WHH3844/CAR_DASHBOARD/Docs/Analysis/05_仪表盘定版测试计划.md

# CAR_DASHBOARD 仪表盘 CAN / UDS / 回归定版测试计划

版本：v1.0  
日期：2026-07-29

## 1. 目标与环境

目标：验证 v1.0 CAN、UDS、Dem、NvM 和控制域接口与代码、矩阵一致。

建议环境：

- Keil MDK ARMCC 5.06 update 7
- GD32F470ZGT6 目标板
- PCAN-USB 或等效 CAN 工具，500 kbit/s
- UDS 测试脚本或 PCAN 手工发送
- 串口日志和 LCD 同时观察
- 可选：S32K144 控制域板

所有数值除特别说明外均以十六进制填写。标准 CAN 信号按矩阵 LE；UDS 多字节数值按 BE。

## 2. 构建回归

| ID | 步骤 | 预期 |
|---|---|---|
| BUILD-01 | 执行 `D:\Keil5\UV4\UV4.exe -b D:\MCU\Project\car\CAR_DASHBOARD\Project\CAR_DASHBOARD.uvprojx -j0 -o D:\MCU\Project\car\CAR_DASHBOARD\Project\Objects\interface_v1_build.log` | 退出码 0，0 error |
| BUILD-02 | 检查 `Project/Objects/CAR_DASHBOARD.hex` | 文件存在且时间戳更新 |
| BUILD-03 | 搜索 interface_v1_build.log 的 warning/error | 不新增接口相关 warning；已有 warning 单独记录 |

## 3. PCAN 接收测试

### 0x321 Powertrain

| 用例 | 发送帧 | 预期 |
|---|---|---|
| CAN-RX-321-01 | `0x321: E8 03 20 03 32 64 28 7D` | 车速 raw=1000 -> 100.0 km/h；转速 800 rpm；其余有效 |
| CAN-RX-321-02 | `0x321: FF 1F FF FF FF FF FF FF` | 六个信号均无效；UI 不出现异常大值 |
| CAN-RX-321-03 | 停止发送超过 100 ms | Powertrain freshness 失效并触发接收超时监控 |

### 0x322 Body

| 用例 | 发送帧 | 预期 |
|---|---|---|
| CAN-RX-322-01 | `0x322: 2D 1F 17 0F 01 80 00 00` | 点火/挡位、四门、安全带、灯光/转向/驻车、四故障灯、洗涤液和环境光均按位显示 |
| CAN-RX-322-02 | `B5=FF` | 环境光无效，其余车身状态仍有效 |
| CAN-RX-322-03 | 停止发送超过 500 ms | 车身报文失效，离散警告回到安全显示状态 |

### 0x323 TPMS

| 用例 | 发送帧 | 预期 |
|---|---|---|
| CAN-RX-323-01 | `0x323: 64 64 64 64 50 50 50 50` | 四轮压力/温度均有效 |
| CAN-RX-323-02 | `0x323: FF 64 FF 64 FF 50 FF 50` | FL/RL 压力和温度无效，FR/RR 保持有效 |
| CAN-RX-323-03 | 停止发送超过 3000 ms | 整帧 freshness 失效 |

### 0x324 Config

| 用例 | 步骤 | 预期 |
|---|---|---|
| CAN-RX-324-01 | 上电读取本地 NvM 后发送合法远端配置 | 本次运行期使用远端合法值 |
| CAN-RX-324-02 | 发送非法亮度/主题/语言 | 非法字段不覆盖当前合法值 |
| CAN-RX-324-03 | 远端覆盖后重启且不再发送 0x324 | 重新使用本地 NvM 基线 |

### 0x329 Control Domain Status

CRC8/J1850 覆盖字节：`29 03 B0 B1 B2 B3 B4 B5 B6`。可直接使用的正常样例：

```text
0x329  DLC=8  10 09 00 53 FF FF 01 67
```

该帧表示 v1.0、ADC、RUN、Health=OK、CAN1/CAN2/ADC/SelfTest 正常、无远端故障、Alive=1，末字节 `0x67` 为 CRC8/J1850。

| 用例 | 步骤 | 预期 |
|---|---|---|
| CAN-RX-329-01 | 发送 `10 09 00 53 FF FF 01 67`，并周期发送 0x441 | UI 显示 CDM Online/OK/ADC/RUN |
| CAN-RX-329-02 | CRC 改错 1 bit | 丢弃帧，不更新时间戳 |
| CAN-RX-329-03 | AliveCounter 固定，连续发送 | 判定发送任务疑似冻结并降级 |
| CAN-RX-329-04 | Version 非 10 | 标记接口版本不兼容 |
| CAN-RX-329-05 | 停止发送超过 1500 ms | 应用状态 stale，本机仪表继续工作 |

### 0x441 NM

| 用例 | 步骤 | 预期 |
|---|---|---|
| CAN-RX-441-01 | 周期发送合法 NM | CDM NM online |
| CAN-RX-441-02 | 停止发送超过 3000 ms | CDM NM offline，不影响 0x329 独立状态机 |

## 4. PCAN 发送测试

| 用例 | 触发 | 预期 |
|---|---|---|
| CAN-TX-325-01 | 正常运行 | 每 100 ms 一帧，字段严格匹配矩阵；无里程源时 B3..4=`FF FF` |
| CAN-TX-326-01 | 无 DTC 正常运行 | DTC count=0，SelfTestPassed 和会话位正确 |
| CAN-TX-326-02 | 注入一个确认 DTC | DTC count/LastFaultId/NvMDirty 与 Dem 一致 |
| CAN-TX-327-01 | 单击按键 | 发送一次事件，Counter +1 |
| CAN-TX-327-02 | 临时阻断发送后恢复 | 事件不丢失，恢复后发送；不重复消费 |
| CAN-TX-440-01 | 正常运行 | NodeAddress=`40`，NMState=NormalOperation |
| CAN-TX-328-01 | 未接 FatFs | 明确显示未挂载/Stub，文件号为 0 |

## 5. UDS 手工测试表

请求 ID：物理 `0x700`，功能 `0x7DF`；响应 `0x708`。下列负载为 UDS payload，使用 PCAN 时需在前面加 ISO-TP SF 长度字节。

| ID | 寻址 | UDS 请求 | 预期 |
|---|---|---|---|
| UDS-10-01 | 物理 | `10 01` | `50 01 ...` |
| UDS-10-02 | 物理 | `10 03` | `50 03 ...` |
| UDS-10-03 | 功能 | `10 03` | NRC，且会话不改变 |
| UDS-22-01 | 物理 | `22 F1 91` | `62 F1 91` + HW ASCII |
| UDS-22-02 | 物理 | `22 F1 93` | `62 F1 93` + SW ASCII |
| UDS-22-03 | 物理 | `22 F2 00` | BootCounter，uint32 BE |
| UDS-22-04 | 物理 | `22 F2 01` | VehicleSpeed，uint16 BE |
| UDS-22-05 | 物理 | `22 F2 02` | EngineSpeed，uint16 BE |
| UDS-22-06 | 物理 | `22 F2 03` | BatteryVoltage mV，uint16 BE |
| UDS-22-07 | 物理 | `22 F2 04` | RTC，年份 uint16 BE |
| UDS-22-08 | 功能 | `22 F2 01` | 允许只读响应 |
| UDS-22-09 | 物理 | `22 FF FF` | NRC RequestOutOfRange |
| UDS-19-01 | 物理 | `19 01 FF` | DTC 数量 |
| UDS-19-02 | 物理 | `19 02 FF` | 当前单帧能力内返回第一项并与矩阵声明一致 |
| UDS-14-01 | 功能 | `14 FF FF FF` | NRC，DTC 不清除 |
| UDS-14-02 | 物理 | `14 FF FF FF` | DTC 清除 |
| UDS-3E-01 | 物理 | `3E 00` | `7E 00` |
| UDS-3E-02 | 功能 | `3E 00` | 允许 keep-alive，不改变配置 |
| UDS-11-01 | 物理 | `11 01` | NRC ServiceNotSupported |

## 6. Dem / NvM 测试

| 用例 | 步骤 | 预期 |
|---|---|---|
| DEM-01 | 注入少于失败阈值的抖动 | 不产生 Confirmed DTC |
| DEM-02 | 连续失败达到阈值 | TestFailed+Confirmed，occurrence +1，LastFaultId 更新 |
| DEM-03 | 失败状态持续多个周期 | occurrence 不按周期持续增加 |
| DEM-04 | 连续通过达到恢复阈值 | TestFailed 清除，Confirmed 保留 |
| DEM-05 | 物理 0x14 清除 | Confirmed、occurrence 和计数清除 |
| NVM-01 | 写入 DTC 后正常重启 | DTC 状态恢复 |
| NVM-02 | 人为破坏块 CRC | 采用默认值，不使用损坏 payload，并产生存储相关诊断 |
| NVM-03 | 系统配置合法写入并重启 | 从 0x720 块恢复 |

## 7. 显示与降级回归

1. 正常动力/车身/TPMS 帧下 UI 数值和图标正确。
2. 任一单信号无效时只影响对应显示，不把整车状态全部清空。
3. 控制域离线时，LCD、按键、RTC、SHT30、本地 UDS 继续工作。
4. 本地故障和远端故障分开展示。
5. 无 FatFs 时不显示“文件日志正常”。
6. 低电压、显示初始化失败、SDRAM 失败等既有故障路径回归。

## 8. 验收记录

| 项目 | 结果 | 证据 |
|---|---|---|
| 工作簿公式错误扫描 | PASS：0 个公式错误 | 两份 v1.0 工作簿全表扫描 |
| 工作簿视觉检查 | PASS：26 个工作表 | CAN 7 张、诊断 19 张逐表渲染检查 |
| Keil 全量构建 | PASS：0 Error(s), 0 Warning(s) | `Project/Objects/interface_v1_build.log` |
| PCAN 手工测试 | 需实板执行 | 本文第 3、4 节 |
| UDS 手工测试 | 需实板执行 | 本文第 5 节 |
| Dem/NvM 断电测试 | 需实板执行 | 本文第 6 节 |

软件侧可自动完成构建和静态一致性检查；需要 PCAN、实板或断电操作的项目由台架测试人员按本表执行并签字。
