WHH3844/CAR_DASHBOARD/Docs/汽车仪表盘_CAN报文矩阵.xlsx

Sheet: ReadMe
汽车仪表盘 CAN 报文矩阵说明
项目定位 | 基于 GD32F470/GD32F450 + SIT1043QT CAN 收发器的汽车仪表盘学习板，采用 Mini AUTOSAR / AUTOSAR-like 软件架构。
设计目标 | 用于 USB-CAN / 仿真节点发送车辆数据，ICM 仪表接收后显示车速、转速、报警灯、胎压、配置、诊断状态等。
帧格式 | 本版默认使用 Standard CAN 11-bit ID，DLC=8。虽然硬件 CAN 收发器支持 CAN FD 物理层，但 MCU 外设与教学实现优先按 Classic CAN 设计。
字节序 | 默认 Intel LSB，小端格式，方便 GD32/STM32 C 代码打包解析。若后续接真实整车 DBC，需要按对方 DBC 调整。
物理值换算 | Physical = Raw × Resolution + Offset；Raw = (Physical - Offset) / Resolution。Convert 表已给出示例公式。
节点定义 | ICM 为本仪表节点；EMS/BCM/TPMS/IHU/CGW 可由 USB-CAN 上位机或另一块 MCU 模拟。
重要说明 | 这是一版教学与调试用 CAN 矩阵，不是整车厂正式 DBC。先用它把仪表 Demo、RTE/Com、诊断雏形跑通，别又把工程做成大型玄学祭坛。

Sheet: History
版本 | 日期 | 修改人 | 修改内容 | 备注
V0.1 | 2026-05-30 | ChatGPT | 首次建立汽车仪表盘 CAN 报文矩阵 | 参考 Loxi Micro 表格风格，结合当前 ICM 学习板硬件与 Mini AUTOSAR-like 软件架构

Sheet: MsgSummary
Msg ID | Frame Format | BRS | Direction | Tx Node | Rx Node | Msg Name | Msg Type | DLC | Send Type | Cycle(ms) | Delay(ms) | Signal Count | Purpose/Description
0x440 | StandardCAN | 0 | Tx | ICM | All | NM_Autosar_ICM | NM | 8 | Cyclic/Event | 1000 | 0 | 5 | ICM 节点网络管理报文，Mini AUTOSAR-like 学习用
0x441 | StandardCAN | 0 | Rx | SIM/OtherECU | ICM | NM_Autosar_Sim | NM | 8 | Cyclic/Event | 1000 | 0 | 6 | 仿真节点网络管理报文，USB-CAN 或其他节点发送
0x7DF | StandardCAN | 0 | Rx | Tester | ICM/All | Diag_FuncReq | DIAG | 8 | Event | 0 | 0 | 1 | UDS 功能寻址请求，教学级 ISO-TP
0x700 | StandardCAN | 0 | Rx | Tester | ICM | Diag_ICM_PhysReq | DIAG | 8 | Event | 0 | 0 | 1 | UDS 物理寻址请求
0x708 | StandardCAN | 0 | Tx | ICM | Tester | Diag_ICM_Resp | DIAG | 8 | Event | 0 | 0 | 1 | UDS 物理响应
0x321 | StandardCAN | 0 | Rx | EMS/Simulator | ICM | EMS_Powertrain_20ms | DIAG/SIGNAL | 8 | Cyclic | 20 | 0 | 6 | 动力总成与基础车辆数据，用于仪表主界面显示
0x322 | StandardCAN | 0 | Rx | BCM/Simulator | ICM | BCM_BodyStatus_100ms | SIGNAL | 8 | Cyclic/Event | 100 | 0 | 17 | 车身状态与报警灯状态
0x323 | StandardCAN | 0 | Rx | TPMS/Simulator | ICM | TPMS_Status_1000ms | SIGNAL | 8 | Cyclic | 1000 | 0 | 8 | 胎压与胎温状态
0x324 | StandardCAN | 0 | Rx | IHU/CGW/Simulator | ICM | IHU_CGW_Config_500ms | SIGNAL | 8 | Cyclic/Event | 500 | 0 | 9 | 中控/网关发送的仪表配置与主题信息
0x325 | StandardCAN | 0 | Tx | ICM | CGW/Tester | ICM_Status_100ms | SIGNAL | 8 | Cyclic/Event | 100 | 0 | 8 | 仪表运行状态与用户显示状态
0x326 | StandardCAN | 0 | Tx | ICM | CGW/Tester | ICM_DiagStatus_1000ms | DIAG/SIGNAL | 8 | Cyclic/Event | 1000 | 0 | 10 | 仪表自检与故障管理状态
0x327 | StandardCAN | 0 | Tx | ICM | CGW/Tester | ICM_UserInput_Event | SIGNAL | 8 | Event | 0 | 0 | 6 | 按键事件报文，短按/长按/关机请求
0x328 | StandardCAN | 0 | Tx | ICM | CGW/Tester | ICM_LogStatus_1000ms | SIGNAL | 8 | Cyclic/Event | 1000 | 0 | 5 | 日志与 TF 卡状态

Sheet: Matrix
Msg ID 报文标识符 | Frame Format 帧格式 | BRS 波特率切换 | Direction 方向 | Tx Node 发送节点 | Rx Node 接收节点 | Msg Name 报文名称 | Msg Type 报文类型 | Msg Length 报文长度(Byte) | Msg Send Type 报文发送类型 | Msg Cycle Time 周期(ms) | Msg Delay Time 延时(ms) | Signal Name 信号名称 | Multiplexor Type 信号复用类型 | Multiplexed Value 复用值 | Start Byte 起始字节 | Start Bit 起始位 | Bit Length 位长度 | Byte Order 字节序 | Data Type 数据类型 | Resolution 精度 | Offset 偏移 | Signal Min 物理最小值 | Signal Max 物理最大值 | Initial Value(hex) 初始值 | Invalid Value(hex) 无效值 | Unit 单位 | Signal Value Description 信号值描述 | Signal Description 信号描述 | Signal Send Type 信号发送类型 | Remark 备注
0x440 | StandardCAN | 0 | Tx | ICM | All | NM_Autosar_ICM | NM | 8 | Cyclic/Event | 1000 | 0 | ICM_NodeAddress | Normal Signal |  | 0 | 0 | 8 | Intel LSB | Unsigned | 1 | 0 | 0 | 255 | 0x40 | 0xFF |  | 0x40: ICM Node | ICM 节点地址 | OnWrite
0x440 | StandardCAN | 0 | Tx | ICM | All | NM_Autosar_ICM | NM | 8 | Cyclic/Event | 1000 | 0 | ICM_RepeatMessageRequestBit | Normal Signal |  | 1 | 0 | 1 | Intel LSB | Unsigned | 1 | 0 | 0 | 1 | 0x0 | 0x0 |  | 0x0: No Request; 0x1: Request | 重复报文请求位 | OnWrite
0x440 | StandardCAN | 0 | Tx | ICM | All | NM_Autosar_ICM | NM | 8 | Cyclic/Event | 1000 | 0 | ICM_ActiveWakeupBit | Normal Signal |  | 1 | 1 | 1 | Intel LSB | Unsigned | 1 | 0 | 0 | 1 | 0x0 | 0x0 |  | 0x0: Passive Wakeup; 0x1: Active Wakeup | 主动唤醒标志 | OnWrite
0x440 | StandardCAN | 0 | Tx | ICM | All | NM_Autosar_ICM | NM | 8 | Cyclic/Event | 1000 | 0 | ICM_RepeatSts | Normal Signal |  | 2 | 0 | 1 | Intel LSB | Unsigned | 1 | 0 | 0 | 1 | 0x0 | 0x0 |  | 0x0: Not in RMS; 0x1: Stay in RMS | Repeat Message 状态 | OnWrite
0x440 | StandardCAN | 0 | Tx | ICM | All | NM_Autosar_ICM | NM | 8 | Cyclic/Event | 1000 | 0 | ICM_NMState | Normal Signal |  | 2 | 1 | 3 | Intel LSB | Unsigned | 1 | 0 | 0 | 7 | 0x0 | 0x7 |  | 0x0: BusSleep; 0x1: RepeatMessage; 0x2: NormalOperation; 0x3: ReadySleep | 网络管理状态 | OnWrite
0x441 | StandardCAN | 0 | Rx | SIM/OtherECU | ICM | NM_Autosar_Sim | NM | 8 | Cyclic/Event | 1000 | 0 | SIM_NodeAddress | Normal Signal |  | 0 | 0 | 8 | Intel LSB | Unsigned | 1 | 0 | 0 | 255 | 0x41 | 0xFF |  | 0x41: Simulator Node | 仿真节点地址 | OnWrite
0x441 | StandardCAN | 0 | Rx | SIM/OtherECU | ICM | NM_Autosar_Sim | NM | 8 | Cyclic/Event | 1000 | 0 | SIM_RepeatMessageRequestBit | Normal Signal |  | 1 | 0 | 1 | Intel LSB | Unsigned | 1 | 0 | 0 | 1 | 0x0 | 0x0 |  | 0x0: No Request; 0x1: Request | 重复报文请求位 | OnWrite
0x441 | StandardCAN | 0 | Rx | SIM/OtherECU | ICM | NM_Autosar_Sim | NM | 8 | Cyclic/Event | 1000 | 0 | SIM_ActiveWakeupBit | Normal Signal |  | 1 | 1 | 1 | Intel LSB | Unsigned | 1 | 0 | 0 | 1 | 0x0 | 0x0 |  | 0x0: Passive Wakeup; 0x1: Active Wakeup | 主动唤醒标志 | OnWrite
0x441 | StandardCAN | 0 | Rx | SIM/OtherECU | ICM | NM_Autosar_Sim | NM | 8 | Cyclic/Event | 1000 | 0 | SIM_RepeatSts | Normal Signal |  | 2 | 0 | 1 | Intel LSB | Unsigned | 1 | 0 | 0 | 1 | 0x0 | 0x0 |  | 0x0: Not in RMS; 0x1: Stay in RMS | Repeat Message 状态 | OnWrite
0x441 | StandardCAN | 0 | Rx | SIM/OtherECU | ICM | NM_Autosar_Sim | NM | 8 | Cyclic/Event | 1000 | 0 | SIM_NMReq_PowerOn | Normal Signal |  | 2 | 1 | 1 | Intel LSB | Unsigned | 1 | 0 | 0 | 1 | 0x0 | 0x0 |  | 0x0: Inactive; 0x1: Active | 仿真节点请求系统保持唤醒 | OnWrite
0x441 | StandardCAN | 0 | Rx | SIM/OtherECU | ICM | NM_Autosar_Sim | NM | 8 | Cyclic/Event | 1000 | 0 | SIM_NMReq_Diag | Normal Signal |  | 2 | 2 | 1 | Intel LSB | Unsigned | 1 | 0 | 0 | 1 | 0x0 | 0x0 |  | 0x0: Inactive; 0x1: Active | 诊断请求网络保持 | OnWrite
0x7DF | StandardCAN | 0 | Rx | Tester | ICM/All | Diag_FuncReq | DIAG | 8 | Event | 0 | 0 | Diag_FuncReq_Data | Normal Signal |  | 0 | 0 | 64 | Intel LSB | Unsigned | 1 | 0 | 0 | 0 | 0x00 | 0x00 |  |  | 诊断功能寻址请求原始 8 字节数据 | OnWrite | 第一阶段可只透传到 Dcm
0x700 | StandardCAN | 0 | Rx | Tester | ICM | Diag_ICM_PhysReq | DIAG | 8 | Event | 0 | 0 | Diag_ICM_PhyReq_Data | Normal Signal |  | 0 | 0 | 64 | Intel LSB | Unsigned | 1 | 0 | 0 | 0 | 0x00 | 0x00 |  |  | 诊断物理寻址请求原始 8 字节数据 | OnWrite | 支持 0x10/0x22/0x19/0x14/0x31 子集
0x708 | StandardCAN | 0 | Tx | ICM | Tester | Diag_ICM_Resp | DIAG | 8 | Event | 0 | 0 | Diag_ICM_Resp_Data | Normal Signal |  | 0 | 0 | 64 | Intel LSB | Unsigned | 1 | 0 | 0 | 0 | 0x00 | 0x00 |  |  | 诊断响应原始 8 字节数据 | OnWrite | 由 Dcm/CanTp 生成
0x321 | StandardCAN | 0 | Rx | EMS/Simulator | ICM | EMS_Powertrain_20ms | DIAG/SIGNAL | 8 | Cyclic | 20 | 0 | VehicleSpeed | Normal Signal |  | 0 | 0 | 13 | Intel LSB | Unsigned | 0.0625 | 0 | 0 | 511.875 | 0x0000 | 0x1FFF | km/h |  | 车速 | OnWrite | raw = speed / 0.0625
0x321 | StandardCAN | 0 | Rx | EMS/Simulator | ICM | EMS_Powertrain_20ms | DIAG/SIGNAL | 8 | Cyclic | 20 | 0 | EngineSpeed | Normal Signal |  | 2 | 0 | 16 | Intel LSB | Unsigned | 0.25 | 0 | 0 | 16000 | 0x0000 | 0xFFFF | rpm |  | 发动机转速 | OnWrite | raw = rpm / 0.25
0x321 | StandardCAN | 0 | Rx | EMS/Simulator | ICM | EMS_Powertrain_20ms | DIAG/SIGNAL | 8 | Cyclic | 20 | 0 | FuelPercent | Normal Signal |  | 4 | 0 | 8 | Intel LSB | Unsigned | 0.4 | 0 | 0 | 100 | 0x00 | 0xFF | % |  | 油量百分比 | OnWrite | raw 250 = 100%
0x321 | StandardCAN | 0 | Rx | EMS/Simulator | ICM | EMS_Powertrain_20ms | DIAG/SIGNAL | 8 | Cyclic | 20 | 0 | EngineCoolantTemperature | Normal Signal |  | 5 | 0 | 8 | Intel LSB | Signed/Offset | 1 | -40 | -40 | 215 | 0x28 | 0xFF | ℃ |  | 水温，物理值 = raw - 40 | OnWrite
0x321 | StandardCAN | 0 | Rx | EMS/Simulator | ICM | EMS_Powertrain_20ms | DIAG/SIGNAL | 8 | Cyclic | 20 | 0 | OutdoorTemperature | Normal Signal |  | 6 | 0 | 8 | Intel LSB | Signed/Offset | 1 | -40 | -40 | 85 | 0x28 | 0xFF | ℃ |  | 车外温度，物理值 = raw - 40 | OnWrite
0x321 | StandardCAN | 0 | Rx | EMS/Simulator | ICM | EMS_Powertrain_20ms | DIAG/SIGNAL | 8 | Cyclic | 20 | 0 | BatteryVoltage | Normal Signal |  | 7 | 0 | 8 | Intel LSB | Unsigned | 0.1 | 0 | 0 | 25.5 | 0x78 | 0xFF | V |  | 整车/板载供电电压，用于欠压提示 | OnWrite
0x322 | StandardCAN | 0 | Rx | BCM/Simulator | ICM | BCM_BodyStatus_100ms | SIGNAL | 8 | Cyclic/Event | 100 | 0 | IgnitionStatus | Normal Signal |  | 0 | 0 | 2 | Intel LSB | Unsigned | 1 | 0 | 0 | 3 | 0x0 | 0x3 |  | 0x0: OFF; 0x1: ACC; 0x2: ON; 0x3: START | 点火状态 | OnWrite
0x322 | StandardCAN | 0 | Rx | BCM/Simulator | ICM | BCM_BodyStatus_100ms | SIGNAL | 8 | Cyclic/Event | 100 | 0 | GearPosition | Normal Signal |  | 0 | 2 | 4 | Intel LSB | Unsigned | 1 | 0 | 0 | 15 | 0x0 | 0xF |  | 0x0: P; 0x1: R; 0x2: N; 0x3: D; 0x4: S; 0x5: M | 挡位 | OnWrite
0x322 | StandardCAN | 0 | Rx | BCM/Simulator | ICM | BCM_BodyStatus_100ms | SIGNAL | 8 | Cyclic/Event | 100 | 0 | Door_FL_Open | Normal Signal |  | 1 | 0 | 1 | Intel LSB | Unsigned | 1 | 0 | 0 | 1 | 0x0 | 0x0 |  | 0x0: Closed; 0x1: Open | 左前门状态 | OnWrite
0x322 | StandardCAN | 0 | Rx | BCM/Simulator | ICM | BCM_BodyStatus_100ms | SIGNAL | 8 | Cyclic/Event | 100 | 0 | Door_FR_Open | Normal Signal |  | 1 | 1 | 1 | Intel LSB | Unsigned | 1 | 0 | 0 | 1 | 0x0 | 0x0 |  | 0x0: Closed; 0x1: Open | 右前门状态 | OnWrite
0x322 | StandardCAN | 0 | Rx | BCM/Simulator | ICM | BCM_BodyStatus_100ms | SIGNAL | 8 | Cyclic/Event | 100 | 0 | Door_RL_Open | Normal Signal |  | 1 | 2 | 1 | Intel LSB | Unsigned | 1 | 0 | 0 | 1 | 0x0 | 0x0 |  | 0x0: Closed; 0x1: Open | 左后门状态 | OnWrite
0x322 | StandardCAN | 0 | Rx | BCM/Simulator | ICM | BCM_BodyStatus_100ms | SIGNAL | 8 | Cyclic/Event | 100 | 0 | Door_RR_Open | Normal Signal |  | 1 | 3 | 1 | Intel LSB | Unsigned | 1 | 0 | 0 | 1 | 0x0 | 0x0 |  | 0x0: Closed; 0x1: Open | 右后门状态 | OnWrite
0x322 | StandardCAN | 0 | Rx | BCM/Simulator | ICM | BCM_BodyStatus_100ms | SIGNAL | 8 | Cyclic/Event | 100 | 0 | SeatbeltDriver | Normal Signal |  | 1 | 4 | 1 | Intel LSB | Unsigned | 1 | 0 | 0 | 1 | 0x0 | 0x0 |  | 0x0: Buckled; 0x1: Unbuckled | 主驾安全带 | OnWrite
0x322 | StandardCAN | 0 | Rx | BCM/Simulator | ICM | BCM_BodyStatus_100ms | SIGNAL | 8 | Cyclic/Event | 100 | 0 | LowBeamStatus | Normal Signal |  | 2 | 0 | 1 | Intel LSB | Unsigned | 1 | 0 | 0 | 1 | 0x0 | 0x0 |  | 0x0: Off; 0x1: On | 近光灯 | OnWrite
0x322 | StandardCAN | 0 | Rx | BCM/Simulator | ICM | BCM_BodyStatus_100ms | SIGNAL | 8 | Cyclic/Event | 100 | 0 | HighBeamStatus | Normal Signal |  | 2 | 1 | 1 | Intel LSB | Unsigned | 1 | 0 | 0 | 1 | 0x0 | 0x0 |  | 0x0: Off; 0x1: On | 远光灯 | OnWrite
0x322 | StandardCAN | 0 | Rx | BCM/Simulator | ICM | BCM_BodyStatus_100ms | SIGNAL | 8 | Cyclic/Event | 100 | 0 | TurnLampStatus | Normal Signal |  | 2 | 2 | 2 | Intel LSB | Unsigned | 1 | 0 | 0 | 3 | 0x0 | 0x3 |  | 0x0: Off; 0x1: Left; 0x2: Right; 0x3: Hazard | 转向灯/双闪状态 | OnWrite
0x322 | StandardCAN | 0 | Rx | BCM/Simulator | ICM | BCM_BodyStatus_100ms | SIGNAL | 8 | Cyclic/Event | 100 | 0 | ParkingBrake | Normal Signal |  | 2 | 4 | 1 | Intel LSB | Unsigned | 1 | 0 | 0 | 1 | 0x0 | 0x0 |  | 0x0: Released; 0x1: Applied | 驻车制动 | OnWrite
0x322 | StandardCAN | 0 | Rx | BCM/Simulator | ICM | BCM_BodyStatus_100ms | SIGNAL | 8 | Cyclic/Event | 100 | 0 | MIL_Lamp | Normal Signal |  | 3 | 0 | 1 | Intel LSB | Unsigned | 1 | 0 | 0 | 1 | 0x0 | 0x0 |  | 0x0: Off; 0x1: On | 发动机故障灯 | OnWrite
0x322 | StandardCAN | 0 | Rx | BCM/Simulator | ICM | BCM_BodyStatus_100ms | SIGNAL | 8 | Cyclic/Event | 100 | 0 | ABS_Lamp | Normal Signal |  | 3 | 1 | 1 | Intel LSB | Unsigned | 1 | 0 | 0 | 1 | 0x0 | 0x0 |  | 0x0: Off; 0x1: On | ABS 故障灯 | OnWrite
0x322 | StandardCAN | 0 | Rx | BCM/Simulator | ICM | BCM_BodyStatus_100ms | SIGNAL | 8 | Cyclic/Event | 100 | 0 | Airbag_Lamp | Normal Signal |  | 3 | 2 | 1 | Intel LSB | Unsigned | 1 | 0 | 0 | 1 | 0x0 | 0x0 |  | 0x0: Off; 0x1: On | 安全气囊故障灯 | OnWrite
0x322 | StandardCAN | 0 | Rx | BCM/Simulator | ICM | BCM_BodyStatus_100ms | SIGNAL | 8 | Cyclic/Event | 100 | 0 | Brake_Lamp | Normal Signal |  | 3 | 3 | 1 | Intel LSB | Unsigned | 1 | 0 | 0 | 1 | 0x0 | 0x0 |  | 0x0: Off; 0x1: On | 制动系统故障灯 | OnWrite
0x322 | StandardCAN | 0 | Rx | BCM/Simulator | ICM | BCM_BodyStatus_100ms | SIGNAL | 8 | Cyclic/Event | 100 | 0 | WasherFluidLow | Normal Signal |  | 4 | 0 | 1 | Intel LSB | Unsigned | 1 | 0 | 0 | 1 | 0x0 | 0x0 |  | 0x0: Normal; 0x1: Low | 玻璃水液位低 | OnWrite
0x322 | StandardCAN | 0 | Rx | BCM/Simulator | ICM | BCM_BodyStatus_100ms | SIGNAL | 8 | Cyclic/Event | 100 | 0 | AmbientLightLevel | Normal Signal |  | 5 | 0 | 8 | Intel LSB | Unsigned | 1 | 0 | 0 | 100 | 0x32 | 0xFF | % |  | 环境光强度百分比，可用于自动背光 | OnWrite
0x323 | StandardCAN | 0 | Rx | TPMS/Simulator | ICM | TPMS_Status_1000ms | SIGNAL | 8 | Cyclic | 1000 | 0 | LF_TirePressure | Normal Signal |  | 0 | 0 | 8 | Intel LSB | Unsigned | 0.0275 | 0 | 0 | 3.5 | 0x00 | 0xFF | Bar |  | 左前胎压 | OnWrite
0x323 | StandardCAN | 0 | Rx | TPMS/Simulator | ICM | TPMS_Status_1000ms | SIGNAL | 8 | Cyclic | 1000 | 0 | RF_TirePressure | Normal Signal |  | 1 | 0 | 8 | Intel LSB | Unsigned | 0.0275 | 0 | 0 | 3.5 | 0x00 | 0xFF | Bar |  | 右前胎压 | OnWrite
0x323 | StandardCAN | 0 | Rx | TPMS/Simulator | ICM | TPMS_Status_1000ms | SIGNAL | 8 | Cyclic | 1000 | 0 | LR_TirePressure | Normal Signal |  | 2 | 0 | 8 | Intel LSB | Unsigned | 0.0275 | 0 | 0 | 3.5 | 0x00 | 0xFF | Bar |  | 左后胎压 | OnWrite
0x323 | StandardCAN | 0 | Rx | TPMS/Simulator | ICM | TPMS_Status_1000ms | SIGNAL | 8 | Cyclic | 1000 | 0 | RR_TirePressure | Normal Signal |  | 3 | 0 | 8 | Intel LSB | Unsigned | 0.0275 | 0 | 0 | 3.5 | 0x00 | 0xFF | Bar |  | 右后胎压 | OnWrite
0x323 | StandardCAN | 0 | Rx | TPMS/Simulator | ICM | TPMS_Status_1000ms | SIGNAL | 8 | Cyclic | 1000 | 0 | LF_TireTemperature | Normal Signal |  | 4 | 0 | 8 | Intel LSB | Signed/Offset | 1 | -40 | -40 | 125 | 0x28 | 0xFF | ℃ |  | 左前胎温，物理值 = raw - 40 | OnWrite
0x323 | StandardCAN | 0 | Rx | TPMS/Simulator | ICM | TPMS_Status_1000ms | SIGNAL | 8 | Cyclic | 1000 | 0 | RF_TireTemperature | Normal Signal |  | 5 | 0 | 8 | Intel LSB | Signed/Offset | 1 | -40 | -40 | 125 | 0x28 | 0xFF | ℃ |  | 右前胎温，物理值 = raw - 40 | OnWrite
0x323 | StandardCAN | 0 | Rx | TPMS/Simulator | ICM | TPMS_Status_1000ms | SIGNAL | 8 | Cyclic | 1000 | 0 | LR_TireTemperature | Normal Signal |  | 6 | 0 | 8 | Intel LSB | Signed/Offset | 1 | -40 | -40 | 125 | 0x28 | 0xFF | ℃ |  | 左后胎温，物理值 = raw - 40 | OnWrite
0x323 | StandardCAN | 0 | Rx | TPMS/Simulator | ICM | TPMS_Status_1000ms | SIGNAL | 8 | Cyclic | 1000 | 0 | RR_TireTemperature | Normal Signal |  | 7 | 0 | 8 | Intel LSB | Signed/Offset | 1 | -40 | -40 | 125 | 0x28 | 0xFF | ℃ |  | 右后胎温，物理值 = raw - 40 | OnWrite
0x324 | StandardCAN | 0 | Rx | IHU/CGW/Simulator | ICM | IHU_CGW_Config_500ms | SIGNAL | 8 | Cyclic/Event | 500 | 0 | ThemeMode | Normal Signal |  | 0 | 0 | 3 | Intel LSB | Unsigned | 1 | 0 | 0 | 7 | 0x0 | 0x7 |  | 0x0: Auto; 0x1: Classic; 0x2: Sport; 0x3: Night | 仪表主题模式 | OnWrite
0x324 | StandardCAN | 0 | Rx | IHU/CGW/Simulator | ICM | IHU_CGW_Config_500ms | SIGNAL | 8 | Cyclic/Event | 500 | 0 | SetLanguage | Normal Signal |  | 0 | 3 | 3 | Intel LSB | Unsigned | 1 | 0 | 0 | 7 | 0x0 | 0x7 |  | 0x0: zh_CN; 0x1: en_US | 显示语言 | OnWrite
0x324 | StandardCAN | 0 | Rx | IHU/CGW/Simulator | ICM | IHU_CGW_Config_500ms | SIGNAL | 8 | Cyclic/Event | 500 | 0 | UnitMode | Normal Signal |  | 0 | 6 | 2 | Intel LSB | Unsigned | 1 | 0 | 0 | 3 | 0x0 | 0x3 |  | 0x0: Metric; 0x1: Imperial | 单位制 | OnWrite
0x324 | StandardCAN | 0 | Rx | IHU/CGW/Simulator | ICM | IHU_CGW_Config_500ms | SIGNAL | 8 | Cyclic/Event | 500 | 0 | BacklightLevelSet | Normal Signal |  | 1 | 0 | 8 | Intel LSB | Unsigned | 1 | 0 | 0 | 100 | 0x64 | 0xFF | % |  | 背光目标亮度 | OnWrite
0x324 | StandardCAN | 0 | Rx | IHU/CGW/Simulator | ICM | IHU_CGW_Config_500ms | SIGNAL | 8 | Cyclic/Event | 500 | 0 | WarningVolumeSet | Normal Signal |  | 2 | 0 | 8 | Intel LSB | Unsigned | 1 | 0 | 0 | 100 | 0x50 | 0xFF | % |  | 蜂鸣器报警音量目标值 | OnWrite
0x324 | StandardCAN | 0 | Rx | IHU/CGW/Simulator | ICM | IHU_CGW_Config_500ms | SIGNAL | 8 | Cyclic/Event | 500 | 0 | DrivingRange | Normal Signal |  | 3 | 0 | 16 | Intel LSB | Unsigned | 1 | 0 | 0 | 9999 | 0x0000 | 0xFFFF | km |  | 续航里程 | OnWrite
0x324 | StandardCAN | 0 | Rx | IHU/CGW/Simulator | ICM | IHU_CGW_Config_500ms | SIGNAL | 8 | Cyclic/Event | 500 | 0 | DateTimeValid | Normal Signal |  | 5 | 0 | 1 | Intel LSB | Unsigned | 1 | 0 | 0 | 1 | 0x0 | 0x0 |  | 0x0: Invalid; 0x1: Valid | 外部时间同步有效标志 | OnWrite
0x324 | StandardCAN | 0 | Rx | IHU/CGW/Simulator | ICM | IHU_CGW_Config_500ms | SIGNAL | 8 | Cyclic/Event | 500 | 0 | TimeHour | Normal Signal |  | 6 | 0 | 5 | Intel LSB | Unsigned | 1 | 0 | 0 | 23 | 0x00 | 0x1F | h |  | 小时 | OnWrite
0x324 | StandardCAN | 0 | Rx | IHU/CGW/Simulator | ICM | IHU_CGW_Config_500ms | SIGNAL | 8 | Cyclic/Event | 500 | 0 | TimeMinute | Normal Signal |  | 7 | 0 | 6 | Intel LSB | Unsigned | 1 | 0 | 0 | 59 | 0x00 | 0x3F | min |  | 分钟 | OnWrite
0x325 | StandardCAN | 0 | Tx | ICM | CGW/Tester | ICM_Status_100ms | SIGNAL | 8 | Cyclic/Event | 100 | 0 | ICM_Mode | Normal Signal |  | 0 | 0 | 3 | Intel LSB | Unsigned | 1 | 0 | 0 | 7 | 0x0 | 0x7 |  | 0x0: Boot; 0x1: SelfTest; 0x2: Run; 0x3: Diag; 0x4: Fault; 0x5: SleepPrepare | 仪表系统状态机 | OnWrite
0x325 | StandardCAN | 0 | Tx | ICM | CGW/Tester | ICM_Status_100ms | SIGNAL | 8 | Cyclic/Event | 100 | 0 | DisplayPage | Normal Signal |  | 0 | 3 | 3 | Intel LSB | Unsigned | 1 | 0 | 0 | 7 | 0x0 | 0x7 |  | 0x0: Boot; 0x1: Main; 0x2: Warning; 0x3: Setting | 当前显示页面 | OnWrite
0x325 | StandardCAN | 0 | Tx | ICM | CGW/Tester | ICM_Status_100ms | SIGNAL | 8 | Cyclic/Event | 100 | 0 | BuzzerStatus | Normal Signal |  | 1 | 0 | 2 | Intel LSB | Unsigned | 1 | 0 | 0 | 3 | 0x0 | 0x3 |  | 0x0: Off; 0x1: ShortBeep; 0x2: LongBeep; 0x3: Continuous | 蜂鸣器状态 | OnWrite
0x325 | StandardCAN | 0 | Tx | ICM | CGW/Tester | ICM_Status_100ms | SIGNAL | 8 | Cyclic/Event | 100 | 0 | BacklightActual | Normal Signal |  | 2 | 0 | 8 | Intel LSB | Unsigned | 1 | 0 | 0 | 100 | 0x64 | 0xFF | % |  | 实际背光亮度 | OnWrite
0x325 | StandardCAN | 0 | Tx | ICM | CGW/Tester | ICM_Status_100ms | SIGNAL | 8 | Cyclic/Event | 100 | 0 | TripDistance | Normal Signal |  | 3 | 0 | 16 | Intel LSB | Unsigned | 0.1 | 0 | 0 | 6553.5 | 0x0000 | 0xFFFF | km |  | 小计里程 | OnWrite | 由 APP 计算，可掉电保存到 NvM
0x325 | StandardCAN | 0 | Tx | ICM | CGW/Tester | ICM_Status_100ms | SIGNAL | 8 | Cyclic/Event | 100 | 0 | DriveTime | Normal Signal |  | 5 | 0 | 16 | Intel LSB | Unsigned | 1 | 0 | 0 | 65535 | 0x0000 | 0xFFFF | min |  | 本次行驶时间 | OnWrite
0x325 | StandardCAN | 0 | Tx | ICM | CGW/Tester | ICM_Status_100ms | SIGNAL | 8 | Cyclic/Event | 100 | 0 | ShutdownRequest | Normal Signal |  | 7 | 0 | 1 | Intel LSB | Unsigned | 1 | 0 | 0 | 1 | 0x0 | 0x0 |  | 0x0: No Request; 0x1: Request | 仪表请求关机 | OnWrite
0x325 | StandardCAN | 0 | Tx | ICM | CGW/Tester | ICM_Status_100ms | SIGNAL | 8 | Cyclic/Event | 100 | 0 | FaultLampRequest | Normal Signal |  | 7 | 1 | 1 | Intel LSB | Unsigned | 1 | 0 | 0 | 1 | 0x0 | 0x0 |  | 0x0: Off; 0x1: On | 仪表综合故障灯请求 | OnWrite
0x326 | StandardCAN | 0 | Tx | ICM | CGW/Tester | ICM_DiagStatus_1000ms | DIAG/SIGNAL | 8 | Cyclic/Event | 1000 | 0 | DtcCount | Normal Signal |  | 0 | 0 | 8 | Intel LSB | Unsigned | 1 | 0 | 0 | 255 | 0x00 | 0xFF |  |  | 当前已确认故障数量 | OnWrite
0x326 | StandardCAN | 0 | Tx | ICM | CGW/Tester | ICM_DiagStatus_1000ms | DIAG/SIGNAL | 8 | Cyclic/Event | 1000 | 0 | LastDtcCode | Normal Signal |  | 1 | 0 | 16 | Intel LSB | Unsigned | 1 | 0 | 0 | 65535 | 0x0000 | 0xFFFF |  |  | 最近一次故障码编号 | OnWrite
0x326 | StandardCAN | 0 | Tx | ICM | CGW/Tester | ICM_DiagStatus_1000ms | DIAG/SIGNAL | 8 | Cyclic/Event | 1000 | 0 | PowerOnCount | Normal Signal |  | 3 | 0 | 16 | Intel LSB | Unsigned | 1 | 0 | 0 | 65535 | 0x0000 | 0xFFFF | count |  | 上电次数，来自 NvM | OnWrite
0x326 | StandardCAN | 0 | Tx | ICM | CGW/Tester | ICM_DiagStatus_1000ms | DIAG/SIGNAL | 8 | Cyclic/Event | 1000 | 0 | SdramStatus | Normal Signal |  | 5 | 0 | 1 | Intel LSB | Unsigned | 1 | 0 | 0 | 1 | 0x0 | 0x0 |  | 0x0: Failed; 0x1: Passed | SDRAM 自检状态 | OnWrite
0x326 | StandardCAN | 0 | Tx | ICM | CGW/Tester | ICM_DiagStatus_1000ms | DIAG/SIGNAL | 8 | Cyclic/Event | 1000 | 0 | LcdStatus | Normal Signal |  | 5 | 1 | 1 | Intel LSB | Unsigned | 1 | 0 | 0 | 1 | 0x0 | 0x0 |  | 0x0: Failed; 0x1: Passed | LCD 初始化状态 | OnWrite
0x326 | StandardCAN | 0 | Tx | ICM | CGW/Tester | ICM_DiagStatus_1000ms | DIAG/SIGNAL | 8 | Cyclic/Event | 1000 | 0 | RtcStatus | Normal Signal |  | 5 | 2 | 1 | Intel LSB | Unsigned | 1 | 0 | 0 | 1 | 0x0 | 0x0 |  | 0x0: Failed; 0x1: Passed | RTC 通信状态 | OnWrite
0x326 | StandardCAN | 0 | Tx | ICM | CGW/Tester | ICM_DiagStatus_1000ms | DIAG/SIGNAL | 8 | Cyclic/Event | 1000 | 0 | EepromStatus | Normal Signal |  | 5 | 3 | 1 | Intel LSB | Unsigned | 1 | 0 | 0 | 1 | 0x0 | 0x0 |  | 0x0: Failed; 0x1: Passed | EEPROM/NvM 状态 | OnWrite
0x326 | StandardCAN | 0 | Tx | ICM | CGW/Tester | ICM_DiagStatus_1000ms | DIAG/SIGNAL | 8 | Cyclic/Event | 1000 | 0 | TfCardStatus | Normal Signal |  | 5 | 4 | 1 | Intel LSB | Unsigned | 1 | 0 | 0 | 1 | 0x0 | 0x0 |  | 0x0: Failed; 0x1: Passed | TF/FATFS 状态 | OnWrite
0x326 | StandardCAN | 0 | Tx | ICM | CGW/Tester | ICM_DiagStatus_1000ms | DIAG/SIGNAL | 8 | Cyclic/Event | 1000 | 0 | CanBusOffCounter | Normal Signal |  | 6 | 0 | 8 | Intel LSB | Unsigned | 1 | 0 | 0 | 255 | 0x00 | 0xFF | count |  | CAN Bus-Off 计数 | OnWrite
0x326 | StandardCAN | 0 | Tx | ICM | CGW/Tester | ICM_DiagStatus_1000ms | DIAG/SIGNAL | 8 | Cyclic/Event | 1000 | 0 | ResetReason | Normal Signal |  | 7 | 0 | 4 | Intel LSB | Unsigned | 1 | 0 | 0 | 15 | 0x0 | 0xF |  | 0x0: POR; 0x1: NRST; 0x2: IWDG; 0x3: Software; 0x4: BrownOut | 最近一次复位原因 | OnWrite
0x327 | StandardCAN | 0 | Tx | ICM | CGW/Tester | ICM_UserInput_Event | SIGNAL | 8 | Event | 0 | 0 | KeyCode | Normal Signal |  | 0 | 0 | 8 | Intel LSB | Unsigned | 1 | 0 | 0 | 255 | 0x00 | 0xFF |  | 0x0: None; 0x1: KEY1; 0x2: KEY2; 0x3: KEY3; 0x4: KEY_POWER | 按键编号 | OnChange
0x327 | StandardCAN | 0 | Tx | ICM | CGW/Tester | ICM_UserInput_Event | SIGNAL | 8 | Event | 0 | 0 | KeyAction | Normal Signal |  | 1 | 0 | 4 | Intel LSB | Unsigned | 1 | 0 | 0 | 15 | 0x0 | 0xF |  | 0x0: None; 0x1: ShortPress; 0x2: LongPress; 0x3: DoubleClick | 按键动作 | OnChange
0x327 | StandardCAN | 0 | Tx | ICM | CGW/Tester | ICM_UserInput_Event | SIGNAL | 8 | Event | 0 | 0 | EventCounter | Normal Signal |  | 2 | 0 | 8 | Intel LSB | Unsigned | 1 | 0 | 0 | 255 | 0x00 | 0xFF | count |  | 事件计数器，防止接收端漏事件 | OnChange
0x327 | StandardCAN | 0 | Tx | ICM | CGW/Tester | ICM_UserInput_Event | SIGNAL | 8 | Event | 0 | 0 | PowerKeyLongPress | Normal Signal |  | 3 | 0 | 1 | Intel LSB | Unsigned | 1 | 0 | 0 | 1 | 0x0 | 0x0 |  | 0x0: No; 0x1: Yes | 电源键长按标志 | OnChange
0x327 | StandardCAN | 0 | Tx | ICM | CGW/Tester | ICM_UserInput_Event | SIGNAL | 8 | Event | 0 | 0 | ShutdownConfirm | Normal Signal |  | 3 | 1 | 1 | Intel LSB | Unsigned | 1 | 0 | 0 | 1 | 0x0 | 0x0 |  | 0x0: No; 0x1: Yes | 用户确认关机 | OnChange
0x327 | StandardCAN | 0 | Tx | ICM | CGW/Tester | ICM_UserInput_Event | SIGNAL | 8 | Event | 0 | 0 | KeyEventReserved | Normal Signal |  | 4 | 0 | 32 | Intel LSB | Unsigned | 1 | 0 | 0 | 0 | 0x00000000 | 0xFFFFFFFF |  |  | 预留 | OnChange
0x328 | StandardCAN | 0 | Tx | ICM | CGW/Tester | ICM_LogStatus_1000ms | SIGNAL | 8 | Cyclic/Event | 1000 | 0 | SdCardStatus | Normal Signal |  | 0 | 0 | 2 | Intel LSB | Unsigned | 1 | 0 | 0 | 3 | 0x0 | 0x3 |  | 0x0: NotMounted; 0x1: Mounted; 0x2: Error; 0x3: Reserved | TF 卡挂载状态 | OnWrite
0x328 | StandardCAN | 0 | Tx | ICM | CGW/Tester | ICM_LogStatus_1000ms | SIGNAL | 8 | Cyclic/Event | 1000 | 0 | LogEnable | Normal Signal |  | 0 | 2 | 1 | Intel LSB | Unsigned | 1 | 0 | 0 | 1 | 0x0 | 0x0 |  | 0x0: Disable; 0x1: Enable | 日志记录使能 | OnWrite
0x328 | StandardCAN | 0 | Tx | ICM | CGW/Tester | ICM_LogStatus_1000ms | SIGNAL | 8 | Cyclic/Event | 1000 | 0 | CurrentLogFileIndex | Normal Signal |  | 1 | 0 | 16 | Intel LSB | Unsigned | 1 | 0 | 0 | 65535 | 0x0000 | 0xFFFF |  |  | 当前日志文件编号 | OnWrite
0x328 | StandardCAN | 0 | Tx | ICM | CGW/Tester | ICM_LogStatus_1000ms | SIGNAL | 8 | Cyclic/Event | 1000 | 0 | LogWriteErrorCounter | Normal Signal |  | 3 | 0 | 8 | Intel LSB | Unsigned | 1 | 0 | 0 | 255 | 0x00 | 0xFF | count |  | 日志写入错误计数 | OnWrite
0x328 | StandardCAN | 0 | Tx | ICM | CGW/Tester | ICM_LogStatus_1000ms | SIGNAL | 8 | Cyclic/Event | 1000 | 0 | RuntimeSeconds | Normal Signal |  | 4 | 0 | 32 | Intel LSB | Unsigned | 1 | 0 | 0 | 4294967295 | 0x00000000 | 0xFFFFFFFF | s |  | 系统运行秒数 | OnWrite

Sheet: Convert
CAN 信号物理值换算示例
Signal Name | Raw(hex/dec) | Raw(dec) | Resolution | Offset | Physical Formula | Physical Value | Unit | Remark
VehicleSpeed | 0x0640 | 1600 | 0.0625 | 0 | 100 | 100.000 | km/h | 1600 × 0.0625 = 100 km/h
EngineSpeed | 0x2EE0 | 12000 | 0.25 | 0 | 3000 | 3000.000 | rpm | 12000 × 0.25 = 3000 rpm
FuelPercent | 0xC8 | 200 | 0.4 | 0 | 80 | 80.000 | % | 200 × 0.4 = 80%
EngineCoolantTemperature | 0x5A | 90 | 1 | -40 | 50 | 50.000 | ℃ | 90 - 40 = 50℃
LF_TirePressure | 0x64 | 100 | 0.0275 | 0 | 2.75 | 2.750 | Bar | 100 × 0.0275 = 2.75 bar
TripDistance | 0x04D2 | 1234 | 0.1 | 0 | 123.4 | 123.400 | km | 123.4 km

Sheet: CheckResult
检查项 | 结果 | 说明 | 责任模块 | 优先级
所有报文 Msg ID 是否唯一 | PASS | 当前 13 个报文 ID 未重复 | Com/CanIf | P0
所有报文 DLC 是否为 8 | PASS | 当前按 Classic CAN 8 字节设计 | CanIf | P0
信号是否越过 8 字节边界 | 待代码生成时复核 | 64bit 诊断数据占满 8 字节；其他信号按字节分配 | Com | P0
RX 报文是否可由 USB-CAN 模拟 | PASS | 0x321~0x324、0x441、0x700、0x7DF 可外部发送 | 测试 | P0
TX 报文是否有软件触发源 | PASS | 0x325~0x328、0x440、0x708 由 ICM APP/BSW/Diag 生成 | APP/RTE/BSW | P1
诊断是否完整符合 UDS | NO | 本版只做教学级 UDS 子集，不声明 AUTOSAR/UDS 正式合规 | Dcm/CanTp | P2
是否需要 DBC 导出 | TODO | 后续可根据 Matrix 生成 .dbc，用于 CANoe/CANalyzer/USB-CAN 上位机 | 工具链 | P2
