WHH3844/CAR_DASHBOARD/Docs/汽车仪表盘_诊断需求矩阵.xlsx

Sheet: 00.Overview
汽车仪表盘诊断需求矩阵 - 总览 |  |  |  | KPI / 统计
本文件用于你们的 Mini AUTOSAR / UDS 仪表盘项目。它不是量产级车厂诊断规范，而是足够完整、能指导代码开发的学习项目版本。 |  |  |  | 项 | 公式/值 | 说明 | 状态
 |  |  |  | UDS 服务行数 | 22 | 02.AppServices 数据行 | Draft
 |  |  |  | System DID 数量 | 27 | 03.SystemDID 数据行 | Draft
模块 | 内容 | 当前状态 | 第一版目标 | ECU DID 数量 | 12 | 04.ECU_DID 数据行 | Draft
项目定义 | 基于 AUTOSAR Classic 思想的轻量化仪表盘 ECU 诊断需求矩阵 | 已定义 v0.1 | 指导 Dcm / Dem / NvM / CanTp / RTE 开发 | Coding DID 数量 | 10 | 05.CodingDID 数据行 | Draft
诊断寻址 | Functional 0x7DF, Physical Req 0x700, Resp 0x708 | 已定义 | USB-CAN 可直接测试 | DTC 数量 | 20 | 08.DTCList 数据行 | Draft
核心 UDS 服务 | 0x10, 0x22, 0x19, 0x14, 0x3E | 第一阶段必须实现 | 完成基础诊断闭环 | 测试用例数量 | 15 | 14.TestCases 数据行 | Draft
扩展 UDS 服务 | 0x11, 0x27, 0x2E, 0x2F, 0x31, 0x28 | 占位/后续实现 | 形成完整学习架构
刷写服务 | 0x34, 0x36, 0x37 | 暂不支持 | 后续 Bootloader 版本再做
DID | 运行状态、版本、计数器、传感器、配置参数 | 已定义 | 0x22 可读，部分 0x2E 可写
DTC | 电源、SDRAM、LCD、CAN、EEPROM、RTC、SHT30、TF、软开关等故障 | 已定义 | Dem 记录，Dcm 读取
Snapshot | 故障发生时的车速、转速、电压、时间、状态等 | 已定义 | 用于 0x19 读取故障上下文
ExtendedData | 发生次数、首次/最近时间、老化计数等 | 已定义 | 用于 Dem 扩展数据记录
测试用例 | 诊断服务、DID、DTC、清故障、会话保持等 | 已定义 | 用于后续 USB-CAN 测试

Sheet: RevisionRecords
Revision Records / 版本记录
记录诊断需求矩阵变更历史。板子回来后应根据实际硬件测试结果更新。
Version | Date | Author | Change Description | Review Status | Remark
v0.1 | 2026-05-30 | ChatGPT / 项目组 | 首次建立诊断需求矩阵，覆盖 UDS 服务、DID、DTC、Snapshot、ExtendedData、NvM、CAN 诊断映射和测试用例。 | Draft | 板子未回，先作为软件架构和接口设计基线。

Sheet: Legend
Legend / 术语说明
本页解释诊断需求矩阵中的缩写和字段含义。
Term | English / Full Name | 中文说明 | Used In | Remark
UDS | Unified Diagnostic Services | 统一诊断服务，常见标准为 ISO 14229 | Dcm | 本项目实现教学级子集
DID | Data Identifier | 数据标识符，通过 0x22 读取，通过 0x2E 可选写入 | Dcm / RTE / NvM | 如 0xF181 当前车速
DTC | Diagnostic Trouble Code | 诊断故障码 | Dem / Dcm | 如 SDRAM 初始化失败
NRC | Negative Response Code | 负响应码 | Dcm | 如 0x13 报文长度错误
Dcm | Diagnostic Communication Manager | 诊断通信管理模块 | BSW | 解析 UDS 服务
Dem | Diagnostic Event Manager | 故障事件管理模块 | BSW | 记录故障、状态、快照、扩展数据
NvM | NVRAM Manager | 非易失性数据管理 | BSW | 保存配置、故障、计数器
CanTp | CAN Transport Protocol | CAN 传输层，处理 ISO-TP 多帧 | BSW | 后续支持多帧 DID / DTC
P2/P2* | Diagnostic timing | 诊断响应时间参数 | Dcm | 本项目先用简化超时
Y/N | Yes / No | 是否支持 | All sheets | Y 表示当前计划支持，N 表示不支持或后续扩展
M/U/O | Mandatory / User / Optional | 必选 / 用户选择 / 可选 | Service Table | 用于标注服务实现优先级

Sheet: 01.General
01.General / 诊断总体配置
定义本 ECU 诊断通信的基本参数。后续 Dcm / CanTp / USB-CAN 测试脚本都按本页配置。
Item | Value | Description / 说明 | Owner / Related Module | Remark
ECU Name | ICM_GD32_Dashboard | 仪表盘学习板 ECU 名称 | EcuM / Dcm | 可在 DID 0xF191 读取
Project Type | Mini AUTOSAR-like | 参考 AUTOSAR Classic 分层思想的轻量化项目 | All | 非完整量产 AUTOSAR
MCU | GD32F470ZGT6 / GD32F450ZGT6 | 主控芯片 | MCAL | 以实际焊接为准
CAN Transceiver | SIT1043QT | CAN FD 收发器 | CanTrcv | 先按 Classical CAN 调试
CAN ID Type | Standard 11-bit | 诊断和业务报文均先使用标准帧 | CanIf / CanTp | 后续可扩展扩展帧
Diagnostic Functional Request ID | 0x7DF | 功能寻址请求 ID | CanTp / Dcm | 用于广播诊断请求
Diagnostic Physical Request ID | 0x700 | 物理寻址请求 ID | CanTp / Dcm | Tester -> ICM
Diagnostic Response ID | 0x708 | 物理响应 ID | CanTp / Dcm | ICM -> Tester
Normal Addressing | Yes | ISO-TP 普通寻址 | CanTp | DLC=8
Supported Sessions | 0x01 / 0x02 / 0x03 | 默认会话 / 编程会话 / 扩展会话 | Dcm | 编程会话先占位
Security Level | Level0 / Level1 / LevelFBL | Level0 无锁，Level1 后续写配置用，LevelFBL 刷写用 | Dcm | v0.1 只实现 Level0
P2 Server Max | 50 ms | 普通诊断响应时间目标 | Dcm | 学习项目建议值
P2* Server Max | 5000 ms | 长任务响应时间目标 | Dcm | RoutineControl 可用 ResponsePending
DTC Status Availability Mask | 0xFF | DTC 状态掩码 | Dem / Dcm | 可简化实现
Snapshot Record Number | 0x01 | 默认快照记录号 | Dem | 每个 DTC 先保存一组快照
Extended Data Record Number | 0x01 | 默认扩展数据记录号 | Dem | 每个 DTC 先保存一组扩展数据
Bootloader Support | N for v0.1 | 第一版不支持刷写 | Boot | 后续再扩展 0x34/0x36/0x37
Tool | USB-CAN + PC Script | 测试工具 | Test | 建议后续写 Python/CANoe/CANalyst 测试脚本

Sheet: 02.AppServices
02.ApplicationServices / UDS 应用诊断服务支持表
本页定义应用层诊断服务支持范围。v0.1 的核心是 0x10、0x22、0x19、0x14、0x3E，其他服务先占位。
Service ID | Service Name | 中文名称 | Subfunction | Subfunction Name | CVT | NRC Supported | SPRMIB | Physical | Functional | Session 0x01 Default | Session 0x02 Programming | Session 0x03 Extended | Security Level0 | Security Level1 | v0.1 Support | Priority | Implementation Stage | Comments
0x10 | DiagnosticSessionControl | 诊断会话控制 | 0x01 | defaultSession 默认会话 | M | 0x12/0x13/0x22 | Y | Y | Y | Y | Y | Y | Y | Y | Y | P0 | Phase 1 | 进入默认会话
0x10 | DiagnosticSessionControl | 诊断会话控制 | 0x02 | programmingSession 编程会话 | U | 0x12/0x13/0x22 | Y | Y | N | N | Y | N | N | Y | N | P2 | TBD | 暂不做刷写，仅保留表项
0x10 | DiagnosticSessionControl | 诊断会话控制 | 0x03 | extendedSession 扩展会话 | M | 0x12/0x13/0x22 | Y | Y | Y | N | Y | Y | Y | Y | Y | P0 | Phase 1 | 读 DTC、清 DTC 可使用
0x11 | ECUReset | ECU 复位 | 0x01 | hardReset 硬复位 | U | 0x12/0x13/0x22 | Y | Y | N | Y | N | Y | Y | Y | N | P1 | Phase 2 | 后续调用 NVIC_SystemReset
0x11 | ECUReset | ECU 复位 | 0x03 | softReset 软复位 | U | 0x12/0x13/0x22 | Y | Y | N | Y | N | Y | Y | Y | N | P2 | TBD | 可选
0x22 | ReadDataByIdentifier | 读取 DID | / | / | M | 0x13/0x14/0x22/0x31/0x33 | N | Y | N | Y | Y | Y | Y | Y | Y | P0 | Phase 1 | 核心服务，读取 SystemDID / ECU_DID
0x2E | WriteDataByIdentifier | 写入 DID | / | / | U | 0x13/0x22/0x31/0x33/0x72 | N | Y | N | N | Y | N | N | Y | N | P2 | Phase 3 | 用于配置类 Coding DID，需安全访问
0x19 | ReadDTCInformation | 读取故障码 | 0x01 | reportNumberOfDTCByStatusMask | M | 0x12/0x13/0x31 | N | Y | N | Y | N | Y | Y | Y | Y | P0 | Phase 1 | 读取 DTC 数量
0x19 | ReadDTCInformation | 读取故障码 | 0x02 | reportDTCByStatusMask | M | 0x12/0x13/0x31 | N | Y | N | Y | N | Y | Y | Y | Y | P0 | Phase 1 | 读取 DTC 列表
0x19 | ReadDTCInformation | 读取故障码 | 0x04 | reportDTCSnapshotRecordByDTCNumber | U | 0x12/0x13/0x31 | N | Y | N | N | N | Y | Y | Y | Y | P1 | Phase 2 | 读取快照数据
0x19 | ReadDTCInformation | 读取故障码 | 0x06 | reportDTCExtDataRecordByDTCNumber | U | 0x12/0x13/0x31 | N | Y | N | N | N | Y | Y | Y | Y | P1 | Phase 2 | 读取扩展数据
0x14 | ClearDiagnosticInformation | 清除诊断信息 | / | / | M | 0x13/0x22/0x31/0x72 | N | Y | N | N | N | Y | Y | Y | Y | P1 | Phase 1 | 清除 DTC 和相关快照/扩展数据
0x3E | TesterPresent | 诊断仪在线保持 | 0x00 | zeroSubFunction | M | 0x12/0x13 | Y | Y | Y | Y | Y | Y | Y | Y | Y | P0 | Phase 1 | 保持扩展会话不超时
0x27 | SecurityAccess | 安全访问 | 0x01 | requestSeed 请求种子 | U | 0x12/0x13/0x24/0x35/0x36/0x37 | N | Y | N | N | N | Y | Y | N | N | P2 | TBD | 第一版不实现算法，仅占位
0x27 | SecurityAccess | 安全访问 | 0x02 | sendKey 发送密钥 | U | 0x12/0x13/0x24/0x35/0x36/0x37 | N | Y | N | N | N | Y | Y | N | N | P2 | TBD | 后续配合 0x2E / Boot 使用
0x28 | CommunicationControl | 通信控制 | 0x00 | enableRxAndTx 使能收发 | O | 0x12/0x13/0x22 | Y | Y | N | N | N | Y | Y | Y | N | P3 | Optional | 可选
0x85 | ControlDTCSetting | 控制 DTC 设置 | 0x01 | on 打开 DTC | O | 0x12/0x13/0x22 | Y | Y | N | N | N | Y | Y | Y | N | P3 | Optional | 可选
0x85 | ControlDTCSetting | 控制 DTC 设置 | 0x02 | off 关闭 DTC | O | 0x12/0x13/0x22 | Y | Y | N | N | N | Y | Y | Y | N | P3 | Optional | 可选
0x2F | InputOutputControlByIdentifier | 输入输出控制 | / | / | U | 0x13/0x22/0x31/0x33 | N | Y | N | N | N | Y | Y | Y | N | P2 | Phase 3 | 控制背光、蜂鸣器、测试图等
0x31 | RoutineControl | 例程控制 | 0x01 | startRoutine 启动例程 | U | 0x12/0x13/0x22/0x24/0x31 | N | Y | N | N | N | Y | Y | Y | N | P1 | Phase 2 | SDRAM/LCD/EEPROM 自检
0x31 | RoutineControl | 例程控制 | 0x02 | stopRoutine 停止例程 | O | 0x12/0x13/0x22/0x24/0x31 | N | Y | N | N | N | N | Y | Y | N | P3 | Optional | 可选
0x31 | RoutineControl | 例程控制 | 0x03 | requestRoutineResults 查询例程结果 | U | 0x12/0x13/0x22/0x24/0x31 | N | Y | N | N | N | Y | Y | Y | N | P1 | Phase 2 | 读取例程结果

Sheet: 02.BootServices
02.BootServices / Bootloader 诊断服务规划
本项目 v0.1 不实现 Bootloader。这里提前保留刷写服务定义，避免后期加功能时重新推翻诊断规范。
Service ID | Service Name | 中文名称 | Subfunction | Current Support | Planned Version | Session Required | Security Required | NRC Supported | Description / 说明 | Implementation Remark
0x10 | DiagnosticSessionControl | 切换编程会话 | 0x02 | N | Boot v0.2 | Programming | LevelFBL | 0x12/0x13/0x22 | 进入刷写流程前切换到编程会话。 | 当前板子未回，先不做。
0x27 | SecurityAccess | 刷写安全访问 | 0x11/0x12 | N | Boot v0.2 | Programming | LevelFBL | 0x12/0x13/0x24/0x35/0x36/0x37 | 刷写前通过 Seed/Key 解锁。 | 第一版只保留接口。
0x31 | RoutineControl | 擦除 Flash | Routine 0xFF00 | N | Boot v0.2 | Programming | LevelFBL | 0x12/0x13/0x22/0x24/0x31 | 擦除应用程序区。 | 后续需要 Flash 分区规划。
0x34 | RequestDownload | 请求下载 | / | N | Boot v0.2 | Programming | LevelFBL | 0x13/0x22/0x31/0x70 | 请求建立下载会话。 | 暂不支持。
0x36 | TransferData | 传输数据 | / | N | Boot v0.2 | Programming | LevelFBL | 0x13/0x24/0x31/0x71/0x72/0x73 | 传输程序数据块。 | 暂不支持。
0x37 | RequestTransferExit | 请求传输退出 | / | N | Boot v0.2 | Programming | LevelFBL | 0x13/0x24/0x31/0x72 | 结束下载并校验。 | 暂不支持。
0x11 | ECUReset | 刷写后复位 | 0x01 | N | Boot v0.2 | Programming | LevelFBL | 0x12/0x13/0x22 | 刷写完成后复位。 | 可在应用层 Phase 2 先做复位。

Sheet: 03.SystemDID
03.System DID / 运行数据 DID 表
本页定义 0x22 可读取的运行状态类 DID，直接指导 Dcm_ReadDataByIdentifier 与 RTE 接口设计。
No. | DID | DID Name English | DID 名称中文 | Method / 计算方式 | Data Type | Length(Byte) | Unit | Resolution | Default | Storage | Source Module | Service 0x22 Read | Service 0x2E Write | Session | Security | v0.1 Support | Remark
1 | 0xF180 | BootCounter | 启动次数 | NvM counter + 1 on boot | uint32 | 4 | count | 1 | 0 | EEPROM/NvM | EcuM/NvM | Y | N | 0x01/0x03 | Level0 | Y | 每次上电后自增
2 | 0xF181 | VehicleSpeed | 当前车速 | raw * 0.0625 | uint16 | 2 | km/h | 0.0625 | 0 | RAM | Com/RTE | Y | N | 0x01/0x03 | Level0 | Y | 来自 CAN 0x321
3 | 0xF182 | EngineSpeed | 当前转速 | raw * 4 | uint16 | 2 | rpm | 4 | 0 | RAM | Com/RTE | Y | N | 0x01/0x03 | Level0 | Y | 来自 CAN 0x321
4 | 0xF183 | SupplyVoltage | 供电电压 | raw * 0.001 | uint16 | 2 | V | 0.001 | 12 | RAM | PowerIf/ADC | Y | N | 0x01/0x03 | Level0 | Y | 若无 ADC，第一版可用估算/占位
5 | 0xF184 | RtcTime | RTC 时间 | BCD/Unix time | struct | 7 | time | / | 2026-01-01 | RTC | RtcIf | Y | N | 0x01/0x03 | Level0 | Y | DS3231 读取
6 | 0xF185 | SdramTestResult | SDRAM 测试结果 | 0 pass / !=0 fail code | uint8 | 1 | / | 1 | 0 | RAM/NvM | SdramMgr | Y | N | 0x01/0x03 | Level0 | Y | 上电自检结果
7 | 0xF186 | LcdStatus | LCD 状态 | bitfield | uint8 | 1 | / | 1 | 0 | RAM | LcdIf | Y | N | 0x01/0x03 | Level0 | Y | bit0 initOK, bit1 backlightOK
8 | 0xF187 | HardwareVersion | 硬件版本 | ASCII | ascii | 8 | / | / | HW_V1.0 | Flash/EEPROM | Dcm | Y | N | 0x01/0x03 | Level0 | Y | 可由宏定义或 EEPROM 保存
9 | 0xF188 | SoftwareVersion | 软件版本 | ASCII | ascii | 8 | / | / | SW_V0.1 | Flash | Dcm | Y | N | 0x01/0x03 | Level0 | Y | 编译时定义
10 | 0xF189 | CanRxCounter | CAN 接收计数 | counter | uint32 | 4 | count | 1 | 0 | RAM | CanIf | Y | N | 0x01/0x03 | Level0 | Y | 用于调试 CAN 是否正常
11 | 0xF18A | CanTxCounter | CAN 发送计数 | counter | uint32 | 4 | count | 1 | 0 | RAM | CanIf | Y | N | 0x01/0x03 | Level0 | Y | 用于调试
12 | 0xF18B | LastResetReason | 最近复位原因 | MCU reset flag | uint8 | 1 | / | 1 | 0 | NvM | Mcu/EcuM | Y | N | 0x01/0x03 | Level0 | Y | 上电读取并保存
13 | 0xF18C | BoardTemperature | 板载温度 | raw * 0.01 | int16 | 2 | ℃ | 0.01 | 25 | RAM | SHT30 | Y | N | 0x01/0x03 | Level0 | Y | SHT30 温度
14 | 0xF18D | BoardHumidity | 板载湿度 | raw * 0.01 | uint16 | 2 | %RH | 0.01 | 50 | RAM | SHT30 | Y | N | 0x01/0x03 | Level0 | Y | SHT30 湿度
15 | 0xF18E | BacklightLevel | 背光亮度 | 0-100 | uint8 | 1 | % | 1 | 80 | NvM/RAM | BacklightIf | Y | Y | 0x03 | Level1 | Y | 可写配置项
16 | 0xF18F | PowerState | 电源状态 | EcuM_StateType | uint8 | 1 | / | 1 | 0 | RAM | EcuM | Y | N | 0x01/0x03 | Level0 | Y | Boot/Run/Sleep/Fault
17 | 0xF190 | VIN | 车辆识别码 | 17 ASCII | ascii | 17 | / | / | DEMOICM000000001 | EEPROM/NvM | NvM | Y | Y | 0x03 | Level1 | N | 学习项目可占位
18 | 0xF191 | SystemName | 系统名称 | ASCII | ascii | 20 | / | / | GD32_DASHBOARD | Flash | Dcm | Y | N | 0x01/0x03 | Level0 | Y | 系统名称
19 | 0xF192 | BuildDate | 编译日期 | __DATE__/__TIME__ | ascii | 20 | / | / | / | Flash | Dcm | Y | N | 0x01/0x03 | Level0 | Y | 便于版本追踪
20 | 0xF193 | CanBusState | CAN 总线状态 | enum | uint8 | 1 | / | 1 | 0 | RAM | CanSM | Y | N | 0x01/0x03 | Level0 | Y | 0 init,1 full,2 busoff
21 | 0xF194 | DTCCount | 当前故障数量 | Dem_GetDTCCount() | uint16 | 2 | count | 1 | 0 | RAM/NvM | Dem | Y | N | 0x01/0x03 | Level0 | Y | 0x19 之外也可读
22 | 0xF195 | TotalMileage | 总里程 | raw * 0.1 | uint32 | 4 | km | 0.1 | 0 | EEPROM/NvM | App_Dashboard | Y | Y | 0x03 | Level1 | N | 后续可选
23 | 0xF196 | TripMileage | 小计里程 | raw * 0.1 | uint32 | 4 | km | 0.1 | 0 | EEPROM/NvM | App_Dashboard | Y | Y | 0x03 | Level1 | N | 后续可选
24 | 0xF197 | FuelPercent | 油量百分比 | raw * 1 | uint8 | 1 | % | 1 | 0 | RAM | Com/RTE | Y | N | 0x01/0x03 | Level0 | Y | 来自 CAN 0x321
25 | 0xF198 | EngineCoolantTemp | 发动机水温 | raw - 40 | int16 | 2 | ℃ | 1 | 0 | RAM | Com/RTE | Y | N | 0x01/0x03 | Level0 | Y | 来自 CAN 0x321
26 | 0xF199 | OutdoorTemp | 车外温度 | raw - 40 | int16 | 2 | ℃ | 1 | 0 | RAM | Com/RTE | Y | N | 0x01/0x03 | Level0 | Y | 来自 CAN 0x322
27 | 0xF19A | TPMSStatus | 胎压状态 | bitfield | uint8[8] | 8 | / | / | 0 | RAM | Com/RTE | Y | N | 0x01/0x03 | Level0 | Y | 来自 CAN 0x323

Sheet: 04.ECU_DID
04.ECU DID / ECU 标识 DID 表
本页用于 ECU 标识、售后和版本追踪 DID。部分 DID 与 SystemDID 有重叠，实际代码中可合并实现。
No. | DID | DID Description English | DID 描述中文 | Data Type | Length(Byte) | Default Value | Storage | Read 0x22 | Write 0x2E | Application Software Session | Boot Software Session | Security | Product | After-sales | Remark
1 | 0xF180 | BootSoftwareIdentificationDataIdentifier | Bootloader 软件版本号 | ASCII | 16 | BOOT_NONE | Flash | Y | N | Y | Y | Level0 | Y | Y | 当前无 Bootloader，返回占位
2 | 0xF181 | ApplicationSoftwareIdentificationDataIdentifier | 应用软件版本号 | ASCII | 16 | APP_V0.1.0 | Flash | Y | N | Y | N | Level0 | Y | Y | 可与 0xF188 保持一致或后续合并
3 | 0xF187 | VehicleManufacturerSparePartNumberDataIdentifier | 零件号 | ASCII | 16 | ICM-GD32-V1 | EEPROM | Y | Y | Y | N | Level1 | Y | Y | 学习项目自定义
4 | 0xF189 | VehicleManufacturerECUSoftwareNumberDataIdentifier | ECU 软件号 | ASCII | 16 | SW-ICM-001 | Flash | Y | N | Y | N | Level0 | Y | Y | 可由编译宏生成
5 | 0xF18A | SystemSupplierIdentifierDataIdentifier | 系统供应商 ID | ASCII | 16 | LAB_DEMO | EEPROM | Y | Y | Y | N | Level1 | Y | Y | 项目组/实验室代号
6 | 0xF18B | ECUManufacturingDate | ECU 生产日期 | BCD | 3 | 260101 | EEPROM | Y | Y | Y | N | Level1 | Y | Y | YYMMDD
7 | 0xF18C | ECUSerialNumber | ECU 序列号 | ASCII | 16 | ICM000000001 | EEPROM | Y | Y | Y | N | Level1 | Y | Y | 可唯一标识板子
8 | 0xF190 | VINDataIdentifier | 车辆识别码 | ASCII | 17 | DEMOICM000000001 | EEPROM | Y | Y | Y | N | Level1 | Y | Y | 学习项目可填默认 VIN
9 | 0xF191 | ECUHardwareNumber | ECU 硬件号 | ASCII | 16 | HW-ICM-001 | EEPROM | Y | Y | Y | N | Level1 | Y | Y | 与 PCB 版本绑定
10 | 0xF192 | SystemSupplierECUHardwareVersionNumber | 供应商 ECU 硬件版本 | ASCII | 16 | HW_V1.0 | Flash | Y | N | Y | N | Level0 | Y | Y | 固定常量
11 | 0xF193 | SystemSupplierECUSoftwareVersionNumber | 供应商 ECU 软件版本 | ASCII | 16 | SW_V0.1 | Flash | Y | N | Y | N | Level0 | Y | Y | 固定常量
12 | 0xF1A0 | ProgrammingDate | 最近刷写日期 | BCD | 3 | 000000 | EEPROM | Y | N | Y | Y | Level0 | Y | Y | 无 Bootloader 时返回 000000

Sheet: 05.CodingDID
05.Coding DID / 可配置 DID 表
本页定义可通过 0x2E 写入的配置类 DID。v0.1 可先只读，后续实现安全访问后允许写入。
No. | DID | Coding Name | 中文名称 | Data Type | Length(Byte) | Default | Range / Enum | Storage | Read 0x22 | Write 0x2E | Session | Security | Affected Module | Validation Rule | Remark
1 | 0xF1A1 | LanguageSetting | 语言设置 | uint8 | 1 | 0 | 0:CN,1:EN | NvM | Y | Y | 0x03 | Level1 | App_Display | value <= 1 | 用于界面语言切换
2 | 0xF1A2 | ThemeMode | 主题模式 | uint8 | 1 | 0 | 0:Dark,1:Light,2:Auto | NvM | Y | Y | 0x03 | Level1 | App_Display | value <= 2 | 仪表主题
3 | 0xF1A3 | BacklightDefault | 默认背光亮度 | uint8 | 1 | 80 | 0-100 | NvM | Y | Y | 0x03 | Level1 | BacklightIf | 0 <= value <= 100 | 掉电保存
4 | 0xF1A4 | BuzzerEnable | 蜂鸣器使能 | uint8 | 1 | 1 | 0:Off,1:On | NvM | Y | Y | 0x03 | Level1 | BuzzerIf | value <= 1 | 用于报警声音开关
5 | 0xF1A5 | CANBaudrate | CAN 波特率配置 | uint8 | 1 | 0 | 0:500k,1:250k,2:1M | NvM | Y | Y | 0x03 | Level1 | CanIf/CanSM | value <= 2 | 修改后需重启或重新初始化 CAN
6 | 0xF1A6 | DisplayUnit | 显示单位 | uint8 | 1 | 0 | 0:Metric,1:Imperial | NvM | Y | Y | 0x03 | Level1 | App_Dashboard | value <= 1 | km/h 与 mph 切换预留
7 | 0xF1A7 | OverspeedThreshold | 超速报警阈值 | uint16 | 2 | 120 | 0-300 km/h | NvM | Y | Y | 0x03 | Level1 | App_Dashboard | value <= 300 | 用于蜂鸣器报警
8 | 0xF1A8 | MaintenanceMileage | 保养提醒里程 | uint32 | 4 | 5000 | 0-999999 km | NvM | Y | Y | 0x03 | Level1 | App_Dashboard | value <= 999999 | 后续可选
9 | 0xF1A9 | DemoModeEnable | 演示模式使能 | uint8 | 1 | 1 | 0:Off,1:On | NvM | Y | Y | 0x03 | Level1 | App_Demo | value <= 1 | 无 CAN 时可用假数据演示
10 | 0xF1AA | LogEnable | 日志记录使能 | uint8 | 1 | 0 | 0:Off,1:On | NvM | Y | Y | 0x03 | Level1 | LoggerApp | value <= 1 | TF 卡可用后再开启

Sheet: 06.IOControl
06.IOControl 0x2F / 输入输出控制表
0x2F 第一版不建议实现，先作为硬件产测/后期调试规划。
No. | Control DID | Control Name | 中文名称 | Control Option Record | Input Data | Output Data | Session | Security | v0.1 Support | Controlled Module | Fail Criteria | Expected Result | Remark
1 | 0x2F00 | BacklightControl | 背光控制 | 0x00:returnControlToECU; 0x03:shortTermAdjustment | uint8 level 0-100 | current level | 0x03 | Level1 | N | BacklightIf | level > 100 | 背光亮度变化 | 后期用于产测/调试
2 | 0x2F01 | BuzzerControl | 蜂鸣器控制 | 0x00:returnControlToECU; 0x03:shortTermAdjustment | uint16 freq, uint16 duration | status | 0x03 | Level1 | N | BuzzerIf | duration too long | 蜂鸣器按指定频率/时间响 | 有源蜂鸣器可忽略频率
3 | 0x2F02 | StatusLedControl | 状态 LED 控制 | 0x00/0x03 | uint8 ledId, uint8 state | status | 0x03 | Level1 | N | Dio/IoHwAb | ledId invalid | LED 状态变化 | 用于硬件验证
4 | 0x2F03 | CanTrcvModeControl | CAN 收发器模式控制 | 0x00/0x03 | uint8 mode | status | 0x03 | Level1 | N | CanTrcv | mode invalid | Normal/Standby 切换 | 调试 SIT1043QT EN/STBN
5 | 0x2F04 | LCDTestPatternControl | LCD 测试图控制 | 0x00/0x03 | uint8 patternId | status | 0x03 | Level1 | N | LcdIf/App_Display | pattern invalid | 显示纯色/色条 | 用于 LCD Bring-up
6 | 0x2F05 | PowerHoldControl | PWR_HOLD 控制 | 0x00/0x03 | uint8 hold | status | 0x03 | Level1 | N | PowerIf | dangerous command | 保持/释放软开关 | 谨慎使用，避免误关机

Sheet: 07.RoutineControl
07.RoutineControl 0x31 / 例程控制表
本页定义 0x31 例程控制。建议 Phase 2 开始做 SDRAM/LCD/EEPROM/RTC/SHT30 自检。
No. | Routine ID | Routine Name | 中文名称 | Subfunction | Input Parameter | Output Result | Session | Security | v0.1 Support | Timeout | Affected Module | Start Criteria | Stop Criteria | Fail Criteria | Remark
1 | 0x3101 | SdramFullTest | SDRAM 全容量测试 | 0x01/0x03 | testMode | pass/fail + fail address | 0x03 | Level0 | Y | 5s | SdramMgr | LCD 未高负载刷新 | 测试完成 | 读写校验失败 | Phase 2 建议实现
2 | 0x3102 | LCDColorBarTest | LCD 色条测试 | 0x01/0x03 | patternId | status | 0x03 | Level0 | Y | 1s | LcdIf | LCD 初始化成功 | 切回正常界面 | 无法刷新/超时 | 用于 LCD Bring-up
3 | 0x3103 | EEPROMCRCCheck | EEPROM CRC 检查 | 0x01/0x03 | blockId | crc status | 0x03 | Level0 | Y | 500ms | NvM/Eep | EEPROM 在线 | 检查完成 | CRC mismatch | 用于 NvM 校验
4 | 0x3104 | RTCReadSetTest | RTC 自检 | 0x01/0x03 | none | time + status | 0x03 | Level0 | Y | 500ms | RtcIf | I2C 正常 | 读写完成 | I2C NACK | 测试 DS3231
5 | 0x3105 | SHT30SelfTest | SHT30 自检 | 0x01/0x03 | none | temp/humi/status | 0x03 | Level0 | Y | 500ms | SensorIf | I2C 正常 | 读取完成 | CRC/NACK | 测试 SHT30
6 | 0x3106 | CANLoopbackTest | CAN 回环测试 | 0x01/0x03 | mode | tx/rx counter | 0x03 | Level0 | N | 1s | CanIf | CAN 空闲 | 测试完成 | bus-off / timeout | 后续实现
7 | 0x3107 | TFMountTest | TF 卡挂载测试 | 0x01/0x03 | none | mount result | 0x03 | Level0 | N | 3s | SdIf/FatFs | TF 卡已插入 | 挂载完成 | mount fail | 后续实现
8 | 0x3108 | ClearTripMileage | 清除小计里程 | 0x01 | none | status | 0x03 | Level1 | N | 200ms | App_Dashboard/NvM | 车辆静止 | 清除完成 | NvM write fail | 可选
9 | 0x3109 | NvMWriteAll | 强制保存 NvM | 0x01/0x03 | none | status | 0x03 | Level0 | Y | 1s | NvM | 系统正常 | 保存完成 | write timeout | 关机前也会调用
10 | 0x310A | DTCInjectTest | 故障注入测试 | 0x01/0x03 | DTC ID | status | 0x03 | Level1 | N | 100ms | Dem | Debug build | 注入完成 | ID invalid | 仅调试版本开启

Sheet: 08.DTCList
08.DTC List / 故障码列表
本页定义 Dem 需要管理的 DTC。第一版重点关注电源、SDRAM、LCD、CAN、EEPROM、RTC、SHT30、软开关。
No. | DTC Number | High | Middle | Low | DTC Name English | DTC 描述中文 | Failure Type English | Failure Type 中文 | Level | FaultNum | Lamp Flag | Monitor Enable Criteria / 检测使能条件 | Test Failed Criteria / 故障判定条件 | Test Passed Criteria / 恢复条件 | System Action / 系统动作 | Monitor Rate | Snapshot | Extended Data | Clear Condition | Related Module | Remark
1 | 0x010001 | 01 | 00 | 01 | Low supply voltage | 供电电压过低 | System Failure | 系统故障 | 3 | 0x0001 | Y | IGN ON 或系统上电后 3s；PowerIf 已初始化 | 供电电压 < 9V 持续 1s | 供电电压 > 10V 持续 1s | 限制背光亮度，记录故障，显示电源报警 | 100ms | 0x01 | 0x01 | 0x14 清除或连续通过 3 次 | PowerIf | 阈值可根据实际 12V 电源调整
2 | 0x010002 | 01 | 00 | 02 | High supply voltage | 供电电压过高 | System Failure | 系统故障 | 3 | 0x0002 | Y | 系统上电后 3s；PowerIf 已初始化 | 供电电压 > 16V 持续 1s | 供电电压 < 15V 持续 1s | 记录故障，必要时关闭背光/蜂鸣器 | 100ms | 0x01 | 0x01 | 0x14 清除或连续通过 3 次 | PowerIf | 保护 DCDC 和 LCD 背光
3 | 0x020001 | 02 | 00 | 01 | SDRAM init failed | SDRAM 初始化失败 | Component Failure | 部件故障 | 3 | 0x0003 | Y | EcuM SELF_TEST 阶段 | EXMC SDRAM 初始化失败 | 下一次上电初始化通过 | 禁止启动完整 UI，进入故障界面 | Boot only | 0x02 | 0x01 | 重新上电通过自检或 0x14 清除 | SdramMgr | 核心故障
4 | 0x020002 | 02 | 00 | 02 | SDRAM R/W test failed | SDRAM 读写测试失败 | Component Failure | 部件故障 | 3 | 0x0004 | Y | SDRAM 初始化成功后 | walking 1/0 或块测试失败 | 下一次测试通过 | 禁用 framebuffer 复杂功能，显示简化界面 | Boot/OnRoutine | 0x02 | 0x01 | 例程通过或 0x14 清除 | SdramMgr | 记录失败地址
5 | 0x030001 | 03 | 00 | 01 | LCD init failed | LCD 初始化失败 | Component Failure | 部件故障 | 3 | 0x0005 | Y | LCD 供电正常；背光控制可用 | LCD 初始化超时或 RST/PCLK 异常 | 重新初始化成功 | 关闭背光，蜂鸣器提示，串口输出故障 | Boot only | 0x03 | 0x01 | 重启通过或 0x14 清除 | LcdIf | 显示核心故障
6 | 0x030002 | 03 | 00 | 02 | Framebuffer abnormal | 显存异常 | Component Failure | 部件故障 | 2 | 0x0006 | Y | SDRAM 和 LCD 初始化通过 | framebuffer CRC/刷新检测异常 | 连续 3 次刷新正常 | 降级为静态界面，记录故障 | 1s | 0x03 | 0x01 | 连续通过或 0x14 清除 | LcdIf/SdramMgr | 后续可选检测
7 | 0x040001 | 04 | 00 | 01 | CAN bus off | CAN Bus-Off | Communication Failure | 通信故障 | 3 | 0x0007 | Y | CAN 初始化完成；CanSM FULL_COMM | CAN 控制器进入 Bus-Off | Bus-Off 恢复并连续正常 1s | 尝试恢复 CAN，显示通信故障 | 10ms | 0x04 | 0x02 | 恢复或 0x14 清除 | CanIf/CanSM | 重点故障
8 | 0x040002 | 04 | 00 | 02 | CAN RX timeout | CAN 接收超时 | Communication Failure | 通信故障 | 2 | 0x0008 | Y | CanSM FULL_COMM；期望周期报文存在 | 关键报文 0x321 超时 > 500ms | 连续收到 5 帧 0x321 | 冻结车速/转速或置无效，显示通信报警 | 100ms | 0x04 | 0x02 | 恢复或 0x14 清除 | Com/CanIf | 仪表功能关键
9 | 0x040003 | 04 | 00 | 03 | CAN transceiver error | CAN 收发器错误 | Component Failure | 部件故障 | 2 | 0x0009 | Y | SIT1043QT 供电正常；EN/STBN 已配置 | ERR_N 拉低持续 100ms | ERR_N 高电平持续 1s | 尝试切换收发器状态，记录故障 | 100ms | 0x04 | 0x02 | 恢复或 0x14 清除 | CanTrcv | 需要硬件 ERR_N 引脚可读
10 | 0x050001 | 05 | 00 | 01 | EEPROM communication failed | EEPROM 通信失败 | Communication Failure | 通信故障 | 2 | 0x000A | N | I2C0 初始化完成 | FT24C16A 读写 NACK 连续 3 次 | 连续读写成功 3 次 | 使用默认配置，禁止保存参数 | 1s | 0x05 | 0x03 | 恢复或 0x14 清除 | Eep/NvM | 影响配置保存
11 | 0x050002 | 05 | 00 | 02 | EEPROM CRC failed | EEPROM CRC 错误 | Data Failure | 数据故障 | 2 | 0x000B | N | EEPROM 可通信 | NvM block CRC mismatch | 重写默认值并校验通过 | 恢复默认配置，记录故障 | OnRead | 0x05 | 0x03 | 重新初始化配置或 0x14 清除 | NvM/Crc | NvM 重点故障
12 | 0x060001 | 06 | 00 | 01 | RTC communication failed | RTC 通信失败 | Communication Failure | 通信故障 | 1 | 0x000C | N | I2C0 初始化完成 | DS3231 NACK 连续 3 次 | 连续读取成功 3 次 | 使用系统 tick 临时时间 | 1s | 0x06 | 0x03 | 恢复或 0x14 清除 | RtcIf | 不影响核心显示
13 | 0x060002 | 06 | 00 | 02 | RTC time invalid | RTC 时间无效 | Data Failure | 数据故障 | 1 | 0x000D | N | RTC 可通信 | 时间字段非法或掉电标志异常 | 重新设置时间后读取有效 | 显示时间无效提示 | OnRead | 0x06 | 0x03 | 设置有效时间或 0x14 清除 | RtcIf | 可通过 DID 设置后恢复
14 | 0x070001 | 07 | 00 | 01 | SHT30 communication failed | SHT30 通信失败 | Communication Failure | 通信故障 | 1 | 0x000E | N | I2C0 初始化完成 | SHT30 NACK/CRC 失败连续 3 次 | 连续读取成功 3 次 | 隐藏温湿度显示或显示 -- | 1s | 0x07 | 0x03 | 恢复或 0x14 清除 | SensorIf | 学习板环境信息
15 | 0x080001 | 08 | 00 | 01 | TF card mount failed | TF 卡挂载失败 | Component Failure | 部件故障 | 1 | 0x000F | N | SDIO 初始化完成；检测到 TF 卡 | FATFS mount 失败 | 重新挂载成功 | 关闭日志记录功能 | OnMount | 0x08 | 0x03 | 重新挂载或 0x14 清除 | SdIf/FatFs | 不影响核心仪表
16 | 0x090001 | 09 | 00 | 01 | Power hold failed | 软开关保持异常 | System Failure | 系统故障 | 3 | 0x0010 | Y | 软开关模式 SW1 OFF；PWR_HOLD 已拉高 | 12V_SYS 掉电趋势或 PWR_HOLD 控制异常 | PWR_HOLD 和 12V_SYS 稳定 | 立即保存 NvM，记录故障 | 100ms | 0x09 | 0x01 | 重启稳定或 0x14 清除 | PowerIf/EcuM | 非常重要
17 | 0x0A0001 | 0A | 00 | 01 | Key stuck | 按键卡滞 | Component Failure | 部件故障 | 1 | 0x0011 | N | 按键扫描开启 | 同一按键按下持续 > 30s | 按键释放持续 1s | 忽略该按键输入，记录故障 | 10ms | 0x0A | 0x03 | 释放或 0x14 清除 | KeyApp/IoHwAb | 用于 KEY_POWER/KEY1 等
18 | 0x0B0001 | 0B | 00 | 01 | Buzzer control failed | 蜂鸣器控制异常 | Component Failure | 部件故障 | 1 | 0x0012 | N | 蜂鸣器驱动初始化完成 | 控制命令执行失败或电流检测异常 | 下一次控制成功 | 禁用蜂鸣器报警 | OnCommand | 0x0B | 0x03 | 恢复或 0x14 清除 | BuzzerIf | 若无反馈检测，可只做软件故障
19 | 0x0C0001 | 0C | 00 | 01 | Display task overload | 显示任务超时 | System Failure | 系统故障 | 2 | 0x0013 | N | RTOS/LVGL 阶段启用 | 显示任务周期超时 > 3 次 | 连续 10 次周期正常 | 降低刷新率，记录故障 | 20ms | 0x0C | 0x04 | 恢复或 0x14 清除 | App_Display | 上 RTOS 后再实现
20 | 0x0D0001 | 0D | 00 | 01 | Watchdog reset detected | 看门狗复位记录 | System Failure | 系统故障 | 2 | 0x0014 | Y | 上电读取复位原因 | 复位原因包含 IWDG/WWDG | 下一次正常启动 | 记录故障，读取上次运行状态 | Boot only | 0x0D | 0x04 | 0x14 清除 | Mcu/EcuM | 用于定位死机

Sheet: 09.Snapshot
09.Snapshot Data / DTC 快照数据定义
DTC 发生时保存系统上下文，避免只知道“坏了”但不知道坏在什么状态下。
Snapshot ID | Snapshot Name | 中文名称 | Data Source | Data Type | Length(Byte) | Unit | Resolution | Stored For DTC | Trigger | NvM Storage | Remark
0x01 | PowerSnapshot | 电源快照 | SupplyVoltage, PowerState | struct | 8 | V/state | / | 0x010001/0x010002/0x090001 | DTC confirmed | Y | 电源类故障保存
0x02 | MemorySnapshot | 存储快照 | SDRAM fail address/result | struct | 12 | / | / | 0x020001/0x020002 | DTC confirmed | Y | SDRAM 故障定位
0x03 | DisplaySnapshot | 显示快照 | LcdStatus, backlight, framebuffer | struct | 8 | / | / | 0x030001/0x030002 | DTC confirmed | Y | LCD 故障定位
0x04 | CanSnapshot | CAN 快照 | CanState, rx/tx counter, last msg age | struct | 16 | / | / | 0x040001/0x040002/0x040003 | DTC confirmed | Y | CAN 通信类故障
0x05 | NvMSnapshot | NvM 快照 | blockId, crc, eep status | struct | 12 | / | / | 0x050001/0x050002 | DTC confirmed | Y | EEPROM/NvM 故障
0x06 | RtcSnapshot | RTC 快照 | RtcTime, rtc status | struct | 8 | time | / | 0x060001/0x060002 | DTC confirmed | Y | RTC 故障
0x07 | SensorSnapshot | 传感器快照 | temperature, humidity, sensor status | struct | 8 | ℃/%RH | / | 0x070001 | DTC confirmed | Y | SHT30 故障
0x08 | SdSnapshot | TF 卡快照 | sd status, fatfs result | struct | 8 | / | / | 0x080001 | DTC confirmed | Y | 日志存储故障
0x09 | KeySnapshot | 按键快照 | key id, pressed time | struct | 4 | ms | 1 | 0x0A0001 | DTC confirmed | Y | 按键卡滞
0x0A | VehicleRuntimeSnapshot | 车辆运行快照 | speed, rpm, fuel, temp | struct | 12 | km/h/rpm/%/℃ | / | 0x040002/others | DTC confirmed | Y | 关键故障通用快照
0x0B | ResetSnapshot | 复位快照 | reset reason, boot counter | struct | 8 | / | / | 0x0D0001 | Boot | Y | 死机/复位定位
0x0C | SystemStateSnapshot | 系统状态快照 | EcuM state, task load, free heap | struct | 12 | / | / | 0x0C0001/others | DTC confirmed | Y | RTOS 阶段使用

Sheet: 10.ExtendedData
10.Extended Data / DTC 扩展数据定义
扩展数据用于记录故障次数、首次/最近发生时间、老化计数等。
Record ID | Extended Data Name | 中文名称 | Data Type | Length(Byte) | Stored For | Update Trigger | NvM Storage | Read By 0x19 Subfunction | Remark
0x01 | OccurrenceCounter | 故障发生次数 | uint16 | 2 | All DTC | DTC failed edge | Y | 0x06 | 每次从 passed -> failed 加 1
0x02 | FirstDetectedTime | 首次发生时间 | RtcTime | 7 | All DTC | First fail | Y | 0x06 | 无 RTC 时可用 boot counter
0x03 | LastDetectedTime | 最近发生时间 | RtcTime | 7 | All DTC | Every fail | Y | 0x06 | 便于售后分析
0x04 | AgingCounter | 老化计数 | uint8 | 1 | All DTC | Pass cycle | Y | 0x06 | 连续通过若干次后可老化
0x05 | ConfirmedCounter | 确认计数 | uint8 | 1 | All DTC | Confirmed fail | Y | 0x06 | 到达阈值后置 confirmed
0x06 | LastFailedReason | 最近失败原因 | uint16 | 2 | All DTC | Every fail | Y | 0x06 | 存内部错误码
0x07 | LastRecoverReason | 最近恢复原因 | uint16 | 2 | All DTC | Recovery | Y | 0x06 | 记录恢复方式
0x08 | LastEcuState | 最近 ECU 状态 | uint8 | 1 | All DTC | Every fail | Y | 0x06 | Boot/Run/Sleep/Fault
0x09 | LastResetReason | 最近复位原因 | uint8 | 1 | Reset/Power DTC | Boot | Y | 0x06 | 看门狗/外部复位/软件复位

Sheet: 11.NRC
11.Negative Response Codes / 负响应码表
本页定义 Dcm 需要返回的 NRC。v0.1 至少要实现 0x11、0x12、0x13、0x22、0x31、0x78。
NRC | Name | 中文名称 | When To Return / 触发条件 | Used Services | v0.1 Support | Remark
0x10 | GeneralReject | 一般拒绝 | 无法归类的拒绝条件 | All | Y | 尽量少用
0x11 | ServiceNotSupported | 服务不支持 | 请求了未实现服务 | All | Y | 如 0x34 v0.1 不支持
0x12 | SubFunctionNotSupported | 子功能不支持 | 子功能不在表内 | 0x10/0x11/0x19/0x31 | Y | 常用
0x13 | IncorrectMessageLengthOrInvalidFormat | 长度或格式错误 | 请求长度不符合 | All | Y | 必须实现
0x14 | ResponseTooLong | 响应过长 | 响应超过单帧/多帧限制 | 0x22/0x19 | Y | DID 太多时使用
0x21 | BusyRepeatRequest | 忙，请重试 | 任务忙但可重试 | 0x31 | N | 可选
0x22 | ConditionsNotCorrect | 条件不满足 | 会话/状态/电源条件不满足 | 0x10/0x11/0x14/0x31 | Y | 常用
0x24 | RequestSequenceError | 请求顺序错误 | 未解锁直接发送 key 或传输顺序错误 | 0x27/0x36/0x37 | N | 安全访问/刷写后续使用
0x31 | RequestOutOfRange | 请求超范围 | DID/DTC/Routine ID 不存在 | 0x22/0x2E/0x19/0x31/0x2F | Y | 必须实现
0x33 | SecurityAccessDenied | 安全访问拒绝 | 需要安全访问但未解锁 | 0x2E/0x2F/0x31 | N | 安全访问实现后使用
0x35 | InvalidKey | 密钥错误 | SecurityAccess key 不正确 | 0x27 | N | 后续
0x36 | ExceededNumberOfAttempts | 尝试次数超限 | 安全访问错误次数超限 | 0x27 | N | 后续
0x37 | RequiredTimeDelayNotExpired | 延时未到 | 安全访问锁定延时未到 | 0x27 | N | 后续
0x70 | UploadDownloadNotAccepted | 上传下载不接受 | 刷写条件不满足 | 0x34 | N | Bootloader 后续
0x71 | TransferDataSuspended | 传输暂停 | 刷写传输暂停 | 0x36 | N | Bootloader 后续
0x72 | GeneralProgrammingFailure | 编程失败 | Flash 写入/EEPROM 写入失败 | 0x2E/0x31/0x34/0x36/0x37 | N | 后续
0x73 | WrongBlockSequenceCounter | 块序号错误 | 刷写传输块序号错误 | 0x36 | N | Bootloader 后续
0x78 | ResponsePending | 响应挂起 | 例程耗时，需要等待 | 0x31 | Y | SDRAM 全测试可使用

Sheet: 12.NvMMapping
12.NvM Mapping / 非易失性存储映射
本页定义 NvM block，后续可以直接转成 NvM_Cfg.h。
Block ID | Block Name | 中文名称 | Data Items | Size Estimate | Storage | CRC | Redundant | Default Value Strategy | Write Trigger | Related DID / DTC | v0.1 Support | Remark
0x0001 | NVM_BLOCK_SYSTEM_CONFIG | 系统配置块 | Language, Theme, Backlight, Buzzer, CANBaudrate | 32B | EEPROM | CRC16 | N | Use compile-time defaults | 0x2E write / shutdown | 0xF1A1-0xF1A6 | Y | 第一版建议实现
0x0002 | NVM_BLOCK_DASHBOARD_DATA | 仪表数据块 | TotalMileage, TripMileage, OverspeedThreshold | 32B | EEPROM | CRC16 | N | 0 | periodic / shutdown | 0xF195/0xF196/0xF1A7 | N | 后续可做
0x0003 | NVM_BLOCK_DTC_STATUS | DTC 状态块 | DTC status, occurrence counter | 256B | EEPROM | CRC16 | Y | No DTC | DTC status change / shutdown | 0x19 / 08.DTCList | Y | Dem 使用
0x0004 | NVM_BLOCK_DTC_SNAPSHOT | DTC 快照块 | snapshot records | 512B | EEPROM | CRC16 | N | empty | DTC confirmed | 09.Snapshot | Y | 保存故障上下文
0x0005 | NVM_BLOCK_DTC_EXTENDED | DTC 扩展数据块 | extended data records | 256B | EEPROM | CRC16 | N | empty | DTC failed/recovered | 10.ExtendedData | Y | 保存故障次数和时间
0x0006 | NVM_BLOCK_ECU_ID | ECU 标识块 | VIN, serial, HW/SW IDs | 128B | EEPROM | CRC16 | N | demo values | 0x2E write | 04.ECU_DID | Y | 售后标识
0x0007 | NVM_BLOCK_BOOT_INFO | 启动信息块 | BootCounter, LastResetReason | 16B | EEPROM | CRC16 | N | 0 | boot / shutdown | 0xF180/0xF18B | Y | EcuM 使用
0x0008 | NVM_BLOCK_LOG_CONFIG | 日志配置块 | LogEnable, log level | 16B | EEPROM | CRC16 | N | disabled | 0x2E write | 0xF1AA | N | TF 卡阶段再做

Sheet: 13.CAN_Diag
13.CAN Diagnostic Mapping / CAN 诊断映射
本页把诊断服务和 CAN ID 绑定起来。开发 CanTp / Dcm 时按这里配置。
Item | CAN ID | Frame Type | Direction | DLC | Addressing | Transport | Used By | Description / 说明 | Remark
Functional Request | 0x7DF | Standard CAN | Tester -> All ECU | 8 | Normal | ISO-TP | Dcm | 功能寻址请求 | 所有 ECU 可接收；本项目只响应支持服务
Physical Request | 0x700 | Standard CAN | Tester -> ICM | 8 | Normal | ISO-TP | Dcm | 物理寻址请求 | USB-CAN 测试主入口
Physical Response | 0x708 | Standard CAN | ICM -> Tester | 8 | Normal | ISO-TP | Dcm | 诊断响应 | 正响应/负响应都走该 ID
Periodic CAN 0x321 | 0x321 | Standard CAN | EMS -> ICM | 8 | / | Com | Dashboard | 车速、转速、油量、水温 | 与 CAN 报文矩阵保持一致
Periodic CAN 0x322 | 0x322 | Standard CAN | BCM -> ICM | 8 | / | Com | Dashboard | 车门、灯光、外温、电压 | 与 CAN 报文矩阵保持一致
Periodic CAN 0x323 | 0x323 | Standard CAN | TPMS -> ICM | 8 | / | Com | Dashboard | 胎压数据 | 与 CAN 报文矩阵保持一致
ICM Status | 0x325 | Standard CAN | ICM -> Others | 8 | / | Com | ICM | 仪表状态、亮度、故障状态 | 后续上报
ICM DiagStatus | 0x326 | Standard CAN | ICM -> Tester/Others | 8 | / | Com | ICM/Diag | DTC 数量、诊断会话状态 | 可选

Sheet: 14.TestCases
14.TestCases / 诊断测试用例
本页用于后续 USB-CAN / Python 脚本 / CANoe 测试。不要等代码写烂了再补测试，那叫考古。
Test ID | Test Name | 中文名称 | Precondition | Request Example | Expected Response | Expected NRC | Related Service / DID / DTC | Priority | Status | Remark
TC_DCM_001 | Enter default session | 进入默认会话 | ECU 上电，CAN 正常 | 0x10 0x01 | 0x50 0x01 + timing | / | 0x10 | P0 | Draft | 第一阶段必测
TC_DCM_002 | Enter extended session | 进入扩展会话 | 默认会话 | 0x10 0x03 | 0x50 0x03 + timing | / | 0x10 | P0 | Draft | 清故障/读扩展信息前使用
TC_DCM_003 | Tester present | 在线保持 | 扩展会话 | 0x3E 0x00 | 0x7E 0x00 | / | 0x3E | P0 | Draft | 会话不超时
TC_DCM_004 | Read software version | 读取软件版本 | 任意会话 | 0x22 0xF1 0x88 | 0x62 0xF1 0x88 + data | / | 0xF188 | P0 | Draft | DID 读取验证
TC_DCM_005 | Read vehicle speed | 读取当前车速 | CAN 0x321 正常输入 | 0x22 0xF1 0x81 | 0x62 0xF1 0x81 + speed | / | 0xF181 | P0 | Draft | 验证 Com -> RTE -> Dcm
TC_DCM_006 | Read invalid DID | 读取不存在 DID | 任意会话 | 0x22 0x12 0x34 | 0x7F 0x22 0x31 | 0x31 | 0x22 | P0 | Draft | 负响应测试
TC_DCM_007 | Read DTC count | 读取 DTC 数量 | Dem 初始化 | 0x19 0x01 0xFF | 0x59 0x01 + count | / | 0x19 | P0 | Draft | 无故障也要能返回 0
TC_DCM_008 | Read DTC by status mask | 按状态读取 DTC | 至少注入一个 DTC | 0x19 0x02 0xFF | 0x59 0x02 + DTC list | / | 0x19 / DTCList | P0 | Draft | Dem/Dcm 联调
TC_DCM_009 | Clear DTC | 清除故障码 | 扩展会话，有 DTC | 0x14 0xFF 0xFF 0xFF | 0x54 | / | 0x14 | P0 | Draft | 清除所有 DTC
TC_DCM_010 | Read DTC snapshot | 读取 DTC 快照 | 存在 confirmed DTC | 0x19 0x04 + DTC + record | 0x59 0x04 + snapshot | / | 0x19 / Snapshot | P1 | Draft | Phase 2
TC_DCM_011 | Routine SDRAM test | 执行 SDRAM 测试 | 扩展会话 | 0x31 0x01 0x31 0x01 | 0x71 0x01 0x31 0x01 + result 或 0x78 | / | 0x31/0x3101 | P1 | Draft | 耗时可能返回 ResponsePending
TC_DCM_012 | Routine LCD color bar | 执行 LCD 色条测试 | LCD 初始化成功 | 0x31 0x01 0x31 0x02 | 0x71 0x01 0x31 0x02 + result | / | 0x31/0x3102 | P1 | Draft | 板子回来后很有用
TC_DCM_013 | Write backlight coding denied | 未解锁写背光配置被拒绝 | 扩展会话，未解锁 | 0x2E 0xF1 0xA3 0x50 | 0x7F 0x2E 0x33 | 0x33 | 0x2E/0xF1A3 | P2 | Draft | 安全访问实现后测
TC_DCM_014 | Unsupported service | 不支持服务测试 | 任意会话 | 0x99 | 0x7F 0x99 0x11 | 0x11 | All | P0 | Draft | Dcm 基础鲁棒性
TC_DCM_015 | Incorrect length | 错误长度测试 | 任意会话 | 0x22 0xF1 | 0x7F 0x22 0x13 | 0x13 | 0x22 | P0 | Draft | 格式校验
