WHH3844/CAR_DASHBOARD/Docs/Interface/汽车仪表盘_CAN报文矩阵_v1.0.xlsx

Sheet: ReadMe
汽车仪表盘 CAN 报文矩阵 v1.0
Released 2026-07-29。标准 CAN 信号使用 Intel/Little-Endian；UDS 多字节数值使用 Big-Endian。原始工作簿未被覆盖。
项目定位 | 基于 GD32F470/GD32F450 + SIT1043QT CAN 收发器的汽车仪表盘学习板，采用 Mini AUTOSAR / AUTOSAR-like 软件架构。
设计目标 | 用于 USB-CAN / 仿真节点发送车辆数据，ICM 仪表接收后显示车速、转速、报警灯、胎压、配置、诊断状态等。
帧格式 | 本版默认使用 Standard CAN 11-bit ID，DLC=8。虽然硬件 CAN 收发器支持 CAN FD 物理层，但 MCU 外设与教学实现优先按 Classic CAN 设计。
字节序 | 默认 Intel LSB，小端格式，方便 GD32/STM32 C 代码打包解析。若后续接真实整车 DBC，需要按对方 DBC 调整。
物理值换算 | Physical = Raw × Resolution + Offset；Raw = (Physical - Offset) / Resolution。Convert 表已给出示例公式。
节点定义 | ICM 为本仪表节点；EMS/BCM/TPMS/IHU/CGW 可由 USB-CAN 上位机或另一块 MCU 模拟。
重要说明 | 这是一版教学与调试用 CAN 矩阵，不是整车厂正式 DBC。先用它把仪表 Demo、RTE/Com、诊断雏形跑通，别又把工程做成大型玄学祭坛。

Sheet: History
版本 | 日期 | 修改人 | 修改内容 | 备注
V0.1 | 2026-05-30 | ChatGPT | 首次建立汽车仪表盘 CAN 报文矩阵 | 参考 Loxi Micro 表格风格，结合当前 ICM 学习板硬件与 Mini AUTOSAR-like 软件架构

Sheet: MsgSummary
Msg ID | Frame Format | BRS | Direction | Tx Node | Rx Node | Msg Name | Msg Type | DLC | Send Type | Cycle(ms) | Delay(ms) | Signal Count | Purpose/Description | Timeout(ms) | Implementation Status | SourceModule | ValidationRule | InterfaceVersion | As-Built / Target Difference
0x440 | StandardCAN | 0 | Tx | ICM | All | NM_Autosar_ICM | NM | 8 | Cyclic/Event | 1000 | 0 | 5 | ICM 节点网络管理报文，Mini AUTOSAR-like 学习用 | 3000 | v1.0 Supported | Bsw/Com/Com.c | NodeAddress=0x40；NormalOperation；1000ms | v1.0 | 节点 0x28/状态错误 -> 0x40/NormalOperation
0x441 | StandardCAN | 0 | Rx | SIM/OtherECU | ICM | NM_Autosar_Sim | NM | 8 | Cyclic/Event | 1000 | 0 | 6 | 仿真节点网络管理报文，USB-CAN 或其他节点发送 | 3000 | v1.0 Supported | Bsw/Com/Com.c + Rte/Rte_Signal.* | 独立 NM online；3000ms timeout | v1.0 | As-Built 未处理 -> NM 在线监督
0x7DF | StandardCAN | 0 | Rx | Tester | ICM/All | Diag_FuncReq | DIAG | 8 | Event | 0 | 0 | 1 | UDS 功能寻址请求，教学级 ISO-TP | N/A | v1.0 Supported | Bsw/CanTp + Bsw/Dcm | 仅 0x22/0x19/0x3E；禁止 0x10/0x14 和写操作 | v1.0 | 原代码与物理同权限 -> 只读白名单
0x700 | StandardCAN | 0 | Rx | Tester | ICM | Diag_ICM_PhysReq | DIAG | 8 | Event | 0 | 0 | 1 | UDS 物理寻址请求 | N/A | v1.0 Supported | Bsw/CanTp + Bsw/Dcm | 物理寻址允许支持的状态改变服务；Single Frame | v1.0 | 补齐与功能寻址权限隔离
0x708 | StandardCAN | 0 | Tx | ICM | Tester | Diag_ICM_Resp | DIAG | 8 | Event | 0 | 0 | 1 | UDS 物理响应 | N/A | v1.0 Supported | Bsw/CanTp + Bsw/Dcm | UDS 正响应/NRC；数值 Big-Endian | v1.0 | 多字节 LE -> UDS BE
0x321 | StandardCAN | 0 | Rx | EMS/Simulator | ICM | EMS_Powertrain_20ms | DIAG/SIGNAL | 8 | Cyclic | 20 | 0 | 6 | 动力总成与基础车辆数据，用于仪表主界面显示 | 100 | v1.0 Supported | Bsw/Com/Com.c + Rte/Rte_Signal.* | 先判断 0x1FFF/0xFFFF/0xFF，再换算；车速 raw&0x1FFF；100ms freshness | v1.0 | 整帧有效且车速未掩码 -> 逐信号有效和安全换算
0x322 | StandardCAN | 0 | Rx | BCM/Simulator | ICM | BCM_BodyStatus_100ms | SIGNAL | 8 | Cyclic/Event | 100 | 0 | 17 | 车身状态与报警灯状态 | 500 | v1.0 Supported | Bsw/Com/Com.c + Rte/Rte_Signal.* | 17 个信号逐位核对；环境光 0xFF 无效；500ms freshness | v1.0 | 仅实现 6/17 -> 完整 17/17
0x323 | StandardCAN | 0 | Rx | TPMS/Simulator | ICM | TPMS_Status_1000ms | SIGNAL | 8 | Cyclic | 1000 | 0 | 8 | 胎压与胎温状态 | 3000 | v1.0 Supported | Bsw/Com/Com.c + Rte/Rte_Signal.* | 四轮压力/温度分别判断 0xFF；3000ms freshness | v1.0 | 无独立有效性 -> 每轮独立有效/报警
0x324 | StandardCAN | 0 | Rx | IHU/CGW/Simulator | ICM | IHU_CGW_Config_500ms | SIGNAL | 8 | Cyclic/Event | 500 | 0 | 9 | 中控/网关发送的仪表配置与主题信息 | 3000 | v1.0 Supported | Bsw/Com/Com.c + Rte/Rte_Signal.* | 范围校验；NvM 为上电基线，合法远端值仅运行期覆盖 | v1.0 | 远端无条件覆盖 -> 有效值和优先级受控
0x325 | StandardCAN | 0 | Tx | ICM | CGW/Tester | ICM_Status_100ms | SIGNAL | 8 | Cyclic/Event | 100 | 0 | 8 | 仪表运行状态与用户显示状态 | 500 | v1.0 Supported | Bsw/Com/Com.c | 100ms；逐字节核对；无里程源时 TripDistance=0xFFFF | v1.0 | 原代码发送车速/转速 -> 按 ICM 状态矩阵重构
0x326 | StandardCAN | 0 | Tx | ICM | CGW/Tester | ICM_DiagStatus_1000ms | DIAG/SIGNAL | 8 | Cyclic/Event | 1000 | 0 | 14 | 仪表自检与故障管理状态 | 3000 | v1.0 Supported | Bsw/Com/Com.c + Bsw/Dem + Bsw/NvM | 1000ms；DTC/LastFaultId/自检/会话/NvM 状态一致 | v1.0 | 原代码仅 4 类摘要 -> 完整 14 信号
0x327 | StandardCAN | 0 | Tx | ICM | CGW/Tester | ICM_UserInput_Event | SIGNAL | 8 | Event | 0 | 0 | 6 | 按键事件报文，短按/长按/关机请求 | 1000 | v1.0 Supported | Bsw/Com/Com.c + Rte/Rte_Event.* | 成功交付 CanIf 后清事件；失败保留重试；Counter 自然回卷 | v1.0 | 发送前消费事件 -> 成功后消费
0x328 | StandardCAN | 0 | Tx | ICM | CGW/Tester | ICM_LogStatus_1000ms | SIGNAL | 8 | Cyclic/Event | 1000 | 0 | 5 | 日志与 TF 卡状态 | 3000 | Stub/Declared | Bsw/Com/Com.c + App/App_Logger | 未接 FatFs 时必须发送未挂载/Stub，文件号 0 | v1.0 | 教学桩保留，但状态显式化；真实文件日志 Planned
0x329 | StandardCAN | 0 | Rx | S32K144/CDM | ICM | CDM_Status_500ms | SIGNAL | 8 | Cyclic | 500 | 0 | 10 | 控制域聚合健康、输入/电源模式、远端故障、总线状态和 E2E 校验 | 1500 | v1.0 Supported | Bsw/Com/Com.c + Rte/Rte_Signal.* | Version=0x10；AliveCounter；CRC8/J1850(ID+B0..B6)；1500ms timeout | v1.0 | As-Built 不存在 -> 新增控制域聚合状态

Sheet: Matrix
Msg ID 报文标识符 | Frame Format 帧格式 | BRS 波特率切换 | Direction 方向 | Tx Node 发送节点 | Rx Node 接收节点 | Msg Name 报文名称 | Msg Type 报文类型 | Msg Length 报文长度(Byte) | Msg Send Type 报文发送类型 | Msg Cycle Time 周期(ms) | Msg Delay Time 延时(ms) | Signal Name 信号名称 | Multiplexor Type 信号复用类型 | Multiplexed Value 复用值 | Start Byte 起始字节 | Start Bit 起始位 | Bit Length 位长度 | Byte Order 字节序 | Data Type 数据类型 | Resolution 精度 | Offset 偏移 | Signal Min 物理最小值 | Signal Max 物理最大值 | Initial Value(hex) 初始值 | Invalid Value(hex) 无效值 | Unit 单位 | Signal Value Description 信号值描述 | Signal Description 信号描述 | Signal Send Type 信号发送类型 | Remark 备注 | Implementation Status 实现状态 | SourceModule 源码模块 | ValidationRule 验证规则 | InterfaceVersion 接口版本 | As-Built / Target Difference 实现与目标差异
0x440 | StandardCAN | 0 | Tx | ICM | All | NM_Autosar_ICM | NM | 8 | Cyclic/Event | 1000 | 0 | ICM_NodeAddress | Normal Signal | 130 | 0 | 0 | 8 | Intel LSB | Unsigned | 1 | 0 | 0 | 255 | 0x40 | 0xFF | 130 | 0x40: ICM Node | ICM 节点地址 | OnWrite | 130 | v1.0 Supported | Bsw/Com/Com.c | NodeAddress=0x40；NormalOperation；1000ms | v1.0 | 节点 0x28/状态错误 -> 0x40/NormalOperation
0x440 | StandardCAN | 0 | Tx | ICM | All | NM_Autosar_ICM | NM | 8 | Cyclic/Event | 1000 | 0 | ICM_RepeatMessageRequestBit | Normal Signal | 130 | 1 | 0 | 1 | Intel LSB | Unsigned | 1 | 0 | 0 | 1 | 0x0 | 0x0 | 130 | 0x0: No Request; 0x1: Request | 重复报文请求位 | OnWrite | 130 | v1.0 Supported | Bsw/Com/Com.c | NodeAddress=0x40；NormalOperation；1000ms | v1.0 | 节点 0x28/状态错误 -> 0x40/NormalOperation
0x440 | StandardCAN | 0 | Tx | ICM | All | NM_Autosar_ICM | NM | 8 | Cyclic/Event | 1000 | 0 | ICM_ActiveWakeupBit | Normal Signal | 130 | 1 | 1 | 1 | Intel LSB | Unsigned | 1 | 0 | 0 | 1 | 0x0 | 0x0 | 130 | 0x0: Passive Wakeup; 0x1: Active Wakeup | 主动唤醒标志 | OnWrite | 130 | v1.0 Supported | Bsw/Com/Com.c | NodeAddress=0x40；NormalOperation；1000ms | v1.0 | 节点 0x28/状态错误 -> 0x40/NormalOperation
0x440 | StandardCAN | 0 | Tx | ICM | All | NM_Autosar_ICM | NM | 8 | Cyclic/Event | 1000 | 0 | ICM_RepeatSts | Normal Signal | 130 | 2 | 0 | 1 | Intel LSB | Unsigned | 1 | 0 | 0 | 1 | 0x0 | 0x0 | 130 | 0x0: Not in RMS; 0x1: Stay in RMS | Repeat Message 状态 | OnWrite | 130 | v1.0 Supported | Bsw/Com/Com.c | NodeAddress=0x40；NormalOperation；1000ms | v1.0 | 节点 0x28/状态错误 -> 0x40/NormalOperation
0x440 | StandardCAN | 0 | Tx | ICM | All | NM_Autosar_ICM | NM | 8 | Cyclic/Event | 1000 | 0 | ICM_NMState | Normal Signal | 130 | 2 | 1 | 3 | Intel LSB | Unsigned | 1 | 0 | 0 | 7 | 0x0 | 0x7 | 130 | 0x0: BusSleep; 0x1: RepeatMessage; 0x2: NormalOperation; 0x3: ReadySleep | 网络管理状态 | OnWrite | 130 | v1.0 Supported | Bsw/Com/Com.c | NodeAddress=0x40；NormalOperation；1000ms | v1.0 | 节点 0x28/状态错误 -> 0x40/NormalOperation
0x441 | StandardCAN | 0 | Rx | SIM/OtherECU | ICM | NM_Autosar_Sim | NM | 8 | Cyclic/Event | 1000 | 0 | SIM_NodeAddress | Normal Signal | 130 | 0 | 0 | 8 | Intel LSB | Unsigned | 1 | 0 | 0 | 255 | 0x41 | 0xFF | 130 | 0x41: Simulator Node | 仿真节点地址 | OnWrite | 130 | v1.0 Supported | Bsw/Com/Com.c + Rte/Rte_Signal.* | 独立 NM online；3000ms timeout | v1.0 | As-Built 未处理 -> NM 在线监督
0x441 | StandardCAN | 0 | Rx | SIM/OtherECU | ICM | NM_Autosar_Sim | NM | 8 | Cyclic/Event | 1000 | 0 | SIM_RepeatMessageRequestBit | Normal Signal | 130 | 1 | 0 | 1 | Intel LSB | Unsigned | 1 | 0 | 0 | 1 | 0x0 | 0x0 | 130 | 0x0: No Request; 0x1: Request | 重复报文请求位 | OnWrite | 130 | v1.0 Supported | Bsw/Com/Com.c + Rte/Rte_Signal.* | 独立 NM online；3000ms timeout | v1.0 | As-Built 未处理 -> NM 在线监督
0x441 | StandardCAN | 0 | Rx | SIM/OtherECU | ICM | NM_Autosar_Sim | NM | 8 | Cyclic/Event | 1000 | 0 | SIM_ActiveWakeupBit | Normal Signal | 130 | 1 | 1 | 1 | Intel LSB | Unsigned | 1 | 0 | 0 | 1 | 0x0 | 0x0 | 130 | 0x0: Passive Wakeup; 0x1: Active Wakeup | 主动唤醒标志 | OnWrite | 130 | v1.0 Supported | Bsw/Com/Com.c + Rte/Rte_Signal.* | 独立 NM online；3000ms timeout | v1.0 | As-Built 未处理 -> NM 在线监督
0x441 | StandardCAN | 0 | Rx | SIM/OtherECU | ICM | NM_Autosar_Sim | NM | 8 | Cyclic/Event | 1000 | 0 | SIM_RepeatSts | Normal Signal | 130 | 2 | 0 | 1 | Intel LSB | Unsigned | 1 | 0 | 0 | 1 | 0x0 | 0x0 | 130 | 0x0: Not in RMS; 0x1: Stay in RMS | Repeat Message 状态 | OnWrite | 130 | v1.0 Supported | Bsw/Com/Com.c + Rte/Rte_Signal.* | 独立 NM online；3000ms timeout | v1.0 | As-Built 未处理 -> NM 在线监督
0x441 | StandardCAN | 0 | Rx | SIM/OtherECU | ICM | NM_Autosar_Sim | NM | 8 | Cyclic/Event | 1000 | 0 | SIM_NMReq_PowerOn | Normal Signal | 130 | 2 | 1 | 1 | Intel LSB | Unsigned | 1 | 0 | 0 | 1 | 0x0 | 0x0 | 130 | 0x0: Inactive; 0x1: Active | 仿真节点请求系统保持唤醒 | OnWrite | 130 | v1.0 Supported | Bsw/Com/Com.c + Rte/Rte_Signal.* | 独立 NM online；3000ms timeout | v1.0 | As-Built 未处理 -> NM 在线监督
0x441 | StandardCAN | 0 | Rx | SIM/OtherECU | ICM | NM_Autosar_Sim | NM | 8 | Cyclic/Event | 1000 | 0 | SIM_NMReq_Diag | Normal Signal | 130 | 2 | 2 | 1 | Intel LSB | Unsigned | 1 | 0 | 0 | 1 | 0x0 | 0x0 | 130 | 0x0: Inactive; 0x1: Active | 诊断请求网络保持 | OnWrite | 130 | v1.0 Supported | Bsw/Com/Com.c + Rte/Rte_Signal.* | 独立 NM online；3000ms timeout | v1.0 | As-Built 未处理 -> NM 在线监督
0x7DF | StandardCAN | 0 | Rx | Tester | ICM/All | Diag_FuncReq | DIAG | 8 | Event | 0 | 0 | Diag_FuncReq_Data | Normal Signal | 130 | 0 | 0 | 64 | Intel LSB | Unsigned | 1 | 0 | 0 | 0 | 0x00 | 0x00 | 130 | 130 | 诊断功能寻址请求原始 8 字节数据 | OnWrite | 第一阶段可只透传到 Dcm | v1.0 Supported | Bsw/CanTp + Bsw/Dcm | 仅 0x22/0x19/0x3E；禁止 0x10/0x14 和写操作 | v1.0 | 原代码与物理同权限 -> 只读白名单
0x700 | StandardCAN | 0 | Rx | Tester | ICM | Diag_ICM_PhysReq | DIAG | 8 | Event | 0 | 0 | Diag_ICM_PhyReq_Data | Normal Signal | 130 | 0 | 0 | 64 | Intel LSB | Unsigned | 1 | 0 | 0 | 0 | 0x00 | 0x00 | 130 | 130 | 诊断物理寻址请求原始 8 字节数据 | OnWrite | 支持 0x10/0x22/0x19/0x14/0x31 子集 | v1.0 Supported | Bsw/CanTp + Bsw/Dcm | 物理寻址允许支持的状态改变服务；Single Frame | v1.0 | 补齐与功能寻址权限隔离
0x708 | StandardCAN | 0 | Tx | ICM | Tester | Diag_ICM_Resp | DIAG | 8 | Event | 0 | 0 | Diag_ICM_Resp_Data | Normal Signal | 130 | 0 | 0 | 64 | Intel LSB | Unsigned | 1 | 0 | 0 | 0 | 0x00 | 0x00 | 130 | 130 | 诊断响应原始 8 字节数据 | OnWrite | 由 Dcm/CanTp 生成 | v1.0 Supported | Bsw/CanTp + Bsw/Dcm | UDS 正响应/NRC；数值 Big-Endian | v1.0 | 多字节 LE -> UDS BE
0x321 | StandardCAN | 0 | Rx | EMS/Simulator | ICM | EMS_Powertrain_20ms | DIAG/SIGNAL | 8 | Cyclic | 20 | 0 | VehicleSpeed | Normal Signal | 130 | 0 | 0 | 13 | Intel LSB | Unsigned | 0.0625 | 0 | 0 | 511.875 | 0x0000 | 0x1FFF | km/h | 130 | 车速 | OnWrite | raw = speed / 0.0625 | v1.0 Supported | Bsw/Com/Com.c + Rte/Rte_Signal.* | 先判断 0x1FFF/0xFFFF/0xFF，再换算；车速 raw&0x1FFF；100ms freshness | v1.0 | 整帧有效且车速未掩码 -> 逐信号有效和安全换算
0x321 | StandardCAN | 0 | Rx | EMS/Simulator | ICM | EMS_Powertrain_20ms | DIAG/SIGNAL | 8 | Cyclic | 20 | 0 | EngineSpeed | Normal Signal | 130 | 2 | 0 | 16 | Intel LSB | Unsigned | 0.25 | 0 | 0 | 16000 | 0x0000 | 0xFFFF | rpm | 130 | 发动机转速 | OnWrite | raw = rpm / 0.25 | v1.0 Supported | Bsw/Com/Com.c + Rte/Rte_Signal.* | 先判断 0x1FFF/0xFFFF/0xFF，再换算；车速 raw&0x1FFF；100ms freshness | v1.0 | 整帧有效且车速未掩码 -> 逐信号有效和安全换算
0x321 | StandardCAN | 0 | Rx | EMS/Simulator | ICM | EMS_Powertrain_20ms | DIAG/SIGNAL | 8 | Cyclic | 20 | 0 | FuelPercent | Normal Signal | 130 | 4 | 0 | 8 | Intel LSB | Unsigned | 0.4 | 0 | 0 | 100 | 0x00 | 0xFF | % | 130 | 油量百分比 | OnWrite | raw 250 = 100% | v1.0 Supported | Bsw/Com/Com.c + Rte/Rte_Signal.* | 先判断 0x1FFF/0xFFFF/0xFF，再换算；车速 raw&0x1FFF；100ms freshness | v1.0 | 整帧有效且车速未掩码 -> 逐信号有效和安全换算
0x321 | StandardCAN | 0 | Rx | EMS/Simulator | ICM | EMS_Powertrain_20ms | DIAG/SIGNAL | 8 | Cyclic | 20 | 0 | EngineCoolantTemperature | Normal Signal | 130 | 5 | 0 | 8 | Intel LSB | Signed/Offset | 1 | -40 | -40 | 215 | 0x28 | 0xFF | ℃ | 130 | 水温，物理值 = raw - 40 | OnWrite | 130 | v1.0 Supported | Bsw/Com/Com.c + Rte/Rte_Signal.* | 先判断 0x1FFF/0xFFFF/0xFF，再换算；车速 raw&0x1FFF；100ms freshness | v1.0 | 整帧有效且车速未掩码 -> 逐信号有效和安全换算
0x321 | StandardCAN | 0 | Rx | EMS/Simulator | ICM | EMS_Powertrain_20ms | DIAG/SIGNAL | 8 | Cyclic | 20 | 0 | OutdoorTemperature | Normal Signal | 130 | 6 | 0 | 8 | Intel LSB | Signed/Offset | 1 | -40 | -40 | 85 | 0x28 | 0xFF | ℃ | 130 | 车外温度，物理值 = raw - 40 | OnWrite | 130 | v1.0 Supported | Bsw/Com/Com.c + Rte/Rte_Signal.* | 先判断 0x1FFF/0xFFFF/0xFF，再换算；车速 raw&0x1FFF；100ms freshness | v1.0 | 整帧有效且车速未掩码 -> 逐信号有效和安全换算
0x321 | StandardCAN | 0 | Rx | EMS/Simulator | ICM | EMS_Powertrain_20ms | DIAG/SIGNAL | 8 | Cyclic | 20 | 0 | BatteryVoltage | Normal Signal | 130 | 7 | 0 | 8 | Intel LSB | Unsigned | 0.1 | 0 | 0 | 25.5 | 0x78 | 0xFF | V | 130 | 整车/板载供电电压，用于欠压提示 | OnWrite | 130 | v1.0 Supported | Bsw/Com/Com.c + Rte/Rte_Signal.* | 先判断 0x1FFF/0xFFFF/0xFF，再换算；车速 raw&0x1FFF；100ms freshness | v1.0 | 整帧有效且车速未掩码 -> 逐信号有效和安全换算
0x322 | StandardCAN | 0 | Rx | BCM/Simulator | ICM | BCM_BodyStatus_100ms | SIGNAL | 8 | Cyclic/Event | 100 | 0 | IgnitionStatus | Normal Signal | 130 | 0 | 0 | 2 | Intel LSB | Unsigned | 1 | 0 | 0 | 3 | 0x0 | 0x3 | 130 | 0x0: OFF; 0x1: ACC; 0x2: ON; 0x3: START | 点火状态 | OnWrite | 130 | v1.0 Supported | Bsw/Com/Com.c + Rte/Rte_Signal.* | 17 个信号逐位核对；环境光 0xFF 无效；500ms freshness | v1.0 | 仅实现 6/17 -> 完整 17/17
0x322 | StandardCAN | 0 | Rx | BCM/Simulator | ICM | BCM_BodyStatus_100ms | SIGNAL | 8 | Cyclic/Event | 100 | 0 | GearPosition | Normal Signal | 130 | 0 | 2 | 4 | Intel LSB | Unsigned | 1 | 0 | 0 | 15 | 0x0 | 0xF | 130 | 0x0: P; 0x1: R; 0x2: N; 0x3: D; 0x4: S; 0x5: M | 挡位 | OnWrite | 130 | v1.0 Supported | Bsw/Com/Com.c + Rte/Rte_Signal.* | 17 个信号逐位核对；环境光 0xFF 无效；500ms freshness | v1.0 | 仅实现 6/17 -> 完整 17/17
0x322 | StandardCAN | 0 | Rx | BCM/Simulator | ICM | BCM_BodyStatus_100ms | SIGNAL | 8 | Cyclic/Event | 100 | 0 | Door_FL_Open | Normal Signal | 130 | 1 | 0 | 1 | Intel LSB | Unsigned | 1 | 0 | 0 | 1 | 0x0 | 0x0 | 130 | 0x0: Closed; 0x1: Open | 左前门状态 | OnWrite | 130 | v1.0 Supported | Bsw/Com/Com.c + Rte/Rte_Signal.* | 17 个信号逐位核对；环境光 0xFF 无效；500ms freshness | v1.0 | 仅实现 6/17 -> 完整 17/17
0x322 | StandardCAN | 0 | Rx | BCM/Simulator | ICM | BCM_BodyStatus_100ms | SIGNAL | 8 | Cyclic/Event | 100 | 0 | Door_FR_Open | Normal Signal | 130 | 1 | 1 | 1 | Intel LSB | Unsigned | 1 | 0 | 0 | 1 | 0x0 | 0x0 | 130 | 0x0: Closed; 0x1: Open | 右前门状态 | OnWrite | 130 | v1.0 Supported | Bsw/Com/Com.c + Rte/Rte_Signal.* | 17 个信号逐位核对；环境光 0xFF 无效；500ms freshness | v1.0 | 仅实现 6/17 -> 完整 17/17
0x322 | StandardCAN | 0 | Rx | BCM/Simulator | ICM | BCM_BodyStatus_100ms | SIGNAL | 8 | Cyclic/Event | 100 | 0 | Door_RL_Open | Normal Signal | 130 | 1 | 2 | 1 | Intel LSB | Unsigned | 1 | 0 | 0 | 1 | 0x0 | 0x0 | 130 | 0x0: Closed; 0x1: Open | 左后门状态 | OnWrite | 130 | v1.0 Supported | Bsw/Com/Com.c + Rte/Rte_Signal.* | 17 个信号逐位核对；环境光 0xFF 无效；500ms freshness | v1.0 | 仅实现 6/17 -> 完整 17/17
0x322 | StandardCAN | 0 | Rx | BCM/Simulator | ICM | BCM_BodyStatus_100ms | SIGNAL | 8 | Cyclic/Event | 100 | 0 | Door_RR_Open | Normal Signal | 130 | 1 | 3 | 1 | Intel LSB | Unsigned | 1 | 0 | 0 | 1 | 0x0 | 0x0 | 130 | 0x0: Closed; 0x1: Open | 右后门状态 | OnWrite | 130 | v1.0 Supported | Bsw/Com/Com.c + Rte/Rte_Signal.* | 17 个信号逐位核对；环境光 0xFF 无效；500ms freshness | v1.0 | 仅实现 6/17 -> 完整 17/17
0x322 | StandardCAN | 0 | Rx | BCM/Simulator | ICM | BCM_BodyStatus_100ms | SIGNAL | 8 | Cyclic/Event | 100 | 0 | SeatbeltDriver | Normal Signal | 130 | 1 | 4 | 1 | Intel LSB | Unsigned | 1 | 0 | 0 | 1 | 0x0 | 0x0 | 130 | 0x0: Buckled; 0x1: Unbuckled | 主驾安全带 | OnWrite | 130 | v1.0 Supported | Bsw/Com/Com.c + Rte/Rte_Signal.* | 17 个信号逐位核对；环境光 0xFF 无效；500ms freshness | v1.0 | 仅实现 6/17 -> 完整 17/17
0x322 | StandardCAN | 0 | Rx | BCM/Simulator | ICM | BCM_BodyStatus_100ms | SIGNAL | 8 | Cyclic/Event | 100 | 0 | LowBeamStatus | Normal Signal | 130 | 2 | 0 | 1 | Intel LSB | Unsigned | 1 | 0 | 0 | 1 | 0x0 | 0x0 | 130 | 0x0: Off; 0x1: On | 近光灯 | OnWrite | 130 | v1.0 Supported | Bsw/Com/Com.c + Rte/Rte_Signal.* | 17 个信号逐位核对；环境光 0xFF 无效；500ms freshness | v1.0 | 仅实现 6/17 -> 完整 17/17
0x322 | StandardCAN | 0 | Rx | BCM/Simulator | ICM | BCM_BodyStatus_100ms | SIGNAL | 8 | Cyclic/Event | 100 | 0 | HighBeamStatus | Normal Signal | 130 | 2 | 1 | 1 | Intel LSB | Unsigned | 1 | 0 | 0 | 1 | 0x0 | 0x0 | 130 | 0x0: Off; 0x1: On | 远光灯 | OnWrite | 130 | v1.0 Supported | Bsw/Com/Com.c + Rte/Rte_Signal.* | 17 个信号逐位核对；环境光 0xFF 无效；500ms freshness | v1.0 | 仅实现 6/17 -> 完整 17/17
0x322 | StandardCAN | 0 | Rx | BCM/Simulator | ICM | BCM_BodyStatus_100ms | SIGNAL | 8 | Cyclic/Event | 100 | 0 | TurnLampStatus | Normal Signal | 130 | 2 | 2 | 2 | Intel LSB | Unsigned | 1 | 0 | 0 | 3 | 0x0 | 0x3 | 130 | 0x0: Off; 0x1: Left; 0x2: Right; 0x3: Hazard | 转向灯/双闪状态 | OnWrite | 130 | v1.0 Supported | Bsw/Com/Com.c + Rte/Rte_Signal.* | 17 个信号逐位核对；环境光 0xFF 无效；500ms freshness | v1.0 | 仅实现 6/17 -> 完整 17/17
0x322 | StandardCAN | 0 | Rx | BCM/Simulator | ICM | BCM_BodyStatus_100ms | SIGNAL | 8 | Cyclic/Event | 100 | 0 | ParkingBrake | Normal Signal | 130 | 2 | 4 | 1 | Intel LSB | Unsigned | 1 | 0 | 0 | 1 | 0x0 | 0x0 | 130 | 0x0: Released; 0x1: Applied | 驻车制动 | OnWrite | 130 | v1.0 Supported | Bsw/Com/Com.c + Rte/Rte_Signal.* | 17 个信号逐位核对；环境光 0xFF 无效；500ms freshness | v1.0 | 仅实现 6/17 -> 完整 17/17
0x322 | StandardCAN | 0 | Rx | BCM/Simulator | ICM | BCM_BodyStatus_100ms | SIGNAL | 8 | Cyclic/Event | 100 | 0 | MIL_Lamp | Normal Signal | 130 | 3 | 0 | 1 | Intel LSB | Unsigned | 1 | 0 | 0 | 1 | 0x0 | 0x0 | 130 | 0x0: Off; 0x1: On | 发动机故障灯 | OnWrite | 130 | v1.0 Supported | Bsw/Com/Com.c + Rte/Rte_Signal.* | 17 个信号逐位核对；环境光 0xFF 无效；500ms freshness | v1.0 | 仅实现 6/17 -> 完整 17/17
0x322 | StandardCAN | 0 | Rx | BCM/Simulator | ICM | BCM_BodyStatus_100ms | SIGNAL | 8 | Cyclic/Event | 100 | 0 | ABS_Lamp | Normal Signal | 130 | 3 | 1 | 1 | Intel LSB | Unsigned | 1 | 0 | 0 | 1 | 0x0 | 0x0 | 130 | 0x0: Off; 0x1: On | ABS 故障灯 | OnWrite | 130 | v1.0 Supported | Bsw/Com/Com.c + Rte/Rte_Signal.* | 17 个信号逐位核对；环境光 0xFF 无效；500ms freshness | v1.0 | 仅实现 6/17 -> 完整 17/17
0x322 | StandardCAN | 0 | Rx | BCM/Simulator | ICM | BCM_BodyStatus_100ms | SIGNAL | 8 | Cyclic/Event | 100 | 0 | Airbag_Lamp | Normal Signal | 130 | 3 | 2 | 1 | Intel LSB | Unsigned | 1 | 0 | 0 | 1 | 0x0 | 0x0 | 130 | 0x0: Off; 0x1: On | 安全气囊故障灯 | OnWrite | 130 | v1.0 Supported | Bsw/Com/Com.c + Rte/Rte_Signal.* | 17 个信号逐位核对；环境光 0xFF 无效；500ms freshness | v1.0 | 仅实现 6/17 -> 完整 17/17
0x322 | StandardCAN | 0 | Rx | BCM/Simulator | ICM | BCM_BodyStatus_100ms | SIGNAL | 8 | Cyclic/Event | 100 | 0 | Brake_Lamp | Normal Signal | 130 | 3 | 3 | 1 | Intel LSB | Unsigned | 1 | 0 | 0 | 1 | 0x0 | 0x0 | 130 | 0x0: Off; 0x1: On | 制动系统故障灯 | OnWrite | 130 | v1.0 Supported | Bsw/Com/Com.c + Rte/Rte_Signal.* | 17 个信号逐位核对；环境光 0xFF 无效；500ms freshness | v1.0 | 仅实现 6/17 -> 完整 17/17
0x322 | StandardCAN | 0 | Rx | BCM/Simulator | ICM | BCM_BodyStatus_100ms | SIGNAL | 8 | Cyclic/Event | 100 | 0 | WasherFluidLow | Normal Signal | 130 | 4 | 0 | 1 | Intel LSB | Unsigned | 1 | 0 | 0 | 1 | 0x0 | 0x0 | 130 | 0x0: Normal; 0x1: Low | 玻璃水液位低 | OnWrite | 130 | v1.0 Supported | Bsw/Com/Com.c + Rte/Rte_Signal.* | 17 个信号逐位核对；环境光 0xFF 无效；500ms freshness | v1.0 | 仅实现 6/17 -> 完整 17/17
0x322 | StandardCAN | 0 | Rx | BCM/Simulator | ICM | BCM_BodyStatus_100ms | SIGNAL | 8 | Cyclic/Event | 100 | 0 | AmbientLightLevel | Normal Signal | 130 | 5 | 0 | 8 | Intel LSB | Unsigned | 1 | 0 | 0 | 100 | 0x32 | 0xFF | % | 130 | 环境光强度百分比，可用于自动背光 | OnWrite | 130 | v1.0 Supported | Bsw/Com/Com.c + Rte/Rte_Signal.* | 17 个信号逐位核对；环境光 0xFF 无效；500ms freshness | v1.0 | 仅实现 6/17 -> 完整 17/17
0x323 | StandardCAN | 0 | Rx | TPMS/Simulator | ICM | TPMS_Status_1000ms | SIGNAL | 8 | Cyclic | 1000 | 0 | LF_TirePressure | Normal Signal | 130 | 0 | 0 | 8 | Intel LSB | Unsigned | 0.0275 | 0 | 0 | 3.5 | 0x00 | 0xFF | Bar | 130 | 左前胎压 | OnWrite | 130 | v1.0 Supported | Bsw/Com/Com.c + Rte/Rte_Signal.* | 四轮压力/温度分别判断 0xFF；3000ms freshness | v1.0 | 无独立有效性 -> 每轮独立有效/报警
0x323 | StandardCAN | 0 | Rx | TPMS/Simulator | ICM | TPMS_Status_1000ms | SIGNAL | 8 | Cyclic | 1000 | 0 | RF_TirePressure | Normal Signal | 130 | 1 | 0 | 8 | Intel LSB | Unsigned | 0.0275 | 0 | 0 | 3.5 | 0x00 | 0xFF | Bar | 130 | 右前胎压 | OnWrite | 130 | v1.0 Supported | Bsw/Com/Com.c + Rte/Rte_Signal.* | 四轮压力/温度分别判断 0xFF；3000ms freshness | v1.0 | 无独立有效性 -> 每轮独立有效/报警
0x323 | StandardCAN | 0 | Rx | TPMS/Simulator | ICM | TPMS_Status_1000ms | SIGNAL | 8 | Cyclic | 1000 | 0 | LR_TirePressure | Normal Signal | 130 | 2 | 0 | 8 | Intel LSB | Unsigned | 0.0275 | 0 | 0 | 3.5 | 0x00 | 0xFF | Bar | 130 | 左后胎压 | OnWrite | 130 | v1.0 Supported | Bsw/Com/Com.c + Rte/Rte_Signal.* | 四轮压力/温度分别判断 0xFF；3000ms freshness | v1.0 | 无独立有效性 -> 每轮独立有效/报警
0x323 | StandardCAN | 0 | Rx | TPMS/Simulator | ICM | TPMS_Status_1000ms | SIGNAL | 8 | Cyclic | 1000 | 0 | RR_TirePressure | Normal Signal | 130 | 3 | 0 | 8 | Intel LSB | Unsigned | 0.0275 | 0 | 0 | 3.5 | 0x00 | 0xFF | Bar | 130 | 右后胎压 | OnWrite | 130 | v1.0 Supported | Bsw/Com/Com.c + Rte/Rte_Signal.* | 四轮压力/温度分别判断 0xFF；3000ms freshness | v1.0 | 无独立有效性 -> 每轮独立有效/报警
0x323 | StandardCAN | 0 | Rx | TPMS/Simulator | ICM | TPMS_Status_1000ms | SIGNAL | 8 | Cyclic | 1000 | 0 | LF_TireTemperature | Normal Signal | 130 | 4 | 0 | 8 | Intel LSB | Signed/Offset | 1 | -40 | -40 | 125 | 0x28 | 0xFF | ℃ | 130 | 左前胎温，物理值 = raw - 40 | OnWrite | 130 | v1.0 Supported | Bsw/Com/Com.c + Rte/Rte_Signal.* | 四轮压力/温度分别判断 0xFF；3000ms freshness | v1.0 | 无独立有效性 -> 每轮独立有效/报警
0x323 | StandardCAN | 0 | Rx | TPMS/Simulator | ICM | TPMS_Status_1000ms | SIGNAL | 8 | Cyclic | 1000 | 0 | RF_TireTemperature | Normal Signal | 130 | 5 | 0 | 8 | Intel LSB | Signed/Offset | 1 | -40 | -40 | 125 | 0x28 | 0xFF | ℃ | 130 | 右前胎温，物理值 = raw - 40 | OnWrite | 130 | v1.0 Supported | Bsw/Com/Com.c + Rte/Rte_Signal.* | 四轮压力/温度分别判断 0xFF；3000ms freshness | v1.0 | 无独立有效性 -> 每轮独立有效/报警
0x323 | StandardCAN | 0 | Rx | TPMS/Simulator | ICM | TPMS_Status_1000ms | SIGNAL | 8 | Cyclic | 1000 | 0 | LR_TireTemperature | Normal Signal | 130 | 6 | 0 | 8 | Intel LSB | Signed/Offset | 1 | -40 | -40 | 125 | 0x28 | 0xFF | ℃ | 130 | 左后胎温，物理值 = raw - 40 | OnWrite | 130 | v1.0 Supported | Bsw/Com/Com.c + Rte/Rte_Signal.* | 四轮压力/温度分别判断 0xFF；3000ms freshness | v1.0 | 无独立有效性 -> 每轮独立有效/报警
0x323 | StandardCAN | 0 | Rx | TPMS/Simulator | ICM | TPMS_Status_1000ms | SIGNAL | 8 | Cyclic | 1000 | 0 | RR_TireTemperature | Normal Signal | 130 | 7 | 0 | 8 | Intel LSB | Signed/Offset | 1 | -40 | -40 | 125 | 0x28 | 0xFF | ℃ | 130 | 右后胎温，物理值 = raw - 40 | OnWrite | 130 | v1.0 Supported | Bsw/Com/Com.c + Rte/Rte_Signal.* | 四轮压力/温度分别判断 0xFF；3000ms freshness | v1.0 | 无独立有效性 -> 每轮独立有效/报警
0x324 | StandardCAN | 0 | Rx | IHU/CGW/Simulator | ICM | IHU_CGW_Config_500ms | SIGNAL | 8 | Cyclic/Event | 500 | 0 | ThemeMode | Normal Signal | 130 | 0 | 0 | 3 | Intel LSB | Unsigned | 1 | 0 | 0 | 7 | 0x0 | 0x7 | 130 | 0x0: Auto; 0x1: Classic; 0x2: Sport; 0x3: Night | 仪表主题模式 | OnWrite | 130 | v1.0 Supported | Bsw/Com/Com.c + Rte/Rte_Signal.* | 范围校验；NvM 为上电基线，合法远端值仅运行期覆盖 | v1.0 | 远端无条件覆盖 -> 有效值和优先级受控
0x324 | StandardCAN | 0 | Rx | IHU/CGW/Simulator | ICM | IHU_CGW_Config_500ms | SIGNAL | 8 | Cyclic/Event | 500 | 0 | SetLanguage | Normal Signal | 130 | 0 | 3 | 3 | Intel LSB | Unsigned | 1 | 0 | 0 | 7 | 0x0 | 0x7 | 130 | 0x0: zh_CN; 0x1: en_US | 显示语言 | OnWrite | 130 | v1.0 Supported | Bsw/Com/Com.c + Rte/Rte_Signal.* | 范围校验；NvM 为上电基线，合法远端值仅运行期覆盖 | v1.0 | 远端无条件覆盖 -> 有效值和优先级受控
0x324 | StandardCAN | 0 | Rx | IHU/CGW/Simulator | ICM | IHU_CGW_Config_500ms | SIGNAL | 8 | Cyclic/Event | 500 | 0 | UnitMode | Normal Signal | 130 | 0 | 6 | 2 | Intel LSB | Unsigned | 1 | 0 | 0 | 3 | 0x0 | 0x3 | 130 | 0x0: Metric; 0x1: Imperial | 单位制 | OnWrite | 130 | v1.0 Supported | Bsw/Com/Com.c + Rte/Rte_Signal.* | 范围校验；NvM 为上电基线，合法远端值仅运行期覆盖 | v1.0 | 远端无条件覆盖 -> 有效值和优先级受控
0x324 | StandardCAN | 0 | Rx | IHU/CGW/Simulator | ICM | IHU_CGW_Config_500ms | SIGNAL | 8 | Cyclic/Event | 500 | 0 | BacklightLevelSet | Normal Signal | 130 | 1 | 0 | 8 | Intel LSB | Unsigned | 1 | 0 | 0 | 100 | 0x64 | 0xFF | % | 130 | 背光目标亮度 | OnWrite | 130 | v1.0 Supported | Bsw/Com/Com.c + Rte/Rte_Signal.* | 范围校验；NvM 为上电基线，合法远端值仅运行期覆盖 | v1.0 | 远端无条件覆盖 -> 有效值和优先级受控
0x324 | StandardCAN | 0 | Rx | IHU/CGW/Simulator | ICM | IHU_CGW_Config_500ms | SIGNAL | 8 | Cyclic/Event | 500 | 0 | WarningVolumeSet | Normal Signal | 130 | 2 | 0 | 8 | Intel LSB | Unsigned | 1 | 0 | 0 | 100 | 0x50 | 0xFF | % | 130 | 蜂鸣器报警音量目标值 | OnWrite | 130 | v1.0 Supported | Bsw/Com/Com.c + Rte/Rte_Signal.* | 范围校验；NvM 为上电基线，合法远端值仅运行期覆盖 | v1.0 | 远端无条件覆盖 -> 有效值和优先级受控
0x324 | StandardCAN | 0 | Rx | IHU/CGW/Simulator | ICM | IHU_CGW_Config_500ms | SIGNAL | 8 | Cyclic/Event | 500 | 0 | DrivingRange | Normal Signal | 130 | 3 | 0 | 16 | Intel LSB | Unsigned | 1 | 0 | 0 | 9999 | 0x0000 | 0xFFFF | km | 130 | 续航里程 | OnWrite | 130 | v1.0 Supported | Bsw/Com/Com.c + Rte/Rte_Signal.* | 范围校验；NvM 为上电基线，合法远端值仅运行期覆盖 | v1.0 | 远端无条件覆盖 -> 有效值和优先级受控
0x324 | StandardCAN | 0 | Rx | IHU/CGW/Simulator | ICM | IHU_CGW_Config_500ms | SIGNAL | 8 | Cyclic/Event | 500 | 0 | DateTimeValid | Normal Signal | 130 | 5 | 0 | 1 | Intel LSB | Unsigned | 1 | 0 | 0 | 1 | 0x0 | 0x0 | 130 | 0x0: Invalid; 0x1: Valid | 外部时间同步有效标志 | OnWrite | 130 | v1.0 Supported | Bsw/Com/Com.c + Rte/Rte_Signal.* | 范围校验；NvM 为上电基线，合法远端值仅运行期覆盖 | v1.0 | 远端无条件覆盖 -> 有效值和优先级受控
0x324 | StandardCAN | 0 | Rx | IHU/CGW/Simulator | ICM | IHU_CGW_Config_500ms | SIGNAL | 8 | Cyclic/Event | 500 | 0 | TimeHour | Normal Signal | 130 | 6 | 0 | 5 | Intel LSB | Unsigned | 1 | 0 | 0 | 23 | 0x00 | 0x1F | h | 130 | 小时 | OnWrite | 130 | v1.0 Supported | Bsw/Com/Com.c + Rte/Rte_Signal.* | 范围校验；NvM 为上电基线，合法远端值仅运行期覆盖 | v1.0 | 远端无条件覆盖 -> 有效值和优先级受控
0x324 | StandardCAN | 0 | Rx | IHU/CGW/Simulator | ICM | IHU_CGW_Config_500ms | SIGNAL | 8 | Cyclic/Event | 500 | 0 | TimeMinute | Normal Signal | 130 | 7 | 0 | 6 | Intel LSB | Unsigned | 1 | 0 | 0 | 59 | 0x00 | 0x3F | min | 130 | 分钟 | OnWrite | 130 | v1.0 Supported | Bsw/Com/Com.c + Rte/Rte_Signal.* | 范围校验；NvM 为上电基线，合法远端值仅运行期覆盖 | v1.0 | 远端无条件覆盖 -> 有效值和优先级受控
0x325 | StandardCAN | 0 | Tx | ICM | CGW/Tester | ICM_Status_100ms | SIGNAL | 8 | Cyclic/Event | 100 | 0 | ICM_Mode | Normal Signal | 130 | 0 | 0 | 3 | Intel LSB | Unsigned | 1 | 0 | 0 | 7 | 0x0 | 0x7 | 130 | 0x0: Boot; 0x1: SelfTest; 0x2: Run; 0x3: Diag; 0x4: Fault; 0x5: SleepPrepare | 仪表系统状态机 | OnWrite | 130 | v1.0 Supported | Bsw/Com/Com.c | 100ms；逐字节核对；无里程源时 TripDistance=0xFFFF | v1.0 | 原代码发送车速/转速 -> 按 ICM 状态矩阵重构
0x325 | StandardCAN | 0 | Tx | ICM | CGW/Tester | ICM_Status_100ms | SIGNAL | 8 | Cyclic/Event | 100 | 0 | DisplayPage | Normal Signal | 130 | 0 | 3 | 3 | Intel LSB | Unsigned | 1 | 0 | 0 | 7 | 0x0 | 0x7 | 130 | 0x0: Boot; 0x1: Main; 0x2: Warning; 0x3: Setting | 当前显示页面 | OnWrite | 130 | v1.0 Supported | Bsw/Com/Com.c | 100ms；逐字节核对；无里程源时 TripDistance=0xFFFF | v1.0 | 原代码发送车速/转速 -> 按 ICM 状态矩阵重构
0x325 | StandardCAN | 0 | Tx | ICM | CGW/Tester | ICM_Status_100ms | SIGNAL | 8 | Cyclic/Event | 100 | 0 | BuzzerStatus | Normal Signal | 130 | 1 | 0 | 2 | Intel LSB | Unsigned | 1 | 0 | 0 | 3 | 0x0 | 0x3 | 130 | 0x0: Off; 0x1: ShortBeep; 0x2: LongBeep; 0x3: Continuous | 蜂鸣器状态 | OnWrite | 130 | v1.0 Supported | Bsw/Com/Com.c | 100ms；逐字节核对；无里程源时 TripDistance=0xFFFF | v1.0 | 原代码发送车速/转速 -> 按 ICM 状态矩阵重构
0x325 | StandardCAN | 0 | Tx | ICM | CGW/Tester | ICM_Status_100ms | SIGNAL | 8 | Cyclic/Event | 100 | 0 | BacklightActual | Normal Signal | 130 | 2 | 0 | 8 | Intel LSB | Unsigned | 1 | 0 | 0 | 100 | 0x64 | 0xFF | % | 130 | 实际背光亮度 | OnWrite | 130 | v1.0 Supported | Bsw/Com/Com.c | 100ms；逐字节核对；无里程源时 TripDistance=0xFFFF | v1.0 | 原代码发送车速/转速 -> 按 ICM 状态矩阵重构
0x325 | StandardCAN | 0 | Tx | ICM | CGW/Tester | ICM_Status_100ms | SIGNAL | 8 | Cyclic/Event | 100 | 0 | TripDistance | Normal Signal | 130 | 3 | 0 | 16 | Intel LSB | Unsigned | 0.1 | 0 | 0 | 6553.5 | 0x0000 | 0xFFFF | km | 130 | 小计里程 | OnWrite | 由 APP 计算，可掉电保存到 NvM | v1.0 Supported | Bsw/Com/Com.c | 100ms；逐字节核对；无里程源时 TripDistance=0xFFFF | v1.0 | 原代码发送车速/转速 -> 按 ICM 状态矩阵重构
0x325 | StandardCAN | 0 | Tx | ICM | CGW/Tester | ICM_Status_100ms | SIGNAL | 8 | Cyclic/Event | 100 | 0 | DriveTime | Normal Signal | 130 | 5 | 0 | 16 | Intel LSB | Unsigned | 1 | 0 | 0 | 65535 | 0x0000 | 0xFFFF | min | 130 | 本次行驶时间 | OnWrite | 130 | v1.0 Supported | Bsw/Com/Com.c | 100ms；逐字节核对；无里程源时 TripDistance=0xFFFF | v1.0 | 原代码发送车速/转速 -> 按 ICM 状态矩阵重构
0x325 | StandardCAN | 0 | Tx | ICM | CGW/Tester | ICM_Status_100ms | SIGNAL | 8 | Cyclic/Event | 100 | 0 | ShutdownRequest | Normal Signal | 130 | 7 | 0 | 1 | Intel LSB | Unsigned | 1 | 0 | 0 | 1 | 0x0 | 0x0 | 130 | 0x0: No Request; 0x1: Request | 仪表请求关机 | OnWrite | 130 | v1.0 Supported | Bsw/Com/Com.c | 100ms；逐字节核对；无里程源时 TripDistance=0xFFFF | v1.0 | 原代码发送车速/转速 -> 按 ICM 状态矩阵重构
0x325 | StandardCAN | 0 | Tx | ICM | CGW/Tester | ICM_Status_100ms | SIGNAL | 8 | Cyclic/Event | 100 | 0 | FaultLampRequest | Normal Signal | 130 | 7 | 1 | 1 | Intel LSB | Unsigned | 1 | 0 | 0 | 1 | 0x0 | 0x0 | 130 | 0x0: Off; 0x1: On | 仪表综合故障灯请求 | OnWrite | 130 | v1.0 Supported | Bsw/Com/Com.c | 100ms；逐字节核对；无里程源时 TripDistance=0xFFFF | v1.0 | 原代码发送车速/转速 -> 按 ICM 状态矩阵重构
0x326 | StandardCAN | 0 | Tx | ICM | CGW/Tester | ICM_DiagStatus_1000ms | DIAG/SIGNAL | 8 | Cyclic/Event | 1000 | 0 | DtcCount | Normal Signal | 130 | 0 | 0 | 8 | Intel LSB | Unsigned | 1 | 0 | 0 | 255 | 0x00 | 0xFF | 130 | 130 | 当前已确认故障数量 | OnWrite | 130 | v1.0 Supported | Bsw/Com/Com.c + Bsw/Dem + Bsw/NvM | 1000ms；DTC/LastFaultId/自检/会话/NvM 状态一致 | v1.0 | 原代码仅 4 类摘要 -> 完整 14 信号
0x326 | StandardCAN | 0 | Tx | ICM | CGW/Tester | ICM_DiagStatus_1000ms | DIAG/SIGNAL | 8 | Cyclic/Event | 1000 | 0 | LastFaultId | Normal Signal | 130 | 1 | 0 | 16 | Intel LSB | Unsigned | 1 | 0 | 0 | 65535 | 0xFFFF | 0xFFFF | 130 | 130 | 最近一次本地 Dem 事件接口 ID；不是 24-bit UDS DTC | OnWrite | 130 | v1.0 Supported | Bsw/Com/Com.c + Bsw/Dem + Bsw/NvM | 1000ms；DTC/LastFaultId/自检/会话/NvM 状态一致 | v1.0 | 原代码仅 4 类摘要 -> 完整 14 信号
0x326 | StandardCAN | 0 | Tx | ICM | CGW/Tester | ICM_DiagStatus_1000ms | DIAG/SIGNAL | 8 | Cyclic/Event | 1000 | 0 | PowerOnCount | Normal Signal | 130 | 3 | 0 | 16 | Intel LSB | Unsigned | 1 | 0 | 0 | 65535 | 0x0000 | 0xFFFF | count | 130 | 上电次数，来自 NvM | OnWrite | 130 | v1.0 Supported | Bsw/Com/Com.c + Bsw/Dem + Bsw/NvM | 1000ms；DTC/LastFaultId/自检/会话/NvM 状态一致 | v1.0 | 原代码仅 4 类摘要 -> 完整 14 信号
0x326 | StandardCAN | 0 | Tx | ICM | CGW/Tester | ICM_DiagStatus_1000ms | DIAG/SIGNAL | 8 | Cyclic/Event | 1000 | 0 | SdramStatus | Normal Signal | 130 | 5 | 0 | 1 | Intel LSB | Unsigned | 1 | 0 | 0 | 1 | 0x0 | 0x0 | 130 | 0x0: Failed; 0x1: Passed | SDRAM 自检状态 | OnWrite | 130 | v1.0 Supported | Bsw/Com/Com.c + Bsw/Dem + Bsw/NvM | 1000ms；DTC/LastFaultId/自检/会话/NvM 状态一致 | v1.0 | 原代码仅 4 类摘要 -> 完整 14 信号
0x326 | StandardCAN | 0 | Tx | ICM | CGW/Tester | ICM_DiagStatus_1000ms | DIAG/SIGNAL | 8 | Cyclic/Event | 1000 | 0 | LcdStatus | Normal Signal | 130 | 5 | 1 | 1 | Intel LSB | Unsigned | 1 | 0 | 0 | 1 | 0x0 | 0x0 | 130 | 0x0: Failed; 0x1: Passed | LCD 初始化状态 | OnWrite | 130 | v1.0 Supported | Bsw/Com/Com.c + Bsw/Dem + Bsw/NvM | 1000ms；DTC/LastFaultId/自检/会话/NvM 状态一致 | v1.0 | 原代码仅 4 类摘要 -> 完整 14 信号
0x326 | StandardCAN | 0 | Tx | ICM | CGW/Tester | ICM_DiagStatus_1000ms | DIAG/SIGNAL | 8 | Cyclic/Event | 1000 | 0 | RtcStatus | Normal Signal | 130 | 5 | 2 | 1 | Intel LSB | Unsigned | 1 | 0 | 0 | 1 | 0x0 | 0x0 | 130 | 0x0: Failed; 0x1: Passed | RTC 通信状态 | OnWrite | 130 | v1.0 Supported | Bsw/Com/Com.c + Bsw/Dem + Bsw/NvM | 1000ms；DTC/LastFaultId/自检/会话/NvM 状态一致 | v1.0 | 原代码仅 4 类摘要 -> 完整 14 信号
0x326 | StandardCAN | 0 | Tx | ICM | CGW/Tester | ICM_DiagStatus_1000ms | DIAG/SIGNAL | 8 | Cyclic/Event | 1000 | 0 | EepromStatus | Normal Signal | 130 | 5 | 3 | 1 | Intel LSB | Unsigned | 1 | 0 | 0 | 1 | 0x0 | 0x0 | 130 | 0x0: Failed; 0x1: Passed | EEPROM/NvM 状态 | OnWrite | 130 | v1.0 Supported | Bsw/Com/Com.c + Bsw/Dem + Bsw/NvM | 1000ms；DTC/LastFaultId/自检/会话/NvM 状态一致 | v1.0 | 原代码仅 4 类摘要 -> 完整 14 信号
0x326 | StandardCAN | 0 | Tx | ICM | CGW/Tester | ICM_DiagStatus_1000ms | DIAG/SIGNAL | 8 | Cyclic/Event | 1000 | 0 | TfCardStatus | Normal Signal | 130 | 5 | 4 | 1 | Intel LSB | Unsigned | 1 | 0 | 0 | 1 | 0x0 | 0x0 | 130 | 0x0: Failed; 0x1: Passed | TF/FATFS 状态 | OnWrite | 130 | v1.0 Supported | Bsw/Com/Com.c + Bsw/Dem + Bsw/NvM | 1000ms；DTC/LastFaultId/自检/会话/NvM 状态一致 | v1.0 | 原代码仅 4 类摘要 -> 完整 14 信号
0x326 | StandardCAN | 0 | Tx | ICM | CGW/Tester | ICM_DiagStatus_1000ms | DIAG/SIGNAL | 8 | Cyclic/Event | 1000 | 0 | CanBusOffCounter | Normal Signal | 130 | 6 | 0 | 8 | Intel LSB | Unsigned | 1 | 0 | 0 | 255 | 0x00 | 0xFF | count | 130 | CAN Bus-Off 计数 | OnWrite | 130 | v1.0 Supported | Bsw/Com/Com.c + Bsw/Dem + Bsw/NvM | 1000ms；DTC/LastFaultId/自检/会话/NvM 状态一致 | v1.0 | 原代码仅 4 类摘要 -> 完整 14 信号
0x326 | StandardCAN | 0 | Tx | ICM | CGW/Tester | ICM_DiagStatus_1000ms | DIAG/SIGNAL | 8 | Cyclic/Event | 1000 | 0 | ResetReason | Normal Signal | 130 | 7 | 0 | 4 | Intel LSB | Unsigned | 1 | 0 | 0 | 15 | 0x0 | 0xF | 130 | 0x0: POR; 0x1: NRST; 0x2: IWDG; 0x3: Software; 0x4: BrownOut | 最近一次复位原因 | OnWrite | 130 | v1.0 Supported | Bsw/Com/Com.c + Bsw/Dem + Bsw/NvM | 1000ms；DTC/LastFaultId/自检/会话/NvM 状态一致 | v1.0 | 原代码仅 4 类摘要 -> 完整 14 信号
0x326 | StandardCAN | 0 | Tx | ICM | CGW/Tester | ICM_DiagStatus_1000ms | DIAG/SIGNAL | 8 | Cyclic/Event | 1000 | 0 | CanStatus | Normal Signal | — | 5 | 5 | 1 | Intel LSB | Unsigned | 1 | 0 | 0 | 1 | 0x0 | 0x0 | — | 0x0: Offline/Fault; 0x1: Online | CAN 当前可通信状态 | OnWrite |  | v1.0 Supported | Bsw/Com/Com.c + Bsw/Dem + Bsw/NvM | 1000ms；DTC/LastFaultId/自检/会话/NvM 状态一致 | v1.0 | 原代码仅 4 类摘要 -> 完整 14 信号
0x326 | StandardCAN | 0 | Tx | ICM | CGW/Tester | ICM_DiagStatus_1000ms | DIAG/SIGNAL | 8 | Cyclic/Event | 1000 | 0 | DiagnosticSession | Normal Signal | — | 7 | 4 | 2 | Intel LSB | Unsigned | 1 | 0 | 0 | 3 | 0x0 | 0x3 | — | 0:Default; 1:Programming; 2:Extended; 3:Invalid | 本地 Dcm 当前会话摘要 | OnWrite |  | v1.0 Supported | Bsw/Com/Com.c + Bsw/Dem + Bsw/NvM | 1000ms；DTC/LastFaultId/自检/会话/NvM 状态一致 | v1.0 | 原代码仅 4 类摘要 -> 完整 14 信号
0x326 | StandardCAN | 0 | Tx | ICM | CGW/Tester | ICM_DiagStatus_1000ms | DIAG/SIGNAL | 8 | Cyclic/Event | 1000 | 0 | NvMDirty | Normal Signal | — | 7 | 6 | 1 | Intel LSB | Unsigned | 1 | 0 | 0 | 1 | 0x0 | 0x0 | — | 0:Clean; 1:Pending persist | 存在待持久化诊断数据 | OnWrite |  | v1.0 Supported | Bsw/Com/Com.c + Bsw/Dem + Bsw/NvM | 1000ms；DTC/LastFaultId/自检/会话/NvM 状态一致 | v1.0 | 原代码仅 4 类摘要 -> 完整 14 信号
0x326 | StandardCAN | 0 | Tx | ICM | CGW/Tester | ICM_DiagStatus_1000ms | DIAG/SIGNAL | 8 | Cyclic/Event | 1000 | 0 | SelfTestPassed | Normal Signal | — | 7 | 7 | 1 | Intel LSB | Unsigned | 1 | 0 | 0 | 1 | 0x0 | 0x0 | — | 0:Not passed; 1:Passed | 本机关键自检汇总状态 | OnWrite |  | v1.0 Supported | Bsw/Com/Com.c + Bsw/Dem + Bsw/NvM | 1000ms；DTC/LastFaultId/自检/会话/NvM 状态一致 | v1.0 | 原代码仅 4 类摘要 -> 完整 14 信号
0x327 | StandardCAN | 0 | Tx | ICM | CGW/Tester | ICM_UserInput_Event | SIGNAL | 8 | Event | 0 | 0 | KeyCode | Normal Signal | 130 | 0 | 0 | 8 | Intel LSB | Unsigned | 1 | 0 | 0 | 255 | 0x00 | 0xFF | 130 | 0x0: None; 0x1: KEY1; 0x2: KEY2; 0x3: KEY3; 0x4: KEY_POWER | 按键编号 | OnChange | 130 | v1.0 Supported | Bsw/Com/Com.c + Rte/Rte_Event.* | 成功交付 CanIf 后清事件；失败保留重试；Counter 自然回卷 | v1.0 | 发送前消费事件 -> 成功后消费
0x327 | StandardCAN | 0 | Tx | ICM | CGW/Tester | ICM_UserInput_Event | SIGNAL | 8 | Event | 0 | 0 | KeyAction | Normal Signal | 130 | 1 | 0 | 4 | Intel LSB | Unsigned | 1 | 0 | 0 | 15 | 0x0 | 0xF | 130 | 0x0: None; 0x1: ShortPress; 0x2: LongPress; 0x3: DoubleClick | 按键动作 | OnChange | 130 | v1.0 Supported | Bsw/Com/Com.c + Rte/Rte_Event.* | 成功交付 CanIf 后清事件；失败保留重试；Counter 自然回卷 | v1.0 | 发送前消费事件 -> 成功后消费
0x327 | StandardCAN | 0 | Tx | ICM | CGW/Tester | ICM_UserInput_Event | SIGNAL | 8 | Event | 0 | 0 | EventCounter | Normal Signal | 130 | 2 | 0 | 8 | Intel LSB | Unsigned | 1 | 0 | 0 | 255 | 0x00 | 0xFF | count | 130 | 事件计数器，防止接收端漏事件 | OnChange | 130 | v1.0 Supported | Bsw/Com/Com.c + Rte/Rte_Event.* | 成功交付 CanIf 后清事件；失败保留重试；Counter 自然回卷 | v1.0 | 发送前消费事件 -> 成功后消费
0x327 | StandardCAN | 0 | Tx | ICM | CGW/Tester | ICM_UserInput_Event | SIGNAL | 8 | Event | 0 | 0 | PowerKeyLongPress | Normal Signal | 130 | 3 | 0 | 1 | Intel LSB | Unsigned | 1 | 0 | 0 | 1 | 0x0 | 0x0 | 130 | 0x0: No; 0x1: Yes | 电源键长按标志 | OnChange | 130 | v1.0 Supported | Bsw/Com/Com.c + Rte/Rte_Event.* | 成功交付 CanIf 后清事件；失败保留重试；Counter 自然回卷 | v1.0 | 发送前消费事件 -> 成功后消费
0x327 | StandardCAN | 0 | Tx | ICM | CGW/Tester | ICM_UserInput_Event | SIGNAL | 8 | Event | 0 | 0 | ShutdownConfirm | Normal Signal | 130 | 3 | 1 | 1 | Intel LSB | Unsigned | 1 | 0 | 0 | 1 | 0x0 | 0x0 | 130 | 0x0: No; 0x1: Yes | 用户确认关机 | OnChange | 130 | v1.0 Supported | Bsw/Com/Com.c + Rte/Rte_Event.* | 成功交付 CanIf 后清事件；失败保留重试；Counter 自然回卷 | v1.0 | 发送前消费事件 -> 成功后消费
0x327 | StandardCAN | 0 | Tx | ICM | CGW/Tester | ICM_UserInput_Event | SIGNAL | 8 | Event | 0 | 0 | KeyEventReserved | Normal Signal | 130 | 4 | 0 | 32 | Intel LSB | Unsigned | 1 | 0 | 0 | 0 | 0x00000000 | 0xFFFFFFFF | 130 | 130 | 预留 | OnChange | 130 | v1.0 Supported | Bsw/Com/Com.c + Rte/Rte_Event.* | 成功交付 CanIf 后清事件；失败保留重试；Counter 自然回卷 | v1.0 | 发送前消费事件 -> 成功后消费
0x328 | StandardCAN | 0 | Tx | ICM | CGW/Tester | ICM_LogStatus_1000ms | SIGNAL | 8 | Cyclic/Event | 1000 | 0 | SdCardStatus | Normal Signal | 130 | 0 | 0 | 2 | Intel LSB | Unsigned | 1 | 0 | 0 | 3 | 0x0 | 0x3 | 130 | 0x0: NotMounted; 0x1: Mounted; 0x2: Error; 0x3: Reserved | TF 卡挂载状态 | OnWrite | 130 | Stub/Declared | Bsw/Com/Com.c + App/App_Logger | 未接 FatFs 时必须发送未挂载/Stub，文件号 0 | v1.0 | 教学桩保留，但状态显式化；真实文件日志 Planned
0x328 | StandardCAN | 0 | Tx | ICM | CGW/Tester | ICM_LogStatus_1000ms | SIGNAL | 8 | Cyclic/Event | 1000 | 0 | LogEnable | Normal Signal | 130 | 0 | 2 | 1 | Intel LSB | Unsigned | 1 | 0 | 0 | 1 | 0x0 | 0x0 | 130 | 0x0: Disable; 0x1: Enable | 日志记录使能 | OnWrite | 130 | Stub/Declared | Bsw/Com/Com.c + App/App_Logger | 未接 FatFs 时必须发送未挂载/Stub，文件号 0 | v1.0 | 教学桩保留，但状态显式化；真实文件日志 Planned
0x328 | StandardCAN | 0 | Tx | ICM | CGW/Tester | ICM_LogStatus_1000ms | SIGNAL | 8 | Cyclic/Event | 1000 | 0 | CurrentLogFileIndex | Normal Signal | 130 | 1 | 0 | 16 | Intel LSB | Unsigned | 1 | 0 | 0 | 65535 | 0x0000 | 0xFFFF | 130 | 130 | 当前日志文件编号 | OnWrite | 130 | Stub/Declared | Bsw/Com/Com.c + App/App_Logger | 未接 FatFs 时必须发送未挂载/Stub，文件号 0 | v1.0 | 教学桩保留，但状态显式化；真实文件日志 Planned
0x328 | StandardCAN | 0 | Tx | ICM | CGW/Tester | ICM_LogStatus_1000ms | SIGNAL | 8 | Cyclic/Event | 1000 | 0 | LogWriteErrorCounter | Normal Signal | 130 | 3 | 0 | 8 | Intel LSB | Unsigned | 1 | 0 | 0 | 255 | 0x00 | 0xFF | count | 130 | 日志写入错误计数 | OnWrite | 130 | Stub/Declared | Bsw/Com/Com.c + App/App_Logger | 未接 FatFs 时必须发送未挂载/Stub，文件号 0 | v1.0 | 教学桩保留，但状态显式化；真实文件日志 Planned
0x328 | StandardCAN | 0 | Tx | ICM | CGW/Tester | ICM_LogStatus_1000ms | SIGNAL | 8 | Cyclic/Event | 1000 | 0 | RuntimeSeconds | Normal Signal | 130 | 4 | 0 | 32 | Intel LSB | Unsigned | 1 | 0 | 0 | 4294967295 | 0x00000000 | 0xFFFFFFFF | s | 130 | 系统运行秒数 | OnWrite | 130 | Stub/Declared | Bsw/Com/Com.c + App/App_Logger | 未接 FatFs 时必须发送未挂载/Stub，文件号 0 | v1.0 | 教学桩保留，但状态显式化；真实文件日志 Planned
0x329 | StandardCAN | 0 | Rx | S32K144/CDM | ICM | CDM_Status_500ms | SIGNAL | 8 | Cyclic | 500 | 0 | InterfaceVersion | Normal Signal | — | 0 | 0 | 8 | Intel LSB | Unsigned | 1 | 0 | 0 | 255 | 0x10 | 0xFF | — | 0x10: Interface v1.0 | 控制域应用接口版本 | OnWrite |  | v1.0 Supported | Bsw/Com/Com.c + Rte/Rte_Signal.* | Version=0x10；AliveCounter；CRC8/J1850(ID+B0..B6)；1500ms timeout | v1.0 | As-Built 不存在 -> 新增控制域聚合状态
0x329 | StandardCAN | 0 | Rx | S32K144/CDM | ICM | CDM_Status_500ms | SIGNAL | 8 | Cyclic | 500 | 0 | InputMode | Normal Signal | — | 1 | 0 | 2 | Intel LSB | Unsigned | 1 | 0 | 0 | 3 | 0x0 | 0x3 | — | 0:SIM; 1:ADC; 2:FIX; 3:Invalid | 控制域输入源模式 | OnWrite |  | v1.0 Supported | Bsw/Com/Com.c + Rte/Rte_Signal.* | Version=0x10；AliveCounter；CRC8/J1850(ID+B0..B6)；1500ms timeout | v1.0 | As-Built 不存在 -> 新增控制域聚合状态
0x329 | StandardCAN | 0 | Rx | S32K144/CDM | ICM | CDM_Status_500ms | SIGNAL | 8 | Cyclic | 500 | 0 | PowerMode | Normal Signal | — | 1 | 2 | 3 | Intel LSB | Unsigned | 1 | 0 | 0 | 7 | 0x0 | 0x7 | — | 0:OFF; 1:ACC; 2:RUN; 3:START; 7:Invalid | 控制域电源模式 | OnWrite |  | v1.0 Supported | Bsw/Com/Com.c + Rte/Rte_Signal.* | Version=0x10；AliveCounter；CRC8/J1850(ID+B0..B6)；1500ms timeout | v1.0 | As-Built 不存在 -> 新增控制域聚合状态
0x329 | StandardCAN | 0 | Rx | S32K144/CDM | ICM | CDM_Status_500ms | SIGNAL | 8 | Cyclic | 500 | 0 | HealthState | Normal Signal | — | 1 | 5 | 2 | Intel LSB | Unsigned | 1 | 0 | 0 | 3 | 0x0 | 0x3 | — | 0:OK; 1:DEGRADED; 2:FAULT; 3:Invalid | 控制域聚合健康状态 | OnWrite |  | v1.0 Supported | Bsw/Com/Com.c + Rte/Rte_Signal.* | Version=0x10；AliveCounter；CRC8/J1850(ID+B0..B6)；1500ms timeout | v1.0 | As-Built 不存在 -> 新增控制域聚合状态
0x329 | StandardCAN | 0 | Rx | S32K144/CDM | ICM | CDM_Status_500ms | SIGNAL | 8 | Cyclic | 500 | 0 | RemoteFaultPresent | Normal Signal | — | 1 | 7 | 1 | Intel LSB | Unsigned | 1 | 0 | 0 | 1 | 0x0 | 0x0 | — | 0:No; 1:Active remote fault | 控制域存在活动故障 | OnWrite |  | v1.0 Supported | Bsw/Com/Com.c + Rte/Rte_Signal.* | Version=0x10；AliveCounter；CRC8/J1850(ID+B0..B6)；1500ms timeout | v1.0 | As-Built 不存在 -> 新增控制域聚合状态
0x329 | StandardCAN | 0 | Rx | S32K144/CDM | ICM | CDM_Status_500ms | SIGNAL | 8 | Cyclic | 500 | 0 | RemoteDtcCount | Normal Signal | — | 2 | 0 | 8 | Intel LSB | Unsigned | 1 | 0 | 0 | 254 | 0x00 | 0xFF | count | — | 控制域活动故障数量 | OnWrite |  | v1.0 Supported | Bsw/Com/Com.c + Rte/Rte_Signal.* | Version=0x10；AliveCounter；CRC8/J1850(ID+B0..B6)；1500ms timeout | v1.0 | As-Built 不存在 -> 新增控制域聚合状态
0x329 | StandardCAN | 0 | Rx | S32K144/CDM | ICM | CDM_Status_500ms | SIGNAL | 8 | Cyclic | 500 | 0 | DomainStatusFlags | Normal Signal | — | 3 | 0 | 8 | Intel LSB | Unsigned | 1 | 0 | 0 | 255 | 0x00 | — | — | b0 CAN1; b1 CAN2; b2 LIN1; b3 LIN2; b4 ADC; b5 KeyOverride; b6 SelfTest | 控制域总线、输入和自检状态位 | OnWrite |  | v1.0 Supported | Bsw/Com/Com.c + Rte/Rte_Signal.* | Version=0x10；AliveCounter；CRC8/J1850(ID+B0..B6)；1500ms timeout | v1.0 | As-Built 不存在 -> 新增控制域聚合状态
0x329 | StandardCAN | 0 | Rx | S32K144/CDM | ICM | CDM_Status_500ms | SIGNAL | 8 | Cyclic | 500 | 0 | LastRemoteFaultId | Normal Signal | — | 4 | 0 | 16 | Intel LSB | Unsigned | 1 | 0 | 0 | 65535 | 0xFFFF | 0xFFFF | — | — | 最近控制域故障接口 ID；不是 24-bit UDS DTC | OnWrite |  | v1.0 Supported | Bsw/Com/Com.c + Rte/Rte_Signal.* | Version=0x10；AliveCounter；CRC8/J1850(ID+B0..B6)；1500ms timeout | v1.0 | As-Built 不存在 -> 新增控制域聚合状态
0x329 | StandardCAN | 0 | Rx | S32K144/CDM | ICM | CDM_Status_500ms | SIGNAL | 8 | Cyclic | 500 | 0 | AliveCounter | Normal Signal | — | 6 | 0 | 8 | Intel LSB | Unsigned | 1 | 0 | 0 | 255 | 0x00 | — | — | — | 每个成功发布周期加 1，自然回卷 | OnWrite |  | v1.0 Supported | Bsw/Com/Com.c + Rte/Rte_Signal.* | Version=0x10；AliveCounter；CRC8/J1850(ID+B0..B6)；1500ms timeout | v1.0 | As-Built 不存在 -> 新增控制域聚合状态
0x329 | StandardCAN | 0 | Rx | S32K144/CDM | ICM | CDM_Status_500ms | SIGNAL | 8 | Cyclic | 500 | 0 | CRC8_J1850 | Normal Signal | — | 7 | 0 | 8 | Intel LSB | Unsigned | 1 | 0 | 0 | 255 | 0x00 | — | — | poly=0x1D init=0xFF xorout=0xFF; data=29 03 + B0..B6 | 控制域状态端到端校验 | OnWrite |  | v1.0 Supported | Bsw/Com/Com.c + Rte/Rte_Signal.* | Version=0x10；AliveCounter；CRC8/J1850(ID+B0..B6)；1500ms timeout | v1.0 | As-Built 不存在 -> 新增控制域聚合状态

Sheet: Convert
CAN 信号物理值换算示例
Signal Name | Raw(hex/dec) | Raw(dec) | Resolution | Offset | Physical Formula | Physical Value | Unit | Remark
VehicleSpeed | 0x0640 | 1600 | 0.0625 | 0 | 100 | 100.000 | km/h | 1600 × 0.0625 = 100 km/h
EngineSpeed | 0x2EE0 | 12000 | 0.25 | 0 | 3000 | 3000.000 | rpm | 12000 × 0.25 = 3000 rpm
FuelPercent | 0xC8 | 200 | 0.4 | 0 | 80 | 80.000 | % | 200 × 0.4 = 80%
EngineCoolantTemperature | 0x5A | 90 | 1 | -40 | 50 | 50.000 | ℃ | 90 - 40 = 50℃
LF_TirePressure | 0x64 | 100 | 0.0275 | 0 | 2.75 | 2.750 | Bar | 100 × 0.0275 = 2.75 bar
TripDistance | 0x04D2 | 1234 | 0.1 | 0 | 123.4 | 123.400 | km | 123.4 km

Sheet: CheckResult
检查项 | 结果 | 说明 | 责任模块 | 优先级
所有报文 Msg ID 是否唯一 | PASS | 当前 13 个报文 ID 未重复 | Com/CanIf | P0
所有报文 DLC 是否为 8 | PASS | 当前按 Classic CAN 8 字节设计 | CanIf | P0
信号是否越过 8 字节边界 | 待代码生成时复核 | 64bit 诊断数据占满 8 字节；其他信号按字节分配 | Com | P0
RX 报文是否可由 USB-CAN 模拟 | PASS | 0x321~0x324、0x441、0x700、0x7DF 可外部发送 | 测试 | P0
TX 报文是否有软件触发源 | PASS | 0x325~0x328、0x440、0x708 由 ICM APP/BSW/Diag 生成 | APP/RTE/BSW | P1
诊断是否完整符合 UDS | NO | 本版只做教学级 UDS 子集，不声明 AUTOSAR/UDS 正式合规 | Dcm/CanTp | P2
是否需要 DBC 导出 | TODO | 后续可根据 Matrix 生成 .dbc，用于 CANoe/CANalyzer/USB-CAN 上位机 | 工具链 | P2

Sheet: RevisionRecords
Revision Records / 版本记录
本页记录 CAN 接口正式定版历史；任何信号布局变化必须升级接口版本并由收发双方共同评审。
Version | Date | Author | Change Description | Review Status | Remark
v1.0 | 2026-07-29 | Codex / 项目组 | 完成 As-Built 审计；新增 0x329；补充实现状态、源码模块、验证规则、接口版本和差异字段；定版超时/CRC/AliveCounter。 | Released | 原始 Excel 保留不覆盖
