WHH3844/CAR_DASHBOARD/Docs/架构落地调试记录.md

# CAR_DASHBOARD 架构落地调试记录

## 2026-06-03：从板级测试工程切到正式架构工程

### 背景

PCB 第一轮硬件 bring-up 已完成，`12_dashboard_demo` 已验证：

- 电源自锁、长按关机、UART 下载调试正常
- SDRAM 初始化参数可稳定支撑 LCD framebuffer
- 800x480 RGB LCD 使用 TLI + SDRAM framebuffer 显示正常
- CAN1 500K 与 PCAN-View 收发正常
- I2C0 上 EEPROM、RTC、SHT30 地址和功能正常
- TF 卡 SDIO 只读识别正常
- KEY1/KEY2/KEY3 和蜂鸣器正常

因此本轮目标不再是继续写单独测试程序，而是把已验证的外设能力沉淀到 Mini AUTOSAR-like 分层架构。

### 本轮完成内容

1. 公共配置和基础类型：新增 `Std_Types.h`，补齐 CAN、Com、Dcm、Dem、NvM、RTE、APP 配置。
2. BSW 通信链路：实现 `CanIf`、`CanTrcv`、`PduR`、`CanTp`、`Com`。
3. RTE 信号层：建立车速、转速、电压、RTC、SHT30、按键、蜂鸣器和 CAN 有效性信号。
4. 诊断和故障管理：`Dcm` 支持 `0x10/0x22/0x19/0x14/0x3E`，`Dem` 支持 20 个 DTC 的最小状态管理。
5. NvM：使用 FT24C16A 保存启动次数、系统配置和 Dem 状态，增加 CRC16。
6. APP：实现按键、传感器、仪表业务、LCD 局部刷新、软关机前保存 NvM。
7. EcuM / Os：`main.c` 改为干净入口，`Os` 已接入 FreeRTOS，并保留裸机 super loop 回退模式。

### 关键调试经验

- LCD 花屏根因不是引脚，而是 SDRAM 参数不适合 TLI 连续读取；正式架构保留已验证的 EXMC 参数。
- 显示层只做局部刷新，避免 500ms 内频繁整屏清 framebuffer。
- CAN 诊断目前只做单帧，长 DID、DTC 快照、多帧刷写留给 CanTp 第二阶段。
- EEPROM 写入通过 NvM 延迟写，避免业务逻辑直接高频写 FT24C16A。
- FreeRTOS 先放在 Os 层。2026-06-03 先用单 `EcuM` 主任务承载原 10ms 调度，确认 RTOS 移植稳定后，2026-06-04 再拆分成多个任务。

### 当时验证风险

- FreeRTOS 已加入 Keil 工程并完成命令行构建，日志显示 `0 Error(s), 0 Warning(s)`。
- `APP_CFG_USE_FREERTOS` 默认是 `1u`；若板上排查 RTOS tick、任务栈或中断优先级问题，可临时改为 `0u` 回退裸机。
- 下一步风险从“能否编过”变为“板上能否稳定运行 2 小时以上”，重点观察 LCD 花屏、CAN 丢帧、I2C 超时和 NvM 写入节奏。

## 2026-06-03：FreeRTOS 移植记录

### 为什么现在加入 FreeRTOS

前面 12 个板级测试和 `12_dashboard_demo` 已经证明主要硬件通路能跑通，因此可以把 RTOS 加进正式工程。这样项目完整度更高，也能在面试时说明自己知道裸机调度和 RTOS 调度的差异。

### 本次移植选择

- FreeRTOS 来源：`D:\MCU\FreeRTOSv202212.01\FreeRTOS\Source`
- MCU 内核：GD32F470 Cortex-M4F
- 端口目录：`portable/RVDS/ARM_CM4F`
- 堆管理：`portable/MemMang/heap_4.c`
- 工程内路径：`Os/FreeRTOS/Source`
- 配置文件：`Config/FreeRTOSConfig.h`

### 关键处理

1. 向 Keil 工程加入 `tasks.c`、`queue.c`、`list.c`、`timers.c`、`event_groups.c`、`stream_buffer.c`、`heap_4.c`、`port.c`。
2. 增加 FreeRTOS include 路径：`Source/include`、`portable/RVDS/ARM_CM4F`、`portable/MemMang`。
3. 在 `FreeRTOSConfig.h` 中把 `vPortSVCHandler`、`xPortPendSVHandler`、`xPortSysTickHandler` 映射到启动文件使用的 `SVC_Handler`、`PendSV_Handler`、`SysTick_Handler`。
4. `Os_Start()` 创建一个 `EcuM` 主任务，任务里使用 `vTaskDelayUntil()` 保持 10ms 周期。
5. `Os_DelayMs()` 在调度器启动前使用忙等，在调度器启动后自动切换为 `vTaskDelay()`。
6. 增加 `vApplicationMallocFailedHook()` 和 `vApplicationStackOverflowHook()`，出现堆不足或任务栈溢出时停机，便于调试定位。

### 编译结果

命令：

```powershell
D:\Keil5\UV4\UV4.exe -b D:\MCU\Project\car\CAR_DASHBOARD\Project\CAR_DASHBOARD.uvprojx -j0 -o D:\MCU\Project\car\CAR_DASHBOARD\Project\Objects\codex_freertos_build.log
```

结果：

```text
Program Size: Code=24556 RO-data=1020 RW-data=264 ZI-data=25920
".\Objects\CAR_DASHBOARD.axf" - 0 Error(s), 0 Warning(s).
```

Keil 日志中出现 `port.c` 目标文件从 `port.o` 改名为 `port_1.o`，原因是工程里已有 `Mcal/Port/Port.c`，两个文件名大小写接近，Keil 自动避让对象文件名。这不是错误。

## 2026-06-04：PCAN-VIEW 报文验证记录

### 现象

补齐 `0x327/0x328` 之前，PCAN-VIEW 中能看到 `0x321`、`0x325`、`0x326`、`0x440`，但没有看到矩阵里定义的 `0x322`、`0x323`、`0x324`、`0x327`、`0x328`。

### 结论

这不是 CAN 链路异常，而是报文方向和当前开发阶段不同：

- `0x321/0x322/0x323/0x324` 是外部 ECU 输入给仪表的报文，需要 PCAN 或其它节点主动发。
- `0x325/0x326` 是仪表当前已实现的输出状态报文，板子会周期发送。
- 当时代码中 `0x327/0x328` 还没有实现发送函数，因此 PCAN-VIEW 看不到是正常的；后续已在下一小节补齐。
- `0x440` 是当前代码额外发送的简化 NM 报文，用于确认仪表节点处于 RUN 状态。

### 本次验证点

1. PCAN 将 `0x321` 周期设置为 `500ms` 时，`0x325 Byte5` 可能仍为 `00`，原因是代码中的动力 CAN 超时阈值也是 `500ms`，调度抖动会触发边界超时。
2. PCAN 将 `0x321` 周期改为 `50ms` 后，`0x325 Byte5` 变为 `01`，说明动力 CAN 当前有效。
3. `0x326 Byte2` 同步变为 `01`，说明诊断状态帧也能正确反映动力 CAN 有效位。
4. `0x326 Byte0` 仍可能为 `01`，表示之前超时留下了 confirmed DTC；这是历史故障记录，不代表当前仍然故障，需要通过 UDS `0x14` 清除。

## 2026-06-04：补齐 0x323/0x324/0x327/0x328 报文开发

### 本次补齐内容

1. `0x323 TPMS_Status_1000ms` 不再只是占位，已解析四轮胎压和胎温，并写入 `Rte_TpmsData`。
2. `0x324 IHU_CGW_Config_500ms` 按矩阵解析 Byte0 主题/语言/单位制、Byte1 背光、Byte2 音量、Byte3-4 续航、Byte5-7 时间同步字段。
3. `App_Display` 增加运行期背光同步，PCAN 修改 `0x324 Byte1` 后不需要重启即可作用到 `BacklightIf`。
4. `0x327 ICM_UserInput_Event` 已实现。KEY1/KEY2/KEY3 通过去抖后，RTE 记录用户输入事件，Com 层发送一次事件帧。
5. `0x328 ICM_LogStatus_1000ms` 已实现。当前先上报 TF 卡未挂载、串口日志使能、无写错误和运行秒数。

### 保留的兼容点

`0x325/0x326` 暂时保持前面 PCAN 验证过的打包方式，不在本次改成矩阵中的完整字段定义。这样已经跑通的车速/转速/动力 CAN 有效位验证不被破坏。后续如果要完全贴合矩阵，可再单独调整 `Com_SendIcmStatus()` 和 `Com_SendDiagStatus()`。

### 后续开发项

- `Rte_TpmsData` 已接入 LCD 底部 TPMS 区域，后续可再增加胎温异常颜色提示。
- 可把 `0x324` 的主题、语言、单位制字段接到显示层。
- 可把 `0x328` 的 TF 卡状态、日志文件编号、写错误计数接到 FatFs 日志模块。

## 2026-06-04：FreeRTOS 拆分任务落地记录

### 为什么从单任务拆分

单 `EcuM` 主任务适合第一步验证 FreeRTOS 移植，因为它最大限度保留了裸机 super loop 的执行顺序。但当前工程已经进入正式架构演示阶段，需要能清楚表达“通信、应用、显示、传感器、存储、日志、生命周期”的职责边界，因此将调度拆成多个 FreeRTOS 任务。

### 当前任务划分

| 任务 | 周期 | 职责 | 关键说明 |
|---|---:|---|---|
| `CanTask` | 10ms | `CanIf/CanSM/Com/Dcm` | 通信栈仍串行运行，避免 CAN/诊断状态并发访问 |
| `AppFastTask` | 10ms | `App_Power/App_Key/App_Dashboard/App_Diag` | 处理按键、模拟模式、报警和关机请求 |
| `DisplayTask` | 500ms | `App_Display` | LCD 低频局部刷新，减少 framebuffer 抢带宽和闪烁 |
| `SensorTask` | 1000ms | `App_Sensor` | DS3231 和 SHT30 秒级刷新 |
| `NvMTask` | 100ms | `NvM/Dem` | 统一做非易失性状态维护和故障限频保存 |
| `LoggerTask` | 1000ms | `App_Logger` | 串口 heartbeat 和运行状态辅助观察 |
| `EcuM` | 10ms | 生命周期管理 | 集中处理关机、保存 NvM/Dem 和断电顺序 |

### 为拆分任务补的保护

- `Rte_Signal.c` 的全局信号读写用短临界区保护，只在临界区内做内存拷贝。
- I2C0 公共访问由 `Os_I2c0Lock()` / `Os_I2c0Unlock()` 串行化，避免 RTC、SHT30、EEPROM 抢总线。
- NvM/Dem 周期维护和关机保存由 `Os_NvMLock()` / `Os_NvMUnlock()` 保护，避免 EEPROM 写入与状态机维护交叠。
- `FreeRTOSConfig.h` 的 heap 调整为 32KB，为 7 个任务、mutex 和 TCB 留出余量。

### 当前版本结论

当前版本建议命名为 `v0.4.0-rtos-split-dashboard`。这个版本不是单纯“能编过”的架构模板，而是已经具备板级硬件闭环、Mini AUTOSAR-like 分层、CAN 业务矩阵、UDS/Dem/NvM、Dashboard UI 和 FreeRTOS 拆分任务的可演示版本。
