WHH3844/CAR_DASHBOARD/Docs/SCH_Schematic1_2026-07-26.pdf

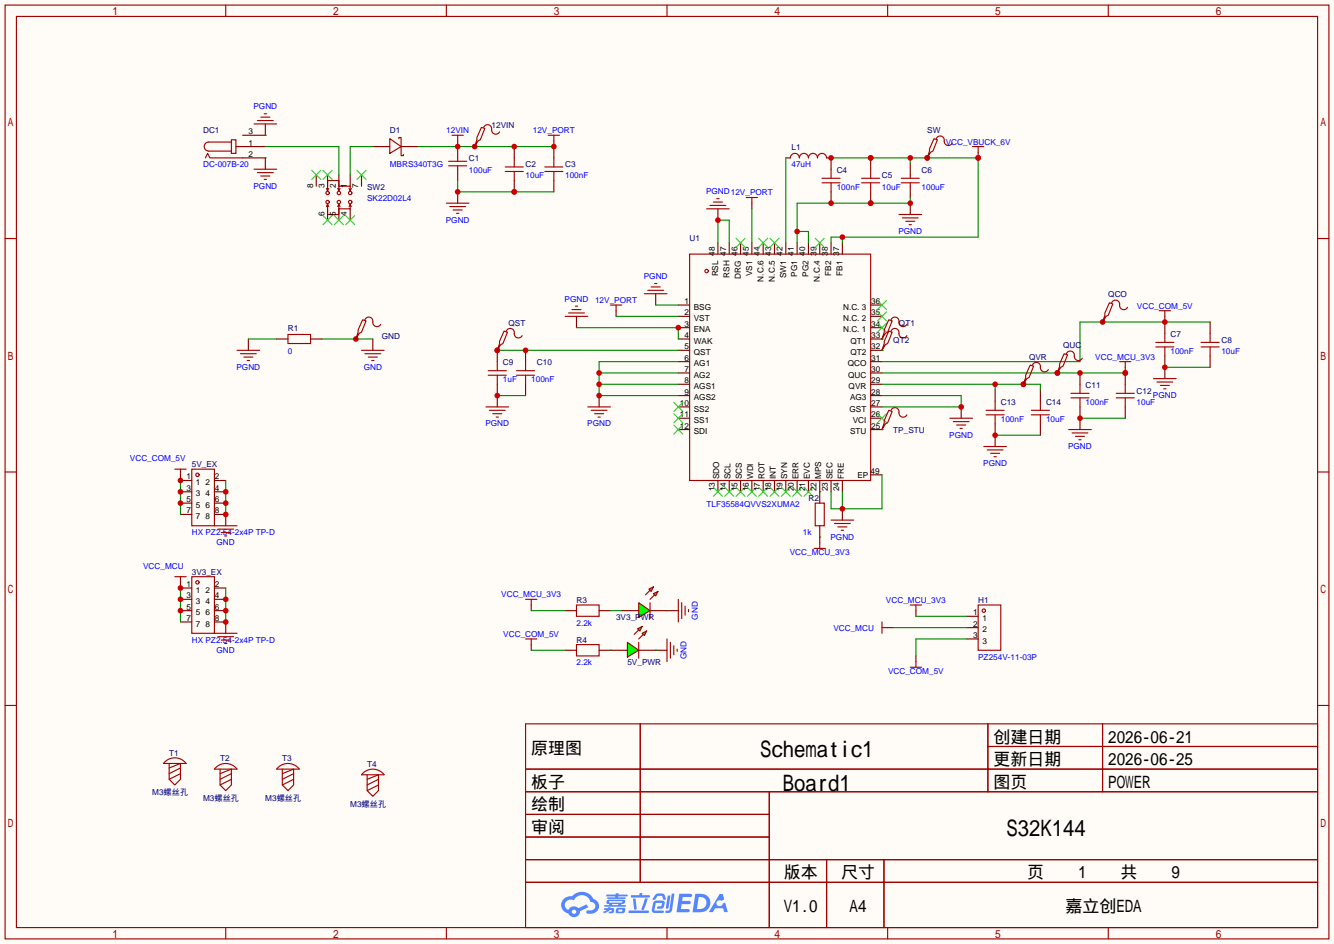
[picture p2: page 1]

PGND
STU 25 VCI 26 GST 27 AG3 28 QVR 29 QUC 30 QCO 31 QT2 32 QT1 33 N.C. 1 34 N.C. 2 35 N.C. 3 36

原理图 | Schematic1 | 创建日期 | 2026-06-21

更新日期 | 2026-06-25

板子 | Board1 | 图页 | POWER
绘制 | | S32K144
审阅

V1.0 | A4 | 嘉立创EDA

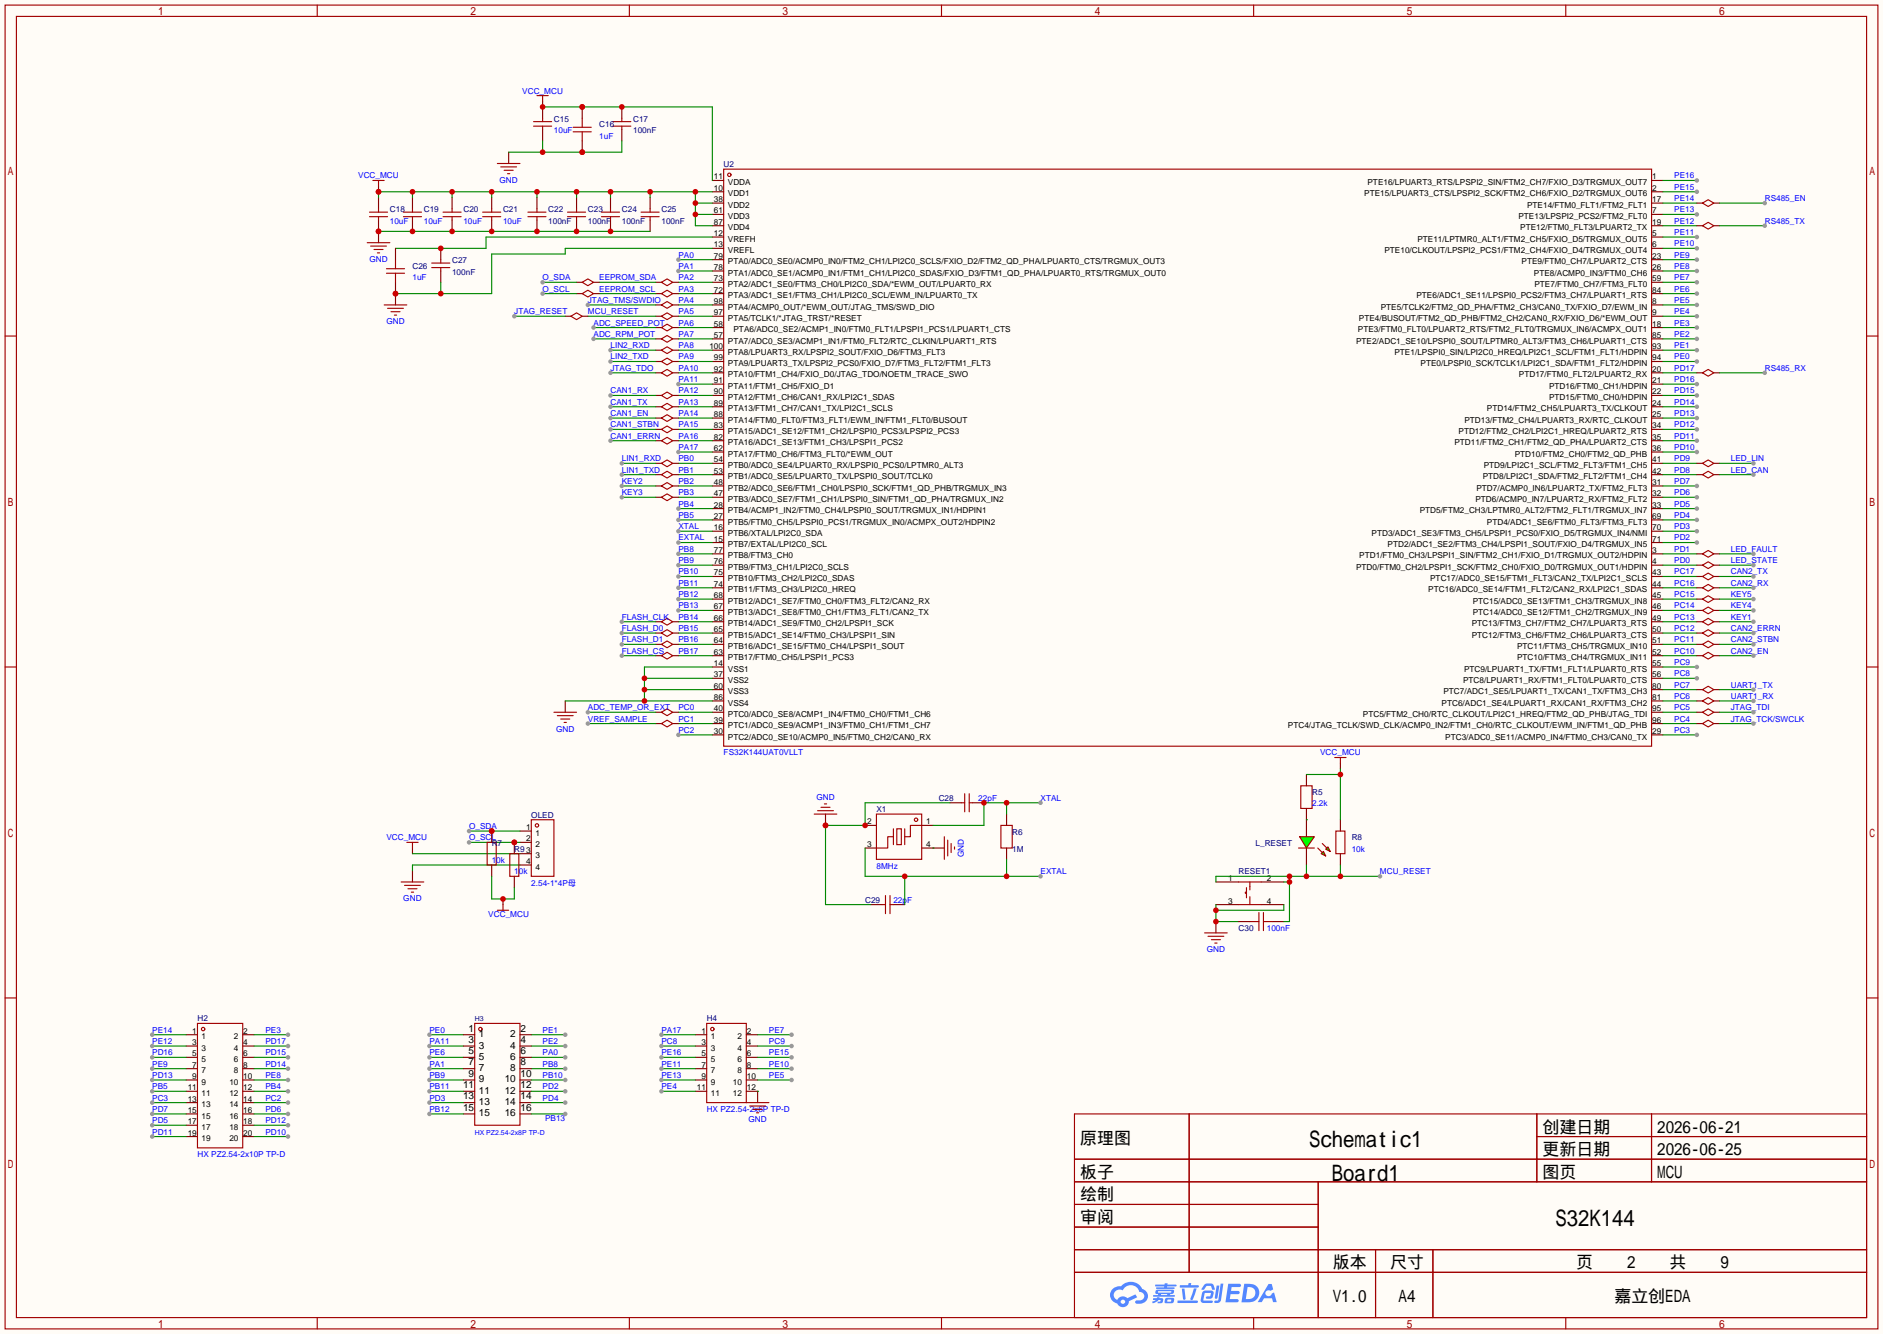
[picture p3: page 2]

原理图 | Schematic1 | 创建日期 | 2026-06-21

更新日期 | 2026-06-25

板子 | Board1 | 图页 | MCU
绘制 | | S32K144
审阅

# VCC_MCU GND

# DSR# 10 RI# 11 DCD# 12 DTR# 13 RTS# 14 R232 15 VCC 16

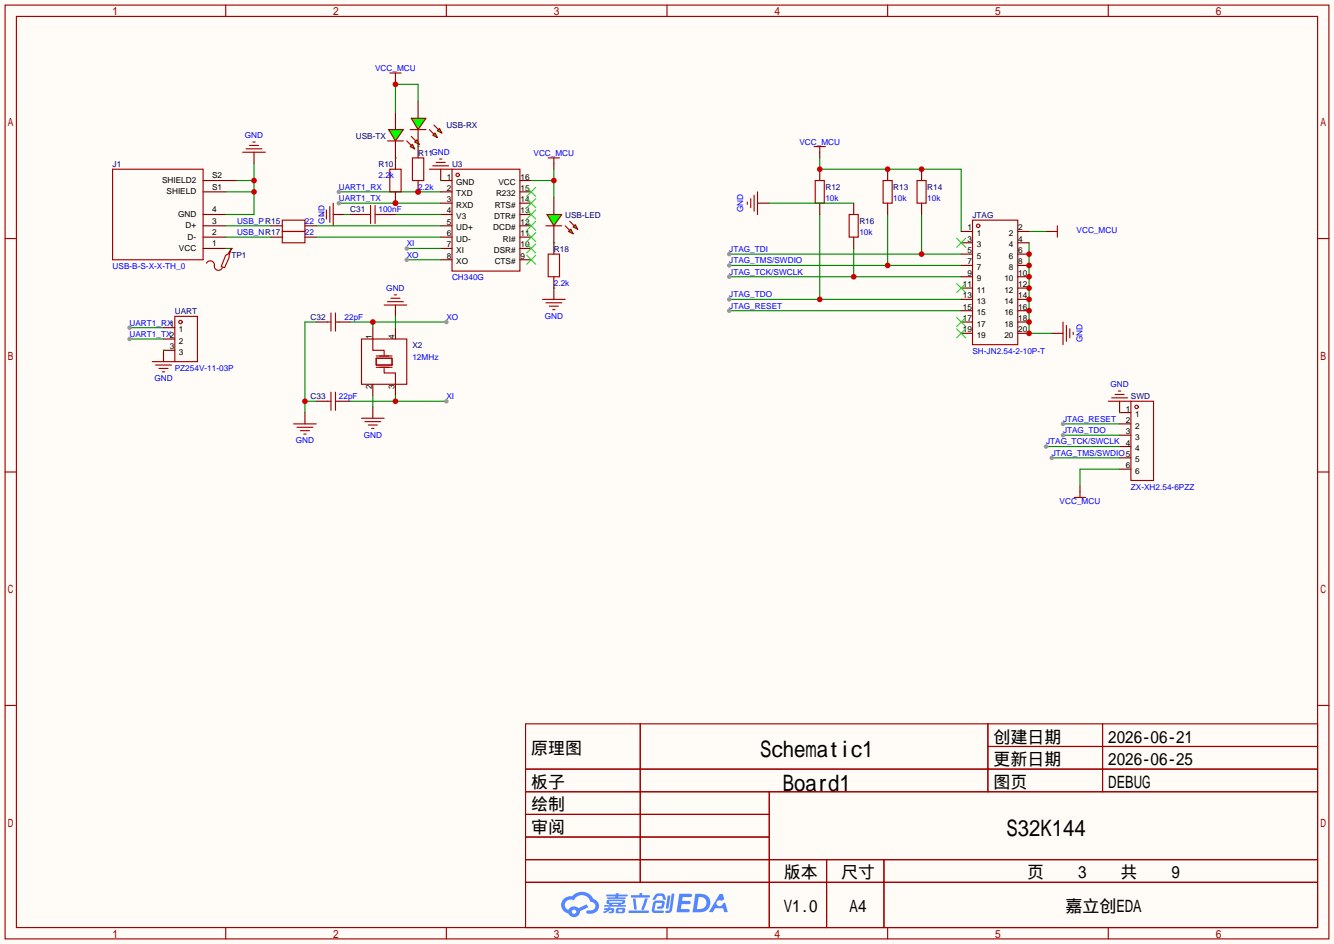
[picture p4: page 3]

原理图 | Schematic1 | 创建日期 | 2026-06-21

更新日期 | 2026-06-25

板子 | Board1 | 图页 | DEBUG
绘制 | | S32K144
审阅

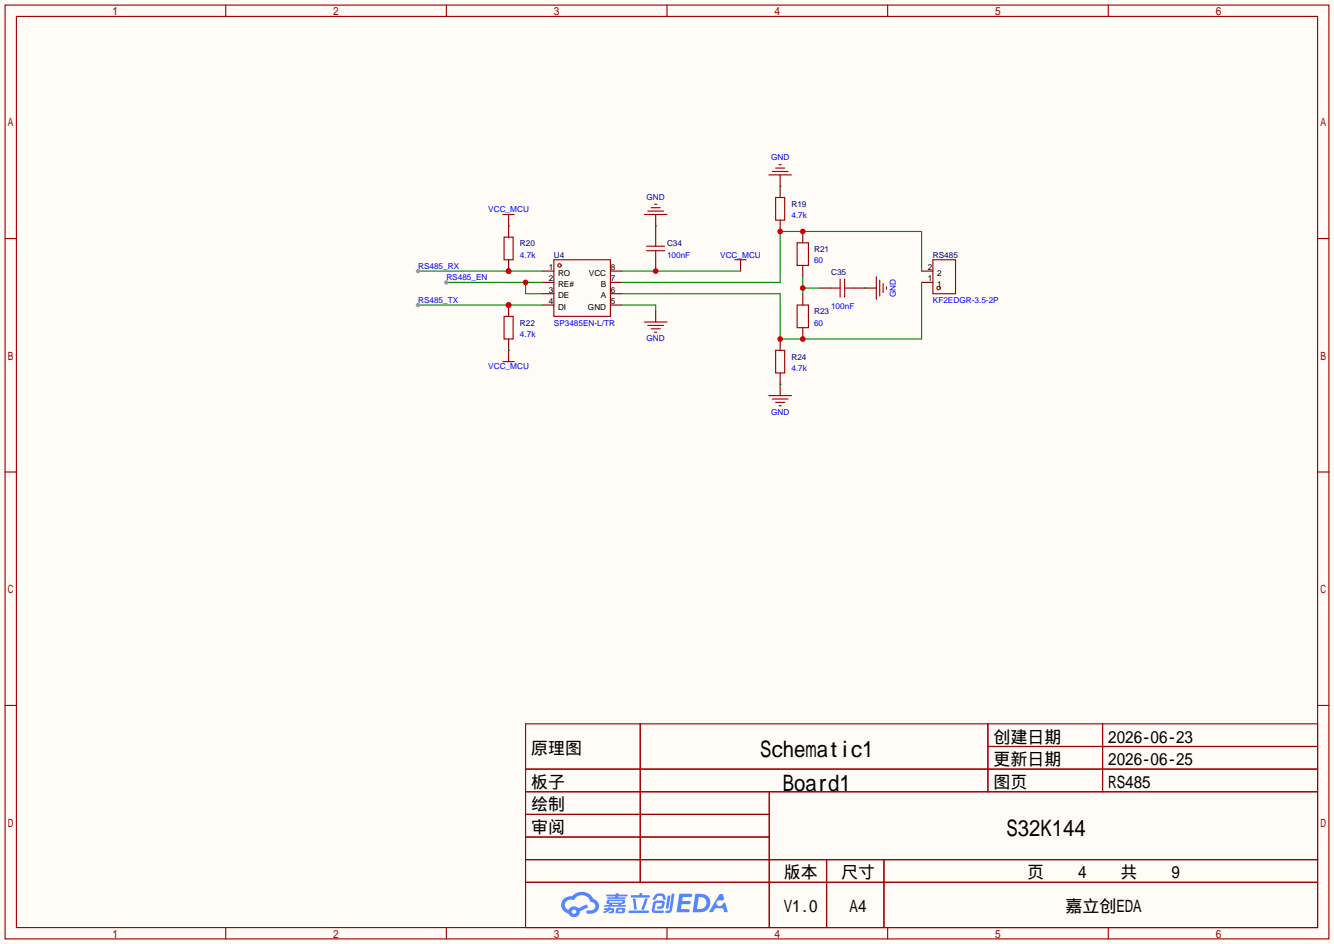
[picture p5: page 4]

原理图 | Schematic1 | 创建日期 | 2026-06-23

更新日期 | 2026-06-25

板子 | Board1 | 图页 | RS485
绘制 | | S32K144
审阅

# VCC_MCU GND GND C41

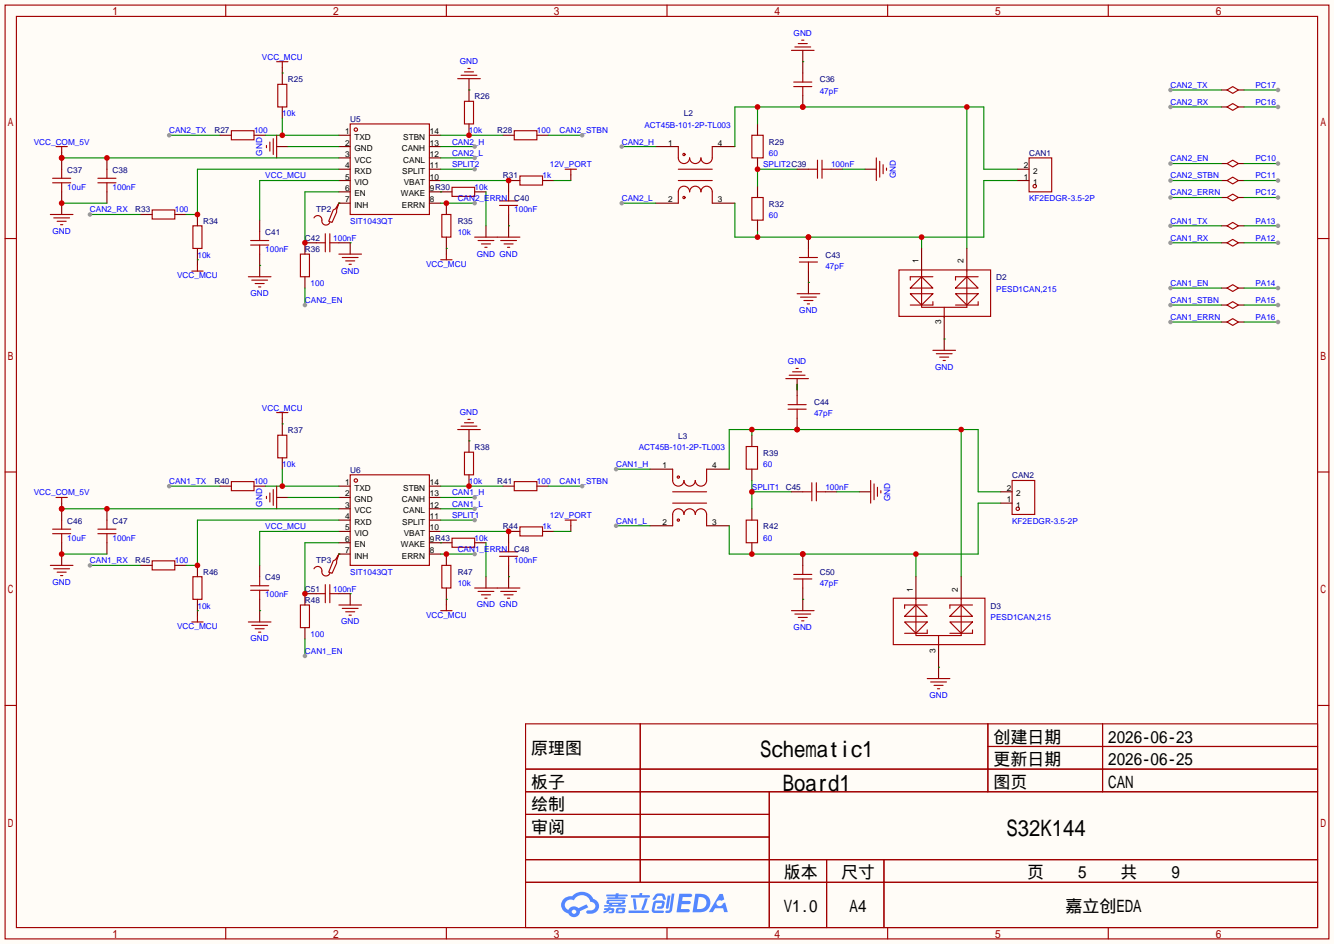
[picture p6: page 5]

VBAT 10 SPLIT 11 CANL 12 CANH 13 STBN 14

原理图 | Schematic1 | 创建日期 | 2026-06-23

更新日期 | 2026-06-25

板子 | Board1 | 图页 | CAN
绘制 | | S32K144
审阅

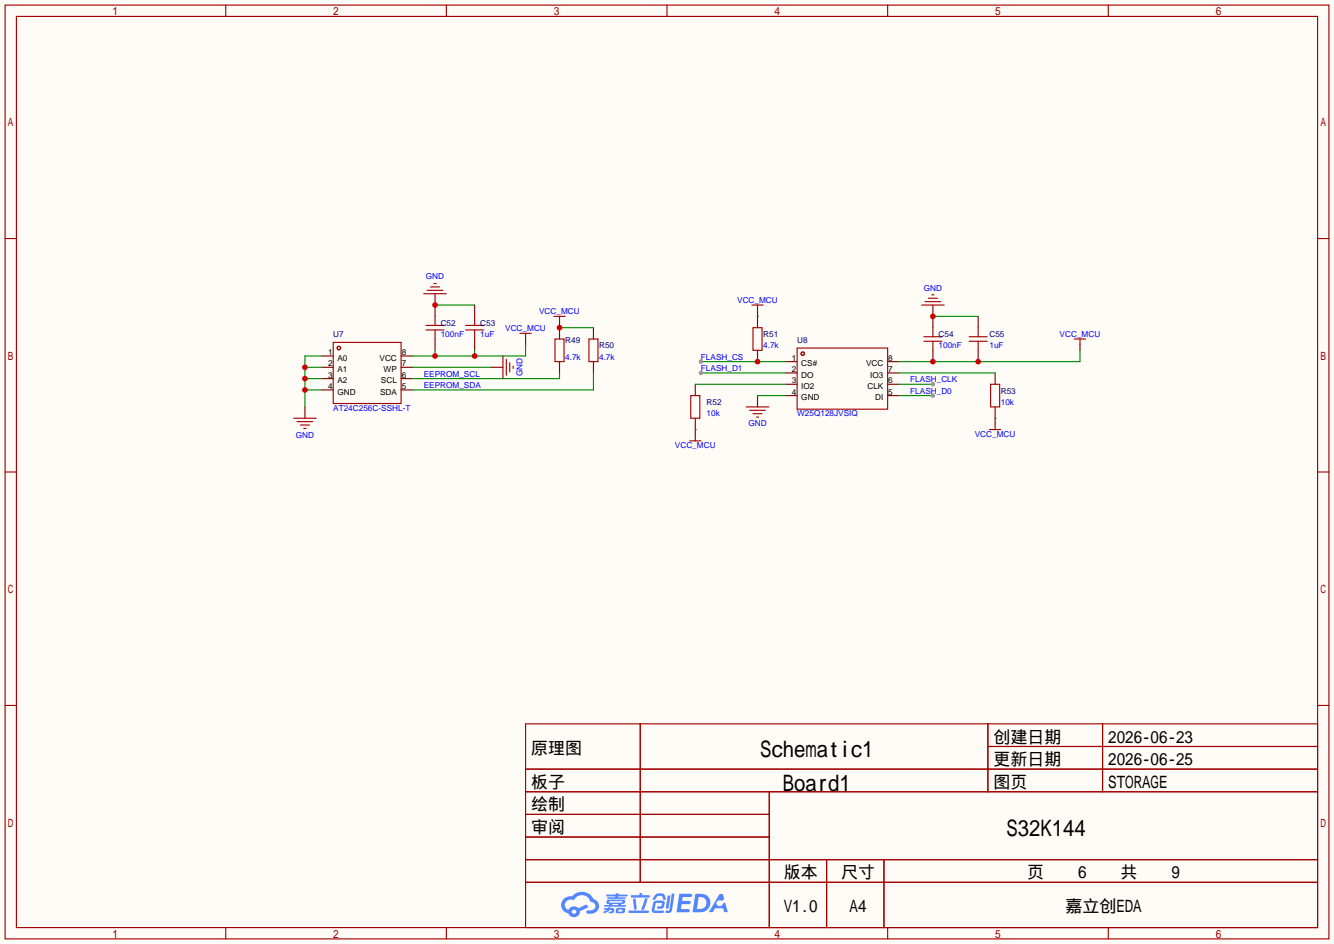
[picture p7: page 6]

原理图 | Schematic1 | 创建日期 | 2026-06-23

更新日期 | 2026-06-25

板子 | Board1 | 图页 | STORAGE
绘制 | | S32K144
审阅

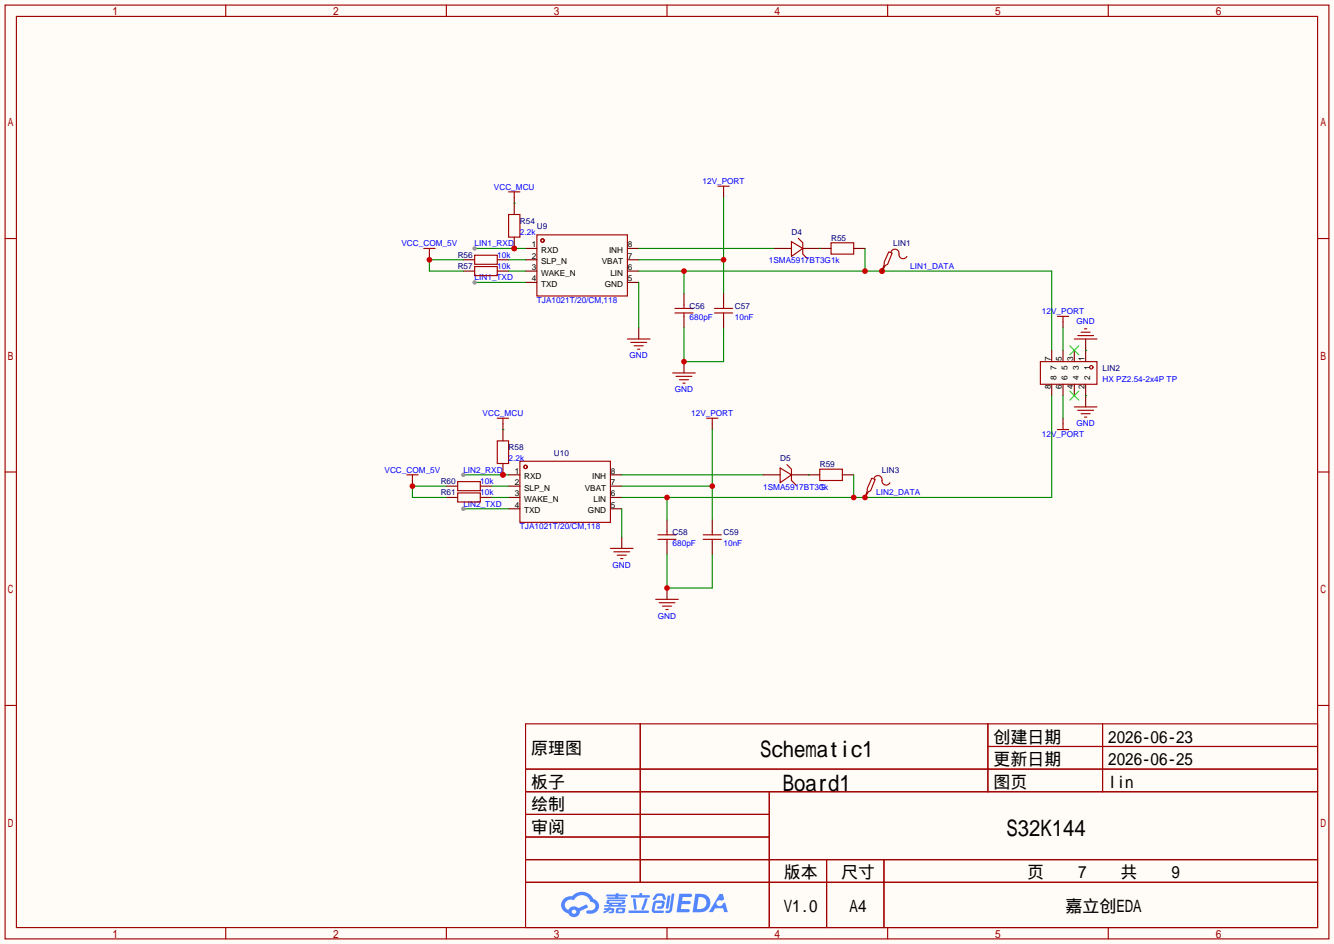
[picture p8: page 7]

原理图 | Schematic1 | 创建日期 | 2026-06-23

更新日期 | 2026-06-25

板子 | Board1 | 图页 | lin
绘制 | | S32K144
审阅

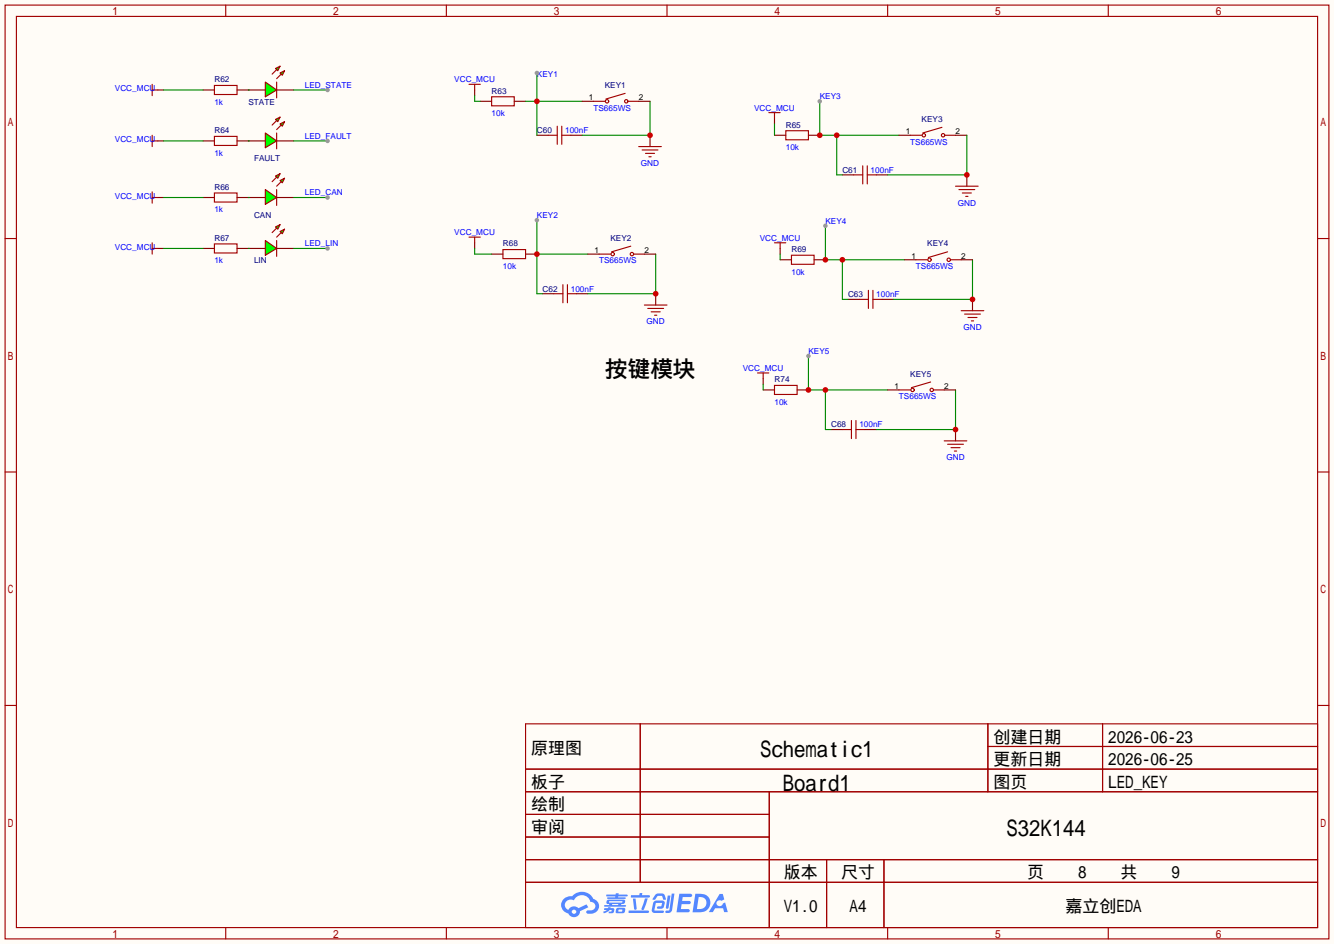
[picture p9: page 8]

原理图 | Schematic1 | 创建日期 | 2026-06-23

更新日期 | 2026-06-25

板子 | Board1 | 图页 | LED_KEY
绘制 | | S32K144
审阅

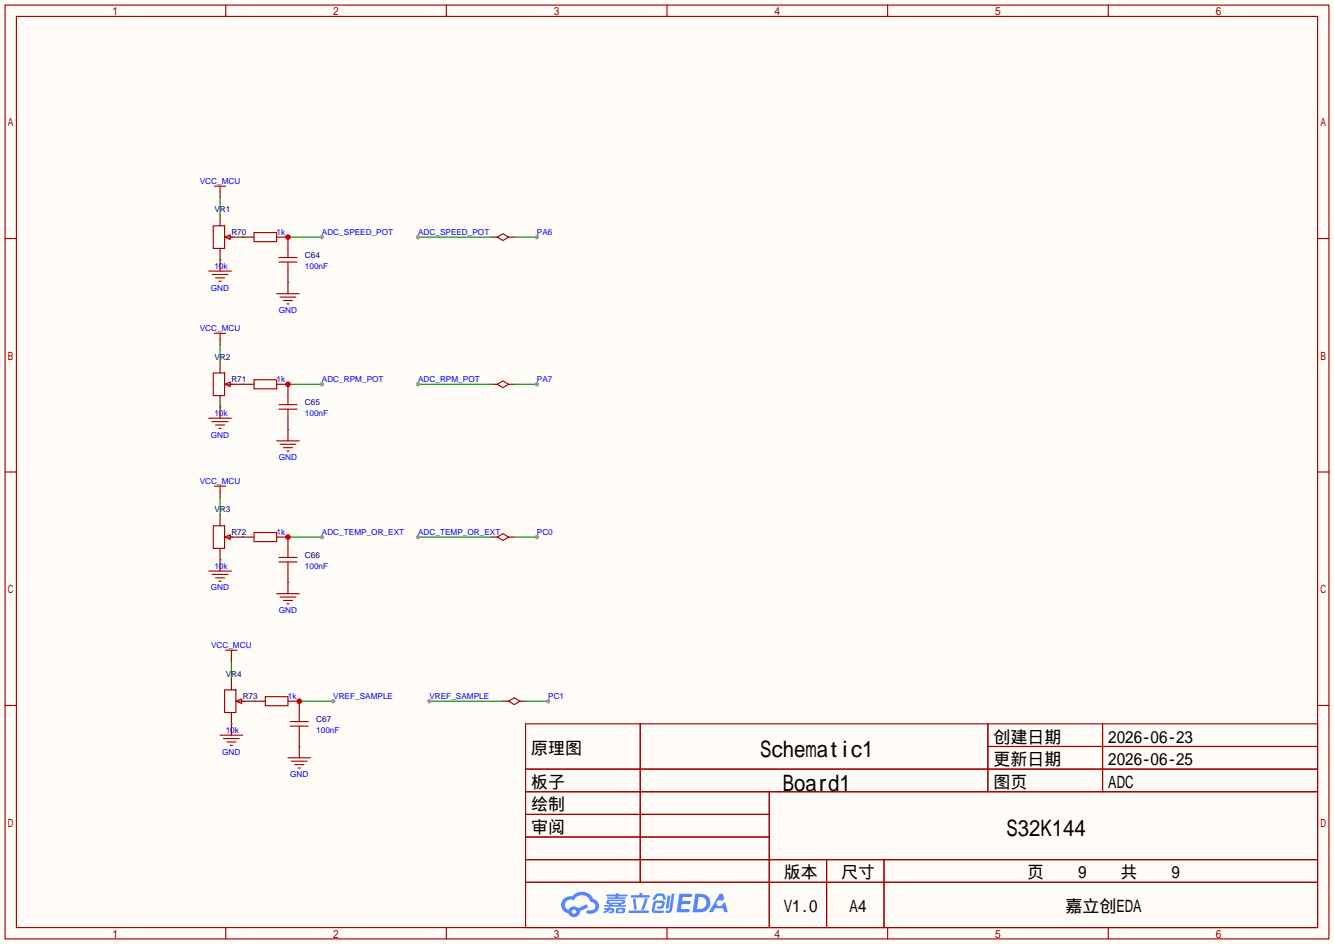
[picture p10: page 9]

原理图 | Schematic1 | 创建日期 | 2026-06-23

更新日期 | 2026-06-25

板子 | Board1 | 图页 | ADC
绘制 | | S32K144
审阅
