WHH3844/CAR_DASHBOARD/Bsw/Services/Dem/Dem.c

#include "Dem.h"

#include "LogM.h"
#include "NvM.h"

#define DEM_STATUS_TEST_FAILED              0x01u
#define DEM_STATUS_CONFIRMED_DTC            0x08u
#define DEM_STATUS_WARNING_INDICATOR        0x80u
#define DEM_NVM_BYTES_PER_EVENT             3u
#define DEM_NVM_PAYLOAD_SIZE                (DEM_EVENT_COUNT * DEM_NVM_BYTES_PER_EVENT)

static const Dem_EventConfigType Dem_EventConfigs[DEM_EVENT_COUNT] =
{
    /* event, DTC, level, lamp, failed threshold, passed threshold */
    {DEM_EVENT_LOW_SUPPLY_VOLTAGE,      0x010001u, 3u, 1u, 10u, 10u},
    {DEM_EVENT_HIGH_SUPPLY_VOLTAGE,     0x010002u, 3u, 1u, 10u, 10u},
    {DEM_EVENT_SDRAM_INIT_FAILED,       0x020001u, 3u, 1u, 1u, 1u},
    {DEM_EVENT_SDRAM_RW_TEST_FAILED,    0x020002u, 3u, 1u, 1u, 1u},
    {DEM_EVENT_LCD_INIT_FAILED,         0x030001u, 3u, 1u, 1u, 1u},
    {DEM_EVENT_FRAMEBUFFER_ABNORMAL,    0x030002u, 2u, 1u, 3u, 10u},
    {DEM_EVENT_CAN_BUS_OFF,             0x040001u, 3u, 1u, 1u, 5u},
    {DEM_EVENT_CAN_RX_TIMEOUT,          0x040002u, 2u, 1u, 1u, 5u},
    {DEM_EVENT_CAN_TRCV_ERROR,          0x040003u, 2u, 1u, 3u, 10u},
    {DEM_EVENT_EEPROM_COMM_FAILED,      0x050001u, 2u, 0u, 3u, 3u},
    {DEM_EVENT_EEPROM_CRC_FAILED,       0x050002u, 2u, 0u, 1u, 1u},
    {DEM_EVENT_RTC_COMM_FAILED,         0x060001u, 1u, 0u, 3u, 3u},
    {DEM_EVENT_RTC_TIME_INVALID,        0x060002u, 1u, 0u, 3u, 3u},
    {DEM_EVENT_SHT30_COMM_FAILED,       0x070001u, 1u, 0u, 3u, 3u},
    {DEM_EVENT_TF_CARD_MOUNT_FAILED,    0x080001u, 1u, 0u, 1u, 1u},
    {DEM_EVENT_POWER_HOLD_FAILED,       0x090001u, 3u, 1u, 3u, 3u},
    {DEM_EVENT_KEY_STUCK,               0x0A0001u, 1u, 0u, 3u, 3u},
    {DEM_EVENT_BUZZER_CONTROL_FAILED,   0x0B0001u, 1u, 0u, 3u, 3u},
    {DEM_EVENT_DISPLAY_TASK_OVERLOAD,   0x0C0001u, 2u, 0u, 3u, 10u},
    {DEM_EVENT_WATCHDOG_RESET_DETECTED, 0x0D0001u, 2u, 1u, 1u, 1u}
};

static uint8_t Dem_Status[DEM_EVENT_COUNT];
static uint16_t Dem_OccurrenceCounter[DEM_EVENT_COUNT];
static uint8_t Dem_FailedCounter[DEM_EVENT_COUNT];
static uint8_t Dem_PassedCounter[DEM_EVENT_COUNT];
static uint16_t Dem_LastFaultId;
static uint8_t Dem_Dirty;

static void Dem_LoadFromNvM(void)
{
    uint8_t payload[DEM_NVM_PAYLOAD_SIZE];
    uint8_t index;
    uint16_t pos;

    if (NvM_ReadBlock(NVM_BLOCK_DEM_STATUS, payload, sizeof(payload)) != E_OK)
    {
        /*
         * Dem 状态块首次不存在或 CRC 失败时，从全清状态开始。
         * Dirty 置位后周期任务会把这份干净状态写回 NvM，完成自修复。
         */
        for (index = 0u; index < DEM_EVENT_COUNT; index++)
        {
            Dem_Status[index] = 0u;
            Dem_OccurrenceCounter[index] = 0u;
            Dem_FailedCounter[index] = 0u;
            Dem_PassedCounter[index] = 0u;
        }
        Dem_LastFaultId = 0xFFFFu;
        Dem_Dirty = 1u;
        return;
    }

    for (index = 0u; index < DEM_EVENT_COUNT; index++)
    {
        /*
         * 每个事件用 3 字节持久化：
         * Byte0=status，Byte1-2=occurrence_counter little-endian。
         */
        pos = (uint16_t)(index * DEM_NVM_BYTES_PER_EVENT);
        Dem_Status[index] = payload[pos];
        Dem_OccurrenceCounter[index] = (uint16_t)((uint16_t)payload[pos + 1u] |
                                                  ((uint16_t)payload[pos + 2u] << 8u));
        Dem_FailedCounter[index] = 0u;
        Dem_PassedCounter[index] = 0u;
        if ((Dem_Status[index] & DEM_STATUS_CONFIRMED_DTC) != 0u)
        {
            /*
             * 旧 payload 没有 last-fault 时间字段。重启后只能选择已确认表项中
             * 最后一个 ID 作为可重复的恢复值；运行期的新确认会覆盖它。
             */
            Dem_LastFaultId = (uint16_t)index + 1u;
        }
    }
}

static void Dem_SaveToNvM(void)
{
    uint8_t payload[DEM_NVM_PAYLOAD_SIZE];
    uint8_t index;
    uint16_t pos;

    for (index = 0u; index < DEM_EVENT_COUNT; index++)
    {
        /* 保存格式与 Dem_LoadFromNvM 对称，保持 NvM payload 紧凑。 */
        pos = (uint16_t)(index * DEM_NVM_BYTES_PER_EVENT);
        payload[pos] = Dem_Status[index];
        payload[pos + 1u] = (uint8_t)(Dem_OccurrenceCounter[index] & 0xFFu);
        payload[pos + 2u] = (uint8_t)((Dem_OccurrenceCounter[index] >> 8u) & 0xFFu);
    }

    if (NvM_WriteBlock(NVM_BLOCK_DEM_STATUS, payload, sizeof(payload)) == E_OK)
    {
        Dem_Dirty = 0u;
    }
}

void Dem_Init(void)
{
    Dem_LastFaultId = 0xFFFFu;
    Dem_LoadFromNvM();
    LogM_Info("Dem init ok");
}

void Dem_MainFunction(uint32_t tick_ms)
{
    static uint32_t last_save_ms;

    if ((Dem_Dirty != 0u) && ((tick_ms - last_save_ms) >= 1000u))
    {
        /*
         * 故障状态可能在同一秒内多次变化，统一限频到 1s 写一次 EEPROM。
         * 关机路径会调用 Dem_SaveNow() 兜底保存最后一次变化。
         */
        last_save_ms = tick_ms;
        Dem_SaveToNvM();
    }
}

void Dem_SetEventStatus(Dem_EventIdType event_id, Dem_EventStatusType status)
{
    uint8_t old_status;
    const Dem_EventConfigType *config;

    if (event_id >= DEM_EVENT_COUNT)
    {
        return;
    }

    config = &Dem_EventConfigs[event_id];
    old_status = Dem_Status[event_id];

    if (status == DEM_EVENT_STATUS_FAILED)
    {
        Dem_PassedCounter[event_id] = 0u;
        if (Dem_FailedCounter[event_id] < config->failed_threshold)
        {
            Dem_FailedCounter[event_id]++;
        }

        /*
         * 只有连续失败达到事件阈值才确认。阈值到达前只保留 RAM 去抖计数，
         * 不改变 UDS 状态，也不触发 EEPROM 写入。
         */
        if ((Dem_FailedCounter[event_id] >= config->failed_threshold) &&
            ((old_status & DEM_STATUS_TEST_FAILED) == 0u))
        {
            if (Dem_OccurrenceCounter[event_id] < 0xFFFFu)
            {
                Dem_OccurrenceCounter[event_id]++;
            }

            Dem_Status[event_id] |= DEM_STATUS_TEST_FAILED | DEM_STATUS_CONFIRMED_DTC;
            if (config->lamp_flag != 0u)
            {
                Dem_Status[event_id] |= DEM_STATUS_WARNING_INDICATOR;
            }
            Dem_LastFaultId = (uint16_t)event_id + 1u;
        }
    }
    else
    {
        Dem_FailedCounter[event_id] = 0u;
        /*
         * 连续通过达到恢复阈值才清 testFailed；confirmedDTC、warningIndicator
         * 和发生次数仍保留，直到 0x14 清除。
         */
        if ((old_status & DEM_STATUS_TEST_FAILED) != 0u)
        {
            if (Dem_PassedCounter[event_id] < config->passed_threshold)
            {
                Dem_PassedCounter[event_id]++;
            }
            if (Dem_PassedCounter[event_id] >= config->passed_threshold)
            {
                Dem_Status[event_id] &= (uint8_t)(~DEM_STATUS_TEST_FAILED);
                Dem_PassedCounter[event_id] = 0u;
            }
        }
        else
        {
            Dem_PassedCounter[event_id] = 0u;
        }
    }

    if (old_status != Dem_Status[event_id])
    {
        Dem_Dirty = 1u;
    }
}

uint8_t Dem_GetDtcCountByStatusMask(uint8_t status_mask)
{
    uint8_t index;
    uint8_t count;

    count = 0u;
    for (index = 0u; index < DEM_EVENT_COUNT; index++)
    {
        if ((Dem_Status[index] & status_mask) != 0u)
        {
            count++;
        }
    }

    return count;
}

Std_ReturnType Dem_GetFirstDtcByStatusMask(uint8_t status_mask, Dem_DtcRecordType *record)
{
    uint8_t index;

    if (record == 0)
    {
        return E_NOT_OK;
    }

    for (index = 0u; index < DEM_EVENT_COUNT; index++)
    {
        if ((Dem_Status[index] & status_mask) != 0u)
        {
            record->dtc = Dem_EventConfigs[index].dtc;
            record->status = Dem_Status[index];
            record->occurrence_counter = Dem_OccurrenceCounter[index];
            return E_OK;
        }
    }

    return E_NOT_OK;
}

uint8_t Dem_GetConfirmedDtcCount(void)
{
    return Dem_GetDtcCountByStatusMask(DEM_STATUS_CONFIRMED_DTC);
}

uint16_t Dem_GetLastFaultId(void)
{
    return Dem_LastFaultId;
}

uint16_t Dem_GetOccurrenceCounter(Dem_EventIdType event_id)
{
    if (event_id >= DEM_EVENT_COUNT)
    {
        return 0u;
    }

    return Dem_OccurrenceCounter[event_id];
}

uint8_t Dem_IsEventFailed(Dem_EventIdType event_id)
{
    if (event_id >= DEM_EVENT_COUNT)
    {
        return 0u;
    }

    return ((Dem_Status[event_id] & DEM_STATUS_TEST_FAILED) != 0u) ? 1u : 0u;
}

uint8_t Dem_IsDirty(void)
{
    return Dem_Dirty;
}

void Dem_ClearAllDtc(void)
{
    uint8_t index;

    for (index = 0u; index < DEM_EVENT_COUNT; index++)
    {
        Dem_Status[index] = 0u;
        Dem_OccurrenceCounter[index] = 0u;
        Dem_FailedCounter[index] = 0u;
        Dem_PassedCounter[index] = 0u;
    }

    Dem_LastFaultId = 0xFFFFu;
    Dem_Dirty = 1u;
    Dem_SaveToNvM();
}

void Dem_SaveNow(void)
{
    if (Dem_Dirty != 0u)
    {
        Dem_SaveToNvM();
    }
}
